gcharvin/esp32_temperature_controller_platformio/hardware/manufacturing/online_quote_20261110/placement_B_preview.png

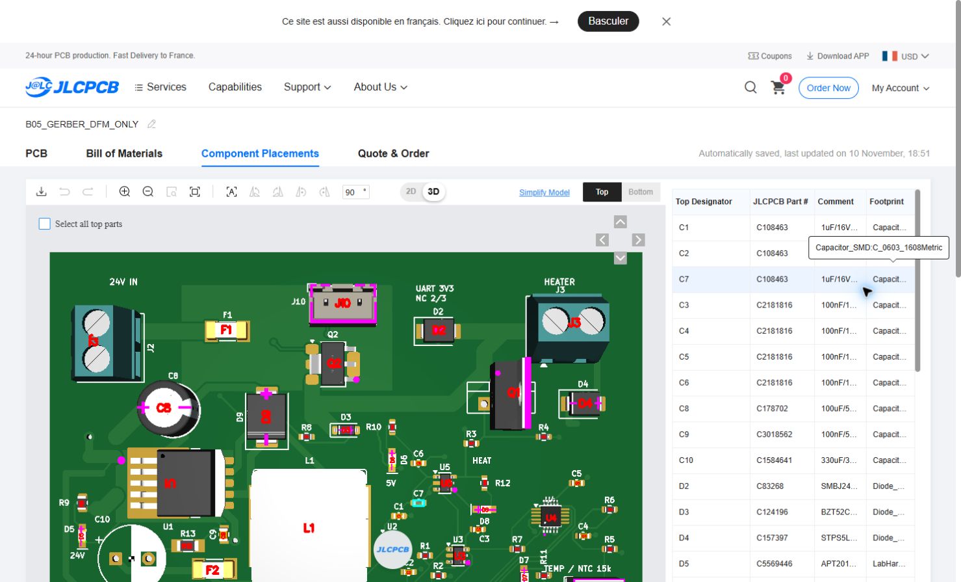
hardware/manufacturing/online_quote_20261110/placement_B_preview.png
