gcharvin/esp32_temperature_controller_platformio/hardware/review/stock_revision_pcb_B_3d.png

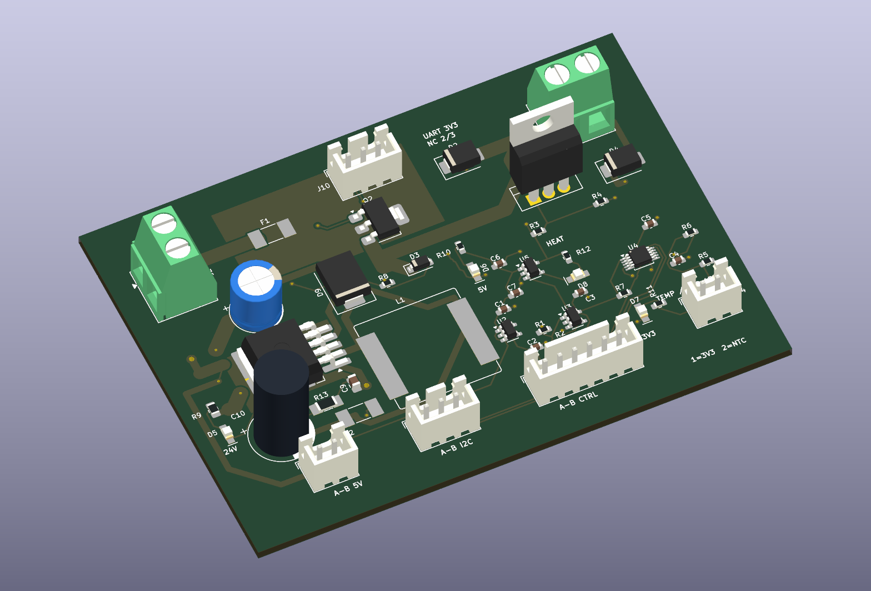
hardware/review/stock_revision_pcb_B_3d.png
