gcharvin/esp32_temperature_controller_platformio/hardware/review/pcb_a_display.pdf

1 | 2 | 3 | 4 | 5 | 6 | 7 | 8
1 | 2 | 3 | 4 | 5 | 6 | 7 | 8

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
## FG Date: 2026-11-05

Size: User | Rev: 0.4
KiCad E.D.A. 10.0.6 | Id: 1/1

# Title: PCB A - Display and ESP32 carrier

## File: pcb_a_display.kicad_sch

## Sheet: /

## Laboratory hardware platform

## PROTOTYPE - ENGINEERING PREPARED - ASSEMBLER APPROVAL REQUIRED

EN 1 | GPIO36 2 | GPIO39 3 | GPIO34 4 | GPIO35 5 | GPIO32 6 | GPIO33 7 | GPIO25 8 | GPIO26 9 | GPIO27 10 | GPIO14 11 | GPIO12 12 | GPIO13 13 | GND 14

VIN 15

3V3 | 16 GND | 17 GPIO15 | 18 GPIO2 | 19 GPIO4 | 20 GPIO16 | 21 GPIO17 | 22 GPIO5 | 23 GPIO18 | 24 GPIO19 | 25 GPIO21 | 26 GPIO3 | 27 GPIO1 | 28 GPIO22 | 29 GPIO23 | 30 U1

### ESP32 USB-C / 30P user module

R3

10kC2

1uF | #FLG01 PWR_FLAG

1
2

J1
A-B POWER / XH-2 | #FLG02 PWR_FLAG

R2
10k | 1

2
3
4

### J5BH1750 module / addr 0x23

### #FLG03 PWR_FLAG

1
2
3

J6

### A-B I2C / XH-3

1
2

JP1

5V DevKit link / remove for service

R6
1.5k / 1% / 0.1W

C1
1uF

D2

### APT2012LZGCK

R1

10k | 1
| 2
| 3
| 4

J4

### TMP117 module / addr 0x48

1
2
3
4

J2

### LCD20x4 + backpack / 3V3 R5

4.7k D1

### APT2012LZGCK

### VIN 1 GND

2

EN 3

### VOUT 5 U2 AP2112K-3.3 peripherals 1

2
3
4

J3

### Encoder / A B SW GND

R7
470R / 1% / 0.1W

1
2
3
4
5
6

J7

### A-B CTRL / XH-6 C3

# 10uF R4

4.7k +3V3_A

I2C_SDA

I2C_SCL

LED_A_D1

GND | +5V_AB GND

GND

PWM0

ENABLE

FAULT_N

PWM1 GND LED_A_D2 +3V3_A ENC_B | +3V3_A ENC_SW
DIN0 +3V3_A | +5V_DEVKIT I2C_SDA
ENC_A | GND +3V3_A I2C_SCL | GND +3V3_A

I2C_SDA

I2C_SCL

DIN0

GND

FAULT_N

PWM0 PWM1

ENABLE

+3V3_A

I2C_SDA

# I2C_SCL GND

I2C_SDA

I2C_SCL

+3V3_A | +3V3_A
GND | GND
+5V_DEVKIT | +5V_AB GND | +3V3_A

+5V_AB

GND +5V_DEVKIT | +5V_AB +5V_AB

GND

# ENC_A GND

# ENC_B GND

# I2C_SDA +5V_AB

I2C_SCL ENC_SW +5V_AB

ENC_B

ENC_SW

# GND +3V3_A ENC_A +5V_AB

# A3 - USER INPUT / I2C PERIPHERALS

Green LEDs show rail presence only, not regulated voltage accuracy or ESP32 execution. HEAT (B/D8): 5 V driver output after PWM AND ENABLE; brightness follows duty, NOT measured heater current. NTC on B/J4: 1 = +3V3_B, 2 = NTC_RAW; passive two-wire 15k B3920 probe, either wire orientation.

JP1 fitted in normal use. Do not parallel external 5 V and USB VBUS. USB maintenance: B off, disconnect J1/J6/J7, remove JP1; no peripheral operation in this mode. Powered serial debugging requires a verified VBUS-isolated USB connection. No automatic power mux. A2 - LOCAL POWER / LCD 3.3 V AS CURRENT PROTOTYPE

U1 is a removable DevKit, not a bare ESP32. Common 30P pinout; row spacing25.40mm confirmed. Two Harwin M20-7821546 sockets. | J1 POWER: 1 GND / 2 +5V. J6 I2C: 1 GND / 2 SDA / 3 SCL. J7 CTRL: 1 GND / 2 PWM0 / 3 ENABLE / 4 FAULT_N / 5 PWM1 / 6 DIN0. Straight-through cables, JST-XH 2.50 mm. NO 24 V, heater current or 3V3 rail. A1 - HOST AND COMMON INTERFACE / LOGIC 3.3 V

## D2 / 3V3_A

# DIAGNOSTICS - RAIL PRESENCE AND HEATER GATE DRIVE

Only R4/R5 are the main I2C pull-ups. Remove or account for pull-ups on all breakout modules and LCD. DevKit 3V3 is not joined to +3V3_A. U2 supplies peripherals only; check current and thermal budget.

I2C cable A-B: short internal harness. ADC on B = 0x49, TMP117 on A = 0x48.

LCD header order is a proposed cable order. Check actual backpack pin order, 3.3 V operation

and backlight current before PCB layout.

## D1 / 5V_AB
