gcharvin/esp32_temperature_controller_platformio/hardware/review/implantation_v01.pdf

# Carte A : facade et ESP32

110 x 75 mm | epaisseur proposee 1.6 mm | vue cote composants

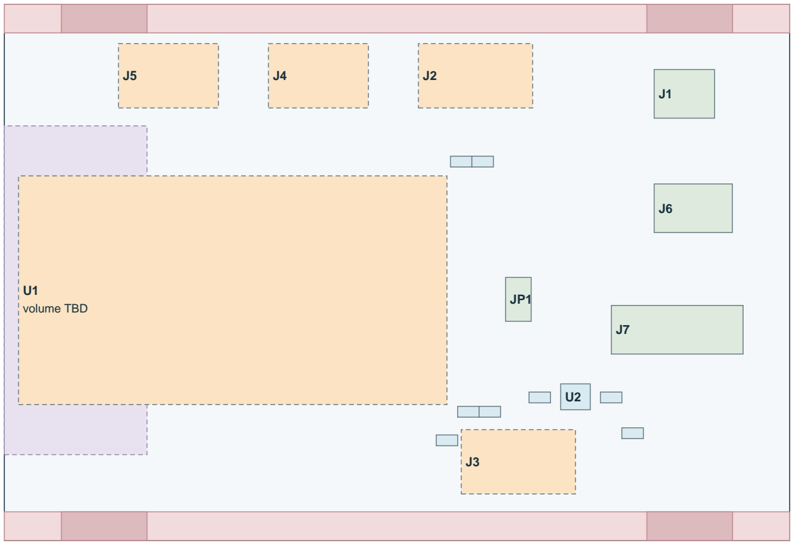
[picture p3: figure]
U1 volume TBD

ETUDE 0.1 - COTES PROPOSEES - NON ROUTE - NE PAS FABRIQUER | 1/3

110 mm

Hauteur 75 mm ; origine (0,0) en haut a gauche.

### Fixation sans vis

Bandes haut/bas : 4 mm.
Zones de contact : 12 x 4 mm. Appuis fixes + clips liberables. Pas de trous imposes a ce stade.

### Connecteurs vers arriere

J1 : 5 V / JST-XH 2 points.
J6 : I2C / JST-XH 3 points.
J7 : commandes / XH 6 points. Degagement axial vise : 25 mm. Cables debranches hors tension.

DevKit : volume 60 x 32 mm. Antenne au bord gauche.
USB : zone de service interne. LCD et encodeur sur facade, relies par cables a A.

Legende

TBD, sans pastilles

Empreinte connecteur

Empreinte CMS connue

Les rectangles representent les encombrements au sol ; reperes R/C detailles dans KiCad.

# Carte B : temperature et puissance

90 x 65 mm | epaisseur proposee 1.6 mm | vue cote composants
ETUDE 0.1 - COTES PROPOSEES - NON ROUTE - NE PAS FABRIQUER | 2/3

90 mm

Hauteur 65 mm ; origine (0,0) en haut a gauche.

U1
volume TBD

U2

U3

U4 Q1

J2 | F1 | D1 | D2 | J3

J4

J1 | J6 | J7

### Fixation sans vis

Bandes haut/bas : 4 mm.
Zones de contact : 12 x 4 mm. Appuis fixes + clips liberables. Pas de trous imposes a ce stade.

### Connecteurs vers arriere

J1 : 5 V / JST-XH 2 points.
J6 : I2C / JST-XH 3 points.
J7 : commandes / XH 6 points. Degagement axial vise : 25 mm. Cables debranches hors tension.

Puissance en partie haute.
ADC / sonde a droite.
Buck reserve : 30 x 22 mm. B se retire vers arriere.
Dissipation a dimensionner.

Legende

TBD, sans pastilles

Empreinte connecteur

Empreinte CMS connue

Les rectangles representent les encombrements au sol ; reperes R/C detailles dans KiCad.

# Boitier propose : deux logements independants

145 L x 100 H x 115 P mm exterieurs | parois 3 mm | schema mecanique de principe
ETUDE 0.1 - COTES PROPOSEES - NON ROUTE - NE PAS FABRIQUER | 3/3

## Facade, vue de face

145 mm

LCD : reserve 98 x 60

Encodeur

H = 100 mm ; decoupe LCD exacte a mesurer.

LCD 98 x 60 mm : exemple de format courant, pas une mesure de ton module. Fenetre optique et bouton representes a titre indicatif.
Facade / LCD sur leur propre berceau, sans appui sur la DevKit.

## Coupe laterale (profondeur)

115 mm

LCD

A
B

AR amovible

Plans composants A/B a 45 / 85 mm. Budget composants arriere : 20 mm. Service JST : 25 mm, couvercle ouvert. B extractible sans deposer A / facade. Jeux et clips : essais imprimes requis.
