gcharvin/esp32_temperature_controller_platformio/hardware/power_study/buck_5v/buck_5v.pdf

1 | 2 | 3 | 4 | 5 | 6 | 7 | 8
1 | 2 | 3 | 4 | 5 | 6 | 7 | 8

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
Size: A3 | Rev: 0.1 STUDY | F Date: 2026-11-05
KiCad E.D.A. 10.0.6 | Id: 1/1

# Title: STUDY ONLY - Integrated 24V to 5V buck for PCB B

## File: buck_5v.kicad_sch

## Sheet: /

R1
100k / 0805

1
2

### JP1 CLOSE TO DISABLE BUCK

R2

### 100k / 1% GND

1

### VIN 2

EN 3 | PG | 4
| FB | 5
VCC 6 | BOOT | 7
SW | 8 U1

### LMR36520ADDAR

C7

### 22uF / 25V X5R

### #FLG3 PWR_FLAG

### #FLG1 PWR_FLAG

C2

4.7uF / 100V X7S | C3 220nF / 100V X7R

L1

### 10uH / XAL6060-103MEC

C8

### 22uF / 25V X5R

C9

### 22uF / 25V X5R

R4
100k / 1%

1
2

J2

### TO B / F2 INPUT #FLG2 PWR_FLAG

R3
24.9k / 1%

1
2

J1
FROM B / protected input | C1
4.7uF / 100V X7S | C4

# 100nF / 25V C5

1uF / 25V | C6 22uF / 25V X5R
VIN_PROTECTED | GND | GND BUCK_EN | VIN_PROTECTED
BUCK_EN | BOOT
VCC_INTERNAL | SW
PG_5V_TP | VIN_PROTECTED | +5V_BUCK GND

BUCK_EN

FB GND | +5V_BUCK
BOOT SW | VIN_PROTECTED

GND

VIN_PROTECTED | VIN_PROTECTED
GND | GND | GND +5V_BUCK | +5V_BUCK GND | GND VIN_PROTECTED | +5V_BUCK GND +5V_BUCK | FB GND VCC_INTERNAL | PG_5V_TPFB | +5V_BUCK

GND

SW | GND | +5V_BUCK | +5V_BUCK

No manufacturing release: PCB layout, capacitor DC bias, thermal pad/vias, USB power sharing, sourcing and bench tests pending.

## POWER STUDY 0.1 - 5V / 0.8A SYSTEM TARGET, 2A CONVERTER RATING

OUTPUT: +5V_BUCK -> existing F2 (1A) -> +5V_AB -> A/B electronics. Heater power stays on protected 24V. VCC_INTERNAL is not an external 5V output. PG_5V_TP is a 5V-domain scope point, not ESP32-safe. Final integration must pull PG to 3V3 if used by MCU, and deliberately connect logic/power returns; no CC shunt remains.

Proposal only: not installed or routed on PCB B v0.4. Read README.md before integration. Protected 24V input. Common ground proposal replaces the external CC/CV module and its possible shunt.

Nominal output: 1V * (1 + 100k / 24.9k) = 5.016V. 4 x 22uF output bank; simulate 44uF effective worst case. Model: TI SNVMBX7A / LMR36520A_TRANS, unencrypted PSpice. Temperature and enclosure cooling are not modeled. Native ngspice attempts are documented as NON-CONVERGENT, not successful functional validation.
