gcharvin/esp32_temperature_controller_platformio/hardware/mechanical/exports/preview_b_power.png

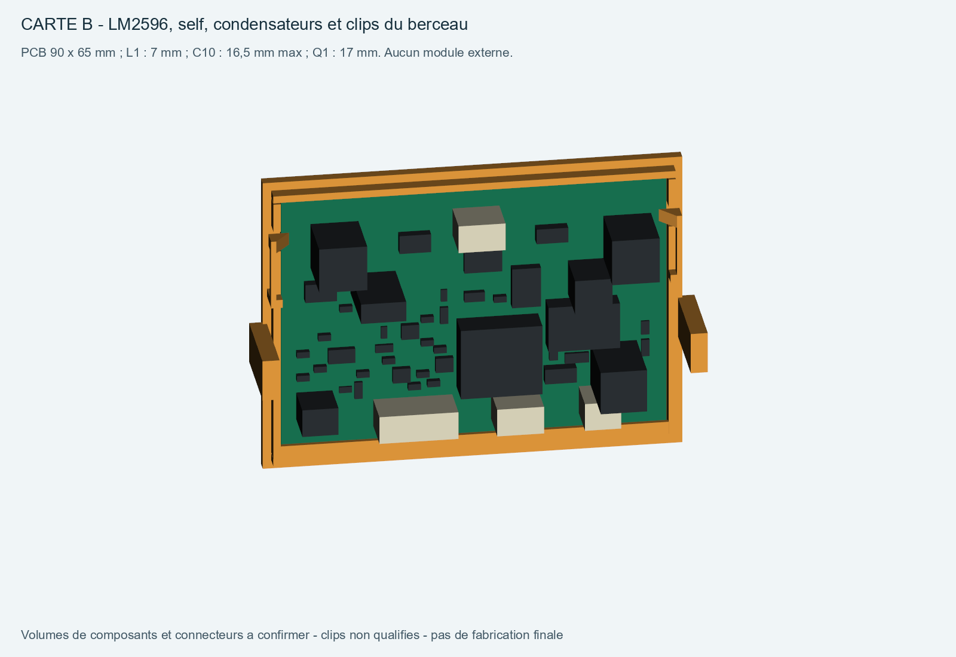
hardware/mechanical/exports/preview_b_power.png
