gcharvin/esp32_temperature_controller_platformio/hardware/mechanical/exports/preview_buck.png

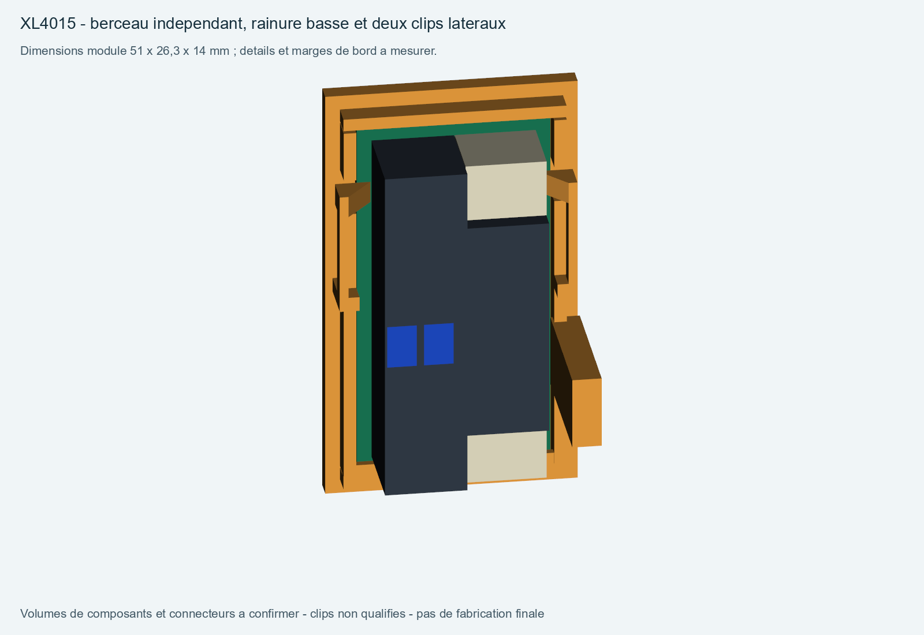
hardware/mechanical/exports/preview_buck.png
