gcharvin/esp32_temperature_controller_platformio/hardware/mechanical/exports/preview_front_module.png

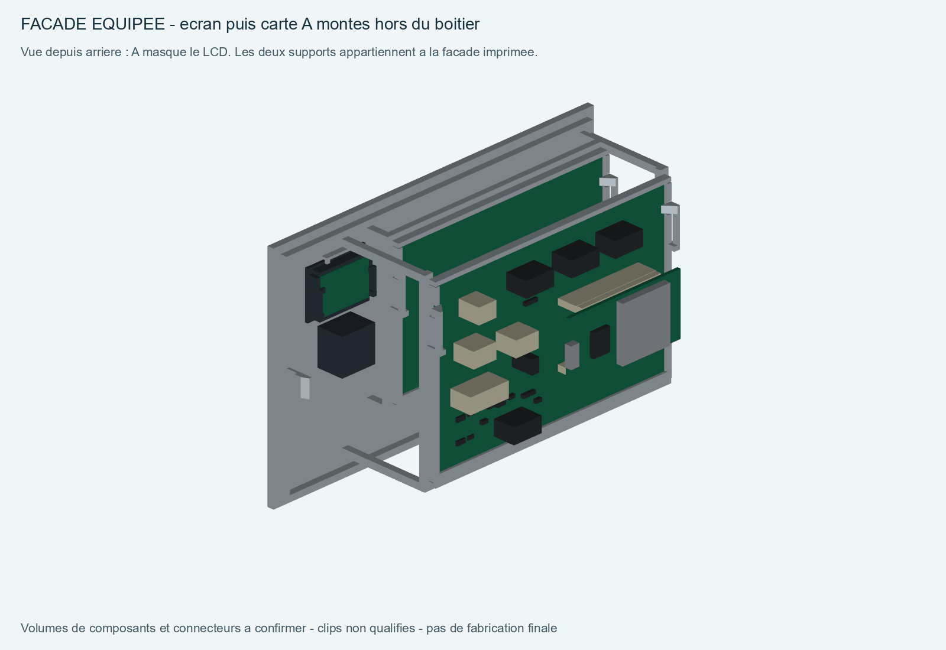
hardware/mechanical/exports/preview_front_module.png
