gcharvin/esp32_temperature_controller_platformio/hardware/mechanical/exports/preview_lcd_mount.png

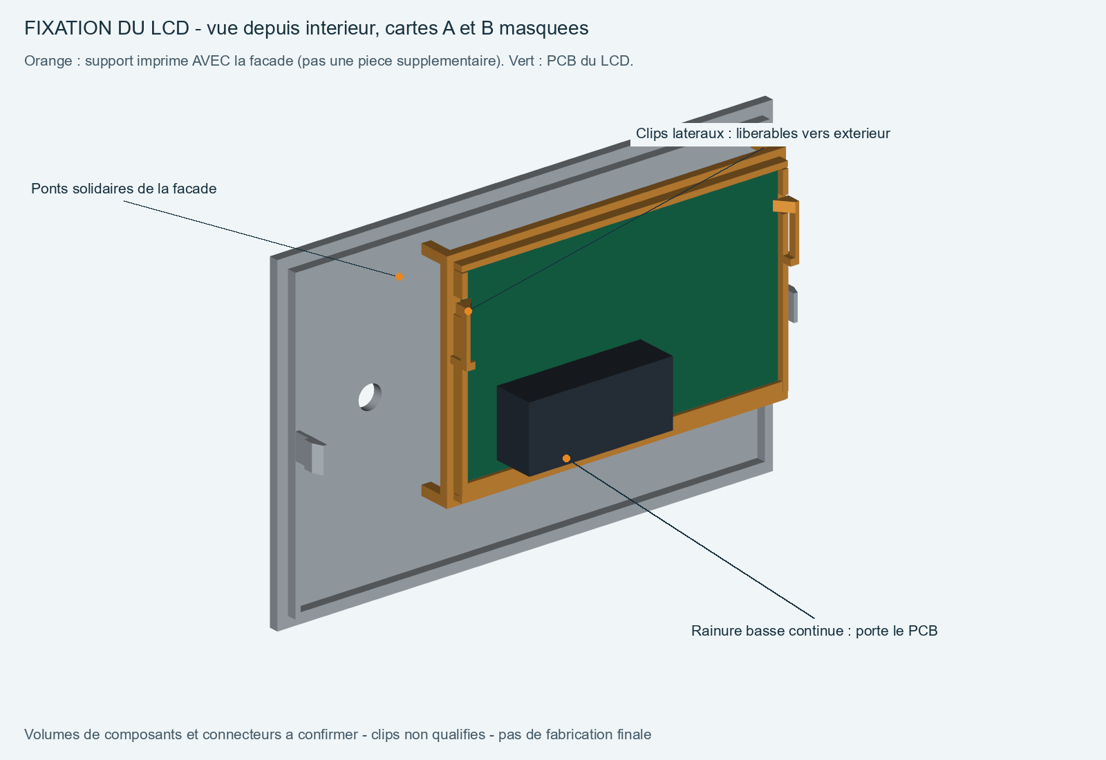
hardware/mechanical/exports/preview_lcd_mount.png
