gcharvin/esp32_temperature_controller_platformio/hardware/mechanical/exports/preview_light_sensor.png

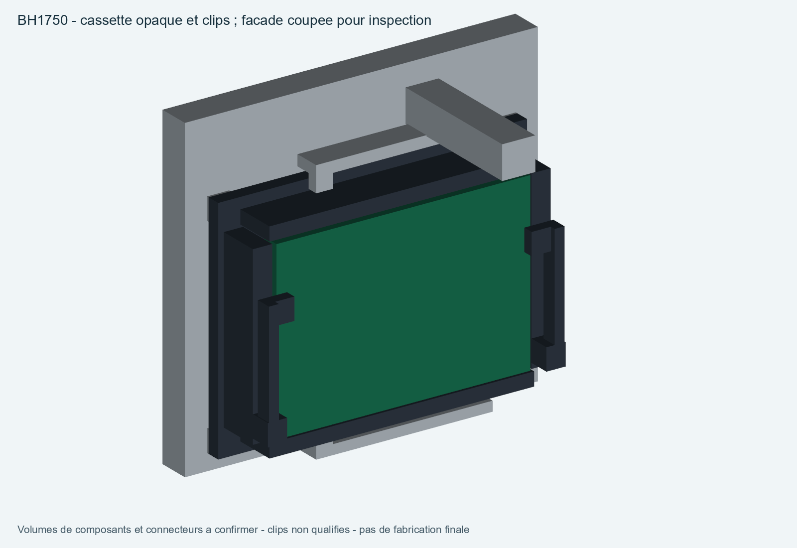
hardware/mechanical/exports/preview_light_sensor.png
