gcharvin/esp32_temperature_controller_platformio/hardware/mechanical/exports/preview_light_sensor_front.png

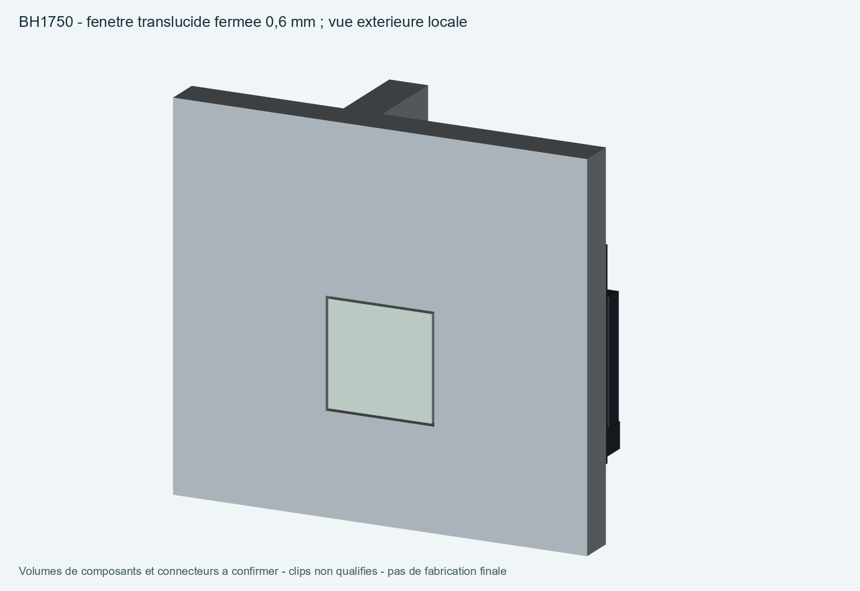
hardware/mechanical/exports/preview_light_sensor_front.png
