gcharvin/esp32_temperature_controller_platformio/hardware/mechanical/exports/preview_rear.png

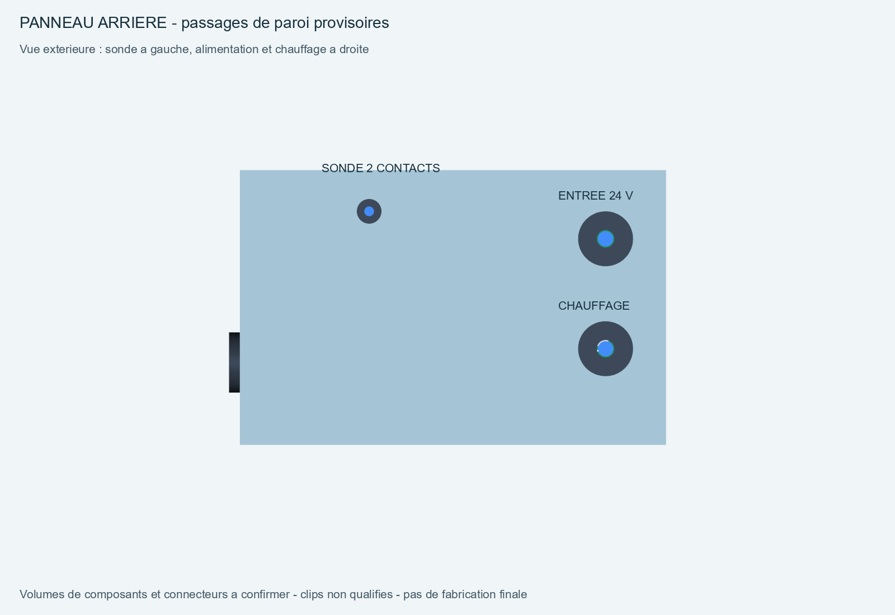
hardware/mechanical/exports/preview_rear.png
