gcharvin/esp32_temperature_controller_platformio/hardware/mechanical/exports/preview_service.png

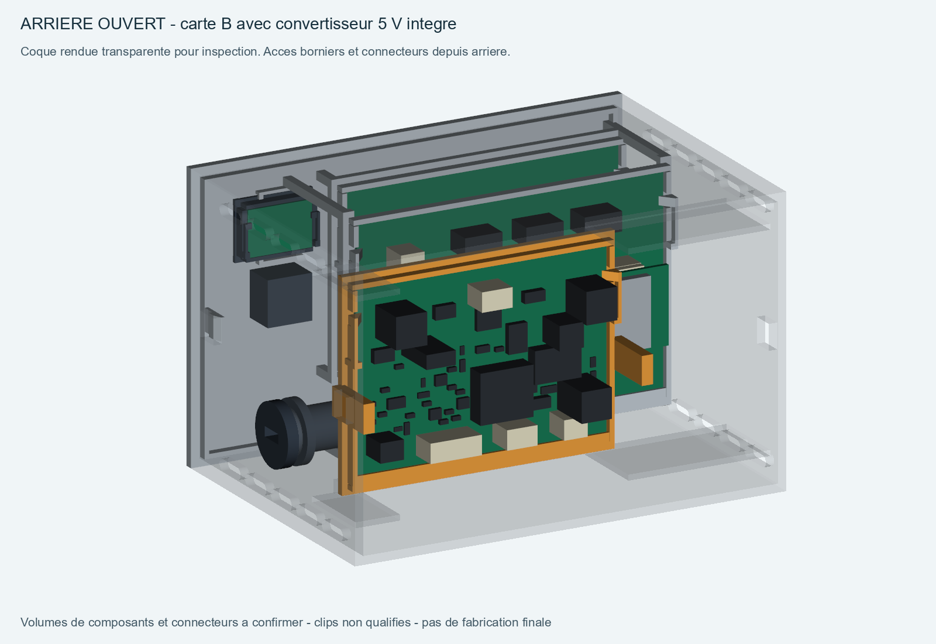
hardware/mechanical/exports/preview_service.png
