gcharvin/esp32_temperature_controller_platformio/hardware/mechanical/exports/preview_side_vents.png

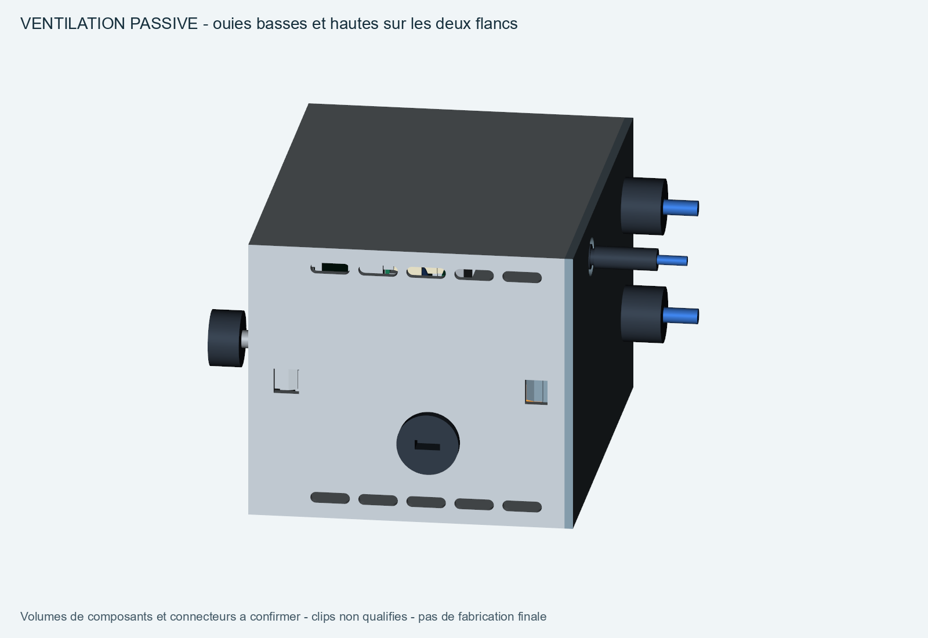
hardware/mechanical/exports/preview_side_vents.png
