gcharvin/esp32_temperature_controller_platformio/hardware/mechanical/exports/preview_usb.png

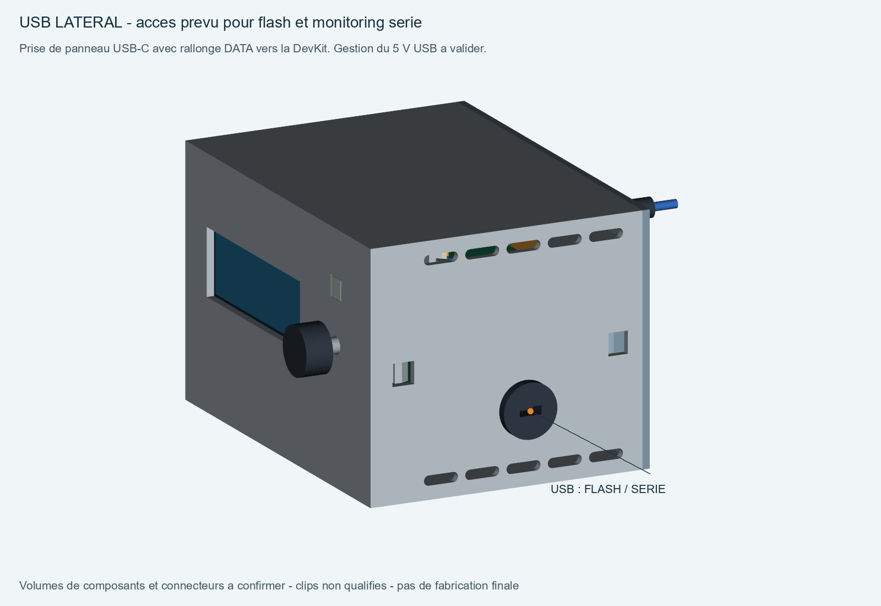
hardware/mechanical/exports/preview_usb.png
