gcharvin/esp32_temperature_controller_platformio/PartList_PCB_A_B_v2.xlsx

Sheet: PCB_A_UI
Item | Sous-systeme | Reference type | MPN (primary) | LCSC | Mouser | Prix unitaire USD (indicatif) | Empreinte KiCad | Qte | Statut | Notes | Assemble_JLC | JLC_Type | LCSC_Status | JLC_Notes
A1 | Cerveau | ESP32 DevKit NodeMCU (ELEGOO CP2102, USB-C) | ESP32-DEVKITC-32D (ou equivalent) | N/A | N/A | 6.00-12.00 | Connector_PinSocket_2.54mm:PinSocket_1x15_P2.54mm_Vertical (x2) | 1 | Obligatoire | Conforme au setup actuel: board nodemcu-32s. DevKit achete assemble. | No | N/A | N/A | Module externe (DevKit complet)
A2 | Support DevKit | Headers femelles 2x15, pas 2.54 mm | SSW-115-01-T-S (ou equivalent) | TBD | TBD | 0.30-1.20 | Connector_PinSocket_2.54mm:PinSocket_1x15_P2.54mm_Vertical | 2 | Obligatoire | Verifier entraxe exact du modele DevKit retenu. | No | N/A | N/A | Connecteur mecanique, option selon strategie assemblage
A3 | Entree alim | Bornier VIN 2 pins 5.08 mm | KF301-2P (ou equivalent) | TBD | TBD | 0.08-0.35 | TerminalBlock_Phoenix:TerminalBlock_Phoenix_MKDS-1,5-2_5.08mm | 1 | Obligatoire | VIN cible 12V, marge recommandee jusqu a 24V. | Yes | THT/Manual | Missing | Completer un code LCSC (Cxxxx) pour PCBA auto.
A4 | Conversion puissance | Buck VIN -> 5V | MP1584EN module (ou LM2596 module) | TBD | TBD | 1.20-3.50 | Custom_Module_Footprint | 1 | Obligatoire | Alimente pin 5V du DevKit et peripheriques 5V. | No | N/A | N/A | Module buck pre-assemble ou design discret a figer
A5 | Protection entree | TVS + polyfuse + PMOS anti inversion | SMBJ33A + MF-MSMF050 + AO4407A | TBD | TBD | 0.70-1.50 | D_SMB + Fuse_1812_4532Metric + SO-8_3.9x4.9mm_P1.27mm | 1 | Recommande | Dimensionner selon courant max et tension transitoire. | Yes | SMT+THT mix | Missing | Completer un code LCSC (Cxxxx) pour PCBA auto.
A6 | Affichage | LCD 20x4 HD44780 + backpack I2C PCF8574 | WC2004A + PCF8574T module | TBD | TBD | 4.00-8.00 | Custom_Module_Footprint | 1 | Obligatoire | Utilise par firmware via hd44780_I2Cexp. | No | N/A | N/A | Module LCD + backpack souvent hors catalogue SMT standard
A7 | Temperature ambiance | TMP117 (I2C) | TMP117NAIDRVR | TBD | 595-TMP117NAIDRVR | 4.25 | Package_DFN_QFN:WSON-6-1EP_2x2mm_P0.5mm | 1 | Obligatoire | Adresses firmware: 0x48..0x4B. | Yes | SMT | Missing | Completer un code LCSC (Cxxxx) ou choisir capteur dispo JLC.
A8 | Lumiere ambiance | BH1750 (I2C) | BH1750FVI-TR | TBD | 755-BH1750FVI-TR | 1.00-2.20 | Package_SO:SOIC-6_3.9x4.9mm_P1.27mm (ou module breakout) | 1 | Obligatoire | Adresses firmware: 0x23/0x5C. | Yes | SMT | Missing | Completer un code LCSC (Cxxxx) pour PCBA auto.
A9 | UI entree | Encodeur rotatif + bouton | EC11E18244A5 (exemple) | TBD | TBD | 0.40-1.60 | Rotary_Encoder:RotaryEncoder_Alps_EC11E-Switch_Vertical_H20mm | 1 | Obligatoire | GPIO firmware: A=4, B=19, SW=23. | No | N/A | N/A | Encodeur THT, souvent manuel/wave
A10 | Bus I2C | Pull-up externes 3.3V (4.7k) SDA/SCL | RC0603FR-074K7L | C23162 | 603-RC0603FR-074K7L | 0.01 | Resistor_SMD:R_0603_1608Metric | 2 | Obligatoire | Mettre sur PCB A. Pull-ups internes ESP32 insuffisants pour robustesse bus. | Yes | SMT Basic (si code LCSC valide) | OK | Pret cote reference LCSC (verifier stock JLC).
A11 | Interconnexion A-B | JST-XH 20 pins (ou 2x10) | B20B-XH-A(LF)(SN) | TBD | 455-B20B-XH-A | 1.65 | Connector_JST:JST_XH_B20B-XH-A_1x20_P2.50mm_Vertical | 1 | Obligatoire | Alternative: 2x B10B-XH-A (Mouser 455-B10B-XH-A, ~0.79/pc). | Yes | THT/Manual | Missing | Completer un code LCSC (Cxxxx) pour PCBA auto.
A12 | Ports extension | Connecteurs I2C externes 4p/6p | B4B-XH-A(LF)(SN) + B6B-XH-A(LF)(SN) | TBD | 455-B4B-XH-A / 455-B6B-XH-A | 0.31-0.43 | Connector_JST:JST_XH_B4B-XH-A_1x04_P2.50mm_Vertical + JST_XH_B6B-XH-A_1x06_P2.50mm_Vertical | 1 | Optionnel | Ajouter ESD + resistances serie 33-100R sur ports externes. | Yes | THT/Manual | Missing | Completer un code LCSC (Cxxxx) pour PCBA auto.

Sheet: PCB_B_Metier
Item | Sous-systeme | Reference type | MPN (primary) | LCSC | Mouser | Prix unitaire USD (indicatif) | Empreinte KiCad | Qte | Statut | Notes | Assemble_JLC | JLC_Type | LCSC_Status | JLC_Notes
B1 | Interconnexion A-B | Connecteur mating cable | XHP-20 + SXH-001T-P0.6 (ou 2x XHP-10) | TBD | 455-XHP-20 / 455-SXH-001T-P0.6 | 0.55 + contacts | Cable_harness (pas footprint PCB) | 1 | Obligatoire | A appairer avec le header JST XH cote PCB A. | No | N/A | N/A | Connectique cable/harness, pas composant SMT carte
B2 | Capteur process | Thermistance sonde NTC 15k B3920 | NTC_15K_B3920_PROBE (selection a figer) | TBD | TBD | 0.60-3.00 | Connector + strain relief (selon sonde) | 1 | Obligatoire | Le firmware est calibre pour 15k et B~3920. | No | N/A | N/A | Sonde externe (off-board)
B3 | Pont NTC | Resistance fixe ~8.4k 1% | RC0603FR-078K45L (ou 8.2k + calibration) | TBD | TBD | 0.01 | Resistor_SMD:R_0603_1608Metric | 1 | Obligatoire | Firmware divisorValue=8400. Ajustable par calibration logicielle. | Yes | SMT Basic (si code LCSC valide) | Missing | Completer un code LCSC (Cxxxx) pour PCBA auto.
B4 | Commande chauffe | MOSFET N canal low-side 3.3V | IRLZ44NPBF / IRLB8721PBF / IRLB3034PBF / AO3400A | TBD | 844-IRLZ44NPBF / 942-IRLB8721PBF / 942-IRLB3034PBF | 0.03-2.39 | TO-220-3_Vertical (ou SOT-23 pour AO3400A) | 1 | Obligatoire | Voir onglet MOSFET_3V3 pour comparaison detaillee. | Yes | THT (TO-220) ou SMT (AO3400A) | Missing | Completer un code LCSC (Cxxxx) pour PCBA auto.
B5 | Commande grille | Rgate + pull-down gate | RC0603FR-07100RL + RC0603FR-07100KL | TBD | 603-RC0603FR-07100RL / 603-RC0603FR-07100KL | 0.01+0.01 | Resistor_SMD:R_0603_1608Metric | 1 | Obligatoire | Rgate typ 100R; pull-down typ 100k. | Yes | SMT Basic (si code LCSC valide) | Missing | Completer un code LCSC (Cxxxx) pour PCBA auto.
B6 | Sortie charge | Bornier puissance 2 pins | KF301-2P (ou borne plus forte intensite) | TBD | TBD | 0.08-0.60 | TerminalBlock_Phoenix:TerminalBlock_Phoenix_MKDS-1,5-2_5.08mm | 1 | Obligatoire | Dimensionner selon courant chauffage reel. | No | N/A | N/A | Bornier THT, souvent manuel/wave
B7 | Protection puissance | Fusible + TVS/diode selon charge | SMBJxxA + fuse (valeur selon courant) | TBD | TBD | 0.40-1.20 | D_SMB + Fuse footprint | 1 | Recommande | Choisir tension TVS selon bus, fusible selon Imax. | Yes | SMT/THT selon choix | Missing | Completer un code LCSC (Cxxxx) pour PCBA auto.
B8 | Mesure analogique | Filtrage RC NTC | 1k + 100nF X7R | TBD | TBD | 0.02 | R_0603 + C_0603_1608Metric | 1 | Recommande | Limite bruit ADC et aliasing sur lecture temperature. | Yes | SMT Basic (si codes LCSC valides) | Missing | Completer un code LCSC (Cxxxx) pour PCBA auto.
B9 | Identification carte | EEPROM I2C | AT24C32D-SSHM-T | TBD | 556-AT24C32D-SSHM-T | 0.35-0.80 | Package_SO:SOIC-8_3.9x4.9mm_P1.27mm | 1 | Optionnel | Peut stocker ID_B, calibration, revision. | Yes | SMT | Missing | Completer un code LCSC (Cxxxx) pour PCBA auto.
B10 | Conversion precision | ADC I2C 16-bit | ADS1115IDGSR | TBD | 595-ADS1115IDGSR | 2.20-3.80 | Package_SO:VSSOP-10_3x3mm_P0.5mm | 1 | Optionnel | Utile si precision mesure > ADC ESP32 requise. | Yes | SMT | Missing | Completer un code LCSC (Cxxxx) pour PCBA auto.
B11 | Securite | Sortie FAULT open-drain | LMV331IDBVR (ou MMBT3904 + reseau) | TBD | 595-LMV331IDBVR | 0.20-0.60 | Package_TO_SOT_SMD:SOT-23-5 (ou SOT-23) | 1 | Optionnel | Permet remonter defaut vers PCB A (FAULT/INT). | Yes | SMT | Missing | Completer un code LCSC (Cxxxx) pour PCBA auto.

Sheet: MOSFET_3V3
Option | MPN | Mouser | LCSC | Boitier | Compatibilite gate 3.3V | Rds(on) indicatif | Qg indicatif | Prix USD indicatif | Avantages | Limites | Usage conseille | Recommended_for_this_project
IRLZ44N (actuel) | IRLZ44NPBF | 844-IRLZ44NPBF | TBD | TO-220 | Oui en pratique, mais pas le plus optimise a 3.3V | Plutot eleve vs MOSFET recents | Eleve | 1.31 | Robuste, facile a souder, dispo large | Pertes plus fortes, gate charge elevee | Prototype, PWM 500 Hz, courant modere | Current baseline
Option 1 (drop-in recommande) | IRLB8721PBF | 942-IRLB8721PBF | TBD | TO-220 | Tres bon en logique-level | Faible | Moyen-eleve | 1.70 | Moins de chauffe a courant egal | Toujours boitier traversant volumineux | Remplacement direct de IRLZ44N en TO-220 | Yes
Option 2 (fort courant) | IRLB3034PBF | 942-IRLB3034PBF | TBD | TO-220 | Excellent en logique-level | Tres faible | Tres eleve | 2.39 | Tres faible perte conduction | Gate tres capacitive sans driver | Courants eleves, bonne dissipation | Optional
Option 3 (compact SMD) | AO3400A | TBD | TBD | SOT-23 | Oui (2.5V/3.3V) | Faible a moyen | Faible | 0.02-0.08 | Compact, commande facile depuis GPIO | Limite thermique boitier SOT-23 | Petites charges ou carte compacte | Optional
Regle de choix |  |  |  |  |  |  |  |  |  |  | Prendre un MOSFET avec Rds(on) spec a Vgs=2.5V/4.5V. Verifier P=I^2*Rds(on), temperature jonction, et marge thermique. | Guideline

Sheet: I2C_pullups
Question | Reponse courte | Detail pratique
Pull-up interne I2C sur ESP32 ? | Oui, mais faible (ordre ~20k a 50k). | Utile en depannage, mais trop faible pour un bus robuste avec cables/capacitance.
Faut-il des pull-ups externes ? | Oui, recommande. | Typique: 4.7k vers 3.3V sur SDA/SCL. Ajuster 2.2k a 10k selon bus et vitesse.
Plusieurs modules avec pull-ups deja presents ? | Eviter le cumul en parallele. | Conserver un seul jeu principal sur PCB A; mettre DNP/straps ailleurs.
Dans ce projet | Bus I2C a 50 kHz dans firmware. | Wire.setClock(50000) aide la marge, mais ne remplace pas des pull-ups externes.

Sheet: Notes_prix
Champ | Valeur
Date extraction | 2026-02-11
Monnaie | USD
Quantite prix | 1 piece (indicatif)
Avertissement | Prix et stock changent vite. Verifier sur panier fournisseur avant commande.
Source exemples Mouser | TMP117NAIDRVR, IRLZ44NPBF, IRLB8721PBF, IRLB3034PBF, B20B-XH-A, B10B-XH-A
LCSC | Colonnes laissees TBD quand reference exacte non confirmee.
PCBA JLC | Utiliser Assemble_JLC=Yes comme scope; chaque ligne Yes doit avoir LCSC Cxxxx valide.
