gcharvin/esp32_temperature_controller_platformio/hardware/manufacturing/system_bom_review.csv

Item | Quantity_per_system | Description | Reference_or_candidate | Supply_status | Assembly | Remaining_check | Purchase_action_FR | Product_or_supplier_URL | Amazon_URL | Link_status_FR | Purchase_notes_FR | Links_reviewed_on | Preferred_supplier_FR | Procurement_status_FR | Harness_completion_FR
PCB_A | 1 | Display board A v0.4 | See review_A04_B05/A | RFQ draft | Factory SMT plus THT | DevKit dimensions and approved purchasing references | Fourni par le fabricant dans le devis PCBA |  |  | Sans achat séparé | Utiliser la BOM/CPL usine ; aucun panier de composants supplémentaire pour les pièces montées sur A. | 2026-11-09 | Fabricant PCBA — déjà au devis | Hors achats client
PCB_B | 1 | Temperature board B v0.5 24V | See review_A04_B05/B | RFQ draft | Factory SMT plus THT | Electrical review and approved purchasing references | Fourni par le fabricant dans le devis PCBA |  |  | Sans achat séparé | Utiliser la BOM/CPL usine ; LM2596, LED et connecteurs PCB inclus dans le périmètre usine. | 2026-11-09 | Fabricant PCBA — déjà au devis | Hors achats client
DEVKIT | 1 | User-owned30P ESP32 USB-C, three common-pinout variants | B0DGLCWR76 | Customer supplied; common pinout and25.40mm rows confirmed | Plug into two sockets after assembly | Actual body, male-header plastic, insertion and USB power path at integration | Déjà acheté — réutiliser | https://www.amazon.fr/dp/B0DGLCWR76 | https://www.amazon.fr/dp/B0DGLCWR76 | Lien fourni par l'utilisateur ; fiche Amazon non relue (accès refusé) | ESP32 classique 30 contacts, entraxe 25,40 mm confirmé. Contrôler le brochage et le corps réel ; ne pas remplacer par C3/S3 ou 38 contacts. | 2026-11-09 | Déjà acheté — Amazon historique | Réutiliser le matériel existant
DEVKIT_SOCKETS | 2 | Female 1x15 2.54mm height8.5mm | PM254-1-15-Z-8.5 | HCTL / C2897378; factory quote | Factory THT under U1 not a single centroid | Native holes1.05mm documented; confirm factory finished-hole tolerance and actual module insertion | Monté en usine — ne pas acheter en double |  |  | Référence usine inchangée | 2 HCTL PM254-1-15-Z-8.5 par A, inclus dans la BOM d'assemblage ; ne pas acheter en double. | 2026-11-10 | Fabricant PCBA — déjà au devis | Hors achats client
JP1_SHUNT | 1 | Removable 2.54mm two-contact shunt | M7566-05 | Exact MPN; not included in online PCBA price | Delivered loose; fit for external operation with USB disconnected | Mechanical height and access to approve | Approvisionnement séparé à prévoir — hors devis PCBA |  |  | Référence usine inchangée | Harwin M7566-05, 1 par A ; cavalier amovible non monté. Cinq nécessaires pour le lot, hors CPL et hors montant PCBA affiché. | 2026-11-10 | À confirmer | À approvisionner séparément
LCD | 1 | LCD20x4 and I2C backpack used at3.3V | Freenove LCD2004 / B0B76VGXYH | User-owned module identified; see display_backlight_study.md | Clip into removable front | Exact board dimensions contrast backlight current and pinout | Déjà acheté — réutiliser | https://www.amazon.fr/dp/B0B76VGXYH | https://www.amazon.fr/dp/B0B76VGXYH | Lien fourni par l'utilisateur ; fiche Amazon non relue (accès refusé) | Freenove LCD2004 avec backpack I2C. Utilisation prévue à 3,3 V, rétroéclairage fixe avec extinction ; cotes et contraste à confirmer. | 2026-11-09 | Déjà acheté — Amazon historique | Réutiliser le matériel existant
ENCODER | 1 | Rotary encoder with push button | Adafruit ADA377 / PEC11-4215F-S24 / GoTronic 38383 | OPEN exact mechanical reference | Front panel then A/J3 | Panel shaft size and A-B-SW-GND wiring | GoTronicADA377 ; souder le cordon universelU04 en atelier | https://www.gotronic.fr/art-encodeur-24-impulsions-ada377-37481.htm |  | Fiche GoTronic consultée le 09/11/2026 | Utilisateur accepte quelques soudures, aucun sertissage. Couper les4femelles duU04 côté encodeur, dénuder et souder A/B/SW/GND ; pont communC-SW2, soudures isolées. RéférenceGoTronic38383 5,90EURTTC observée09/11. Main-d’œuvre à chiffrer, pas gratuite par hypothèse. | 2026-11-09 | GoTronic | Candidat identifié ; montage et faisceau à confirmer | PrésertiU04 puis5soudures de terminaux encodeur, dont commun ponté ; aucune pince
TMP117 | 1 | Optional I2C module addr0x48 | Adafruit ADA4821 / GoTronic 37274 | Existing or purchase to confirm | A/J4 harness | Exact module pinout dimensions and pullups | Option séparée : moduleADA4821 si souhaité ; cordonGoTronicQW-4C +U04 | https://www.gotronic.fr/art-capteur-de-t-haute-precision-tmp117-ada4821-33489.htm |  | Fiche GoTronic consultée le 09/11/2026 | Pas de câbleXH-SH spécial ni de transition de calibres à commander. U04 300mm femelles individuelles +QW-4C49152 150mm mâles/SH fini à2,10EURTTC ; jonction à immobiliser et ordreGND/VIN/SDA/SCL à contrôler. Environ450mm cumulés, comportementI2C/mou à vérifier. Option10U04 supplémentaires, pas incluse dans panier de base. | 2026-11-09 | GoTronic | Optionnel ; référence identifiée, raccordement à terminer
BH1750 | 1 | Optional I2C module addr0x23 | AZ-Delivery GY-302 / B07TKWNGZ4 | Existing or purchase to confirm | A/J5 harness | Exact module pinout dimensions and pullups | Amazon : GY-302 avec barrette déjà soudée si possible | https://www.amazon.fr/dp/B07TKWNGZ4 | https://www.amazon.fr/dp/B07TKWNGZ4 | ASIN identifié par documentation AZ-Delivery ; offre Amazon non relue | GY-302 retenu comme famille, 3,3V, ADDR bas pour0x23. Mesurer le module réel contre cassette23x16mm et vérifier barrette soudée. GoTronic ADA4681 fait25,3x17,7x4,5mm : autre carte, non substituée sans révision mécanique. Ne pas commander ADA4681 comme remplacement direct. | 2026-11-09 | Amazon.fr | Candidat GY-302 ; offre et cotes à confirmer
NTC | 1 | Passive NTC15k B approximately3920 probe with robust jacketed two-core cable |  | OPEN exact reference | B/J4 via rear socket | Exact R/T curve; jacket temperature rating; strain relief and plug cable-clamp diameter; factory-fitted plug preferred | Référence à confirmer avant achat |  | https://www.amazon.fr/s?k=sonde%20NTC%2015K%20temperature%20etanche | Recherche Amazon uniquement ; aucune sonde 15k/B3920 exacte qualifiée | Sonde passive R25=15kOhm, courbe R/T documentée (cible B~3920). Exiger un câble souple à deux conducteurs multibrins sous gaine extérieure commune continue, robuste aux manipulations, avec maintien anti-arrachement côté sonde et ficheTRS. Gaine et raccord sonde adaptés à la température réelle (plage à définir) ; diamètre extérieur compatible avec le serre-câble de la fiche. Préférer ensemble sonde+câble+fiche monté en usine, sans sertissage utilisateur. Pas deux fils isolés seuls comme cordon extérieur. Ne pas substituer10k/100k/DS18B20. Référence exacte et longueur encore ouvertes. | 2026-11-09 | Amazon.fr / GoTronic — à trouver | À TROUVER — sonde15k/courbe exacte | À trouver : sonde/câble2conducteurs gainé robuste/ficheTRS montés ; courbe15k à qualifier
AB_POWER_HARNESS | 1 | Straight 2-contact power harness | XHP-2 + SXH-001T-P0.6, 300mm, AWG22 | Quote precrimped cable | Connect B/J1 to A/J1 unpowered | See harness_pin_map.csv; verify finished-harness continuity and assembled routing | Faire chiffrer10H01 standards, sans gaine spéciale | https://lcsccable.com/customize | https://www.amazon.fr/s?k=JST%20XH%202%20broches%20300mm%2022AWG | Recherche seulement ; aucune référence du panier retenue | Contrat conservé : XHP2femelle-femelle,300±10mm,AWG22,droit1->1/2->2. Fils individuellement isolés, finition standard, numéros de cavités. Sur-mesure seulement faute de référenceAmazon/GoTronic exacte ; aucun kit15cm substitué. | 2026-11-09 | LCSC Cable — sur mesure limité | Devis réduitH01 ; aucun article catalogue exact qualifié | Livré serti/monté par câbleur ; aucun sertissage utilisateur
AB_I2C_HARNESS | 1 | Straight 3-contact signal harness | XHP-3 + SXH-001T-P0.6, 300mm, AWG26 | Quote precrimped cable | Connect B/J6 to A/J6 unpowered | See harness_pin_map.csv; B/J7 pins5/6 remain NC | Faire chiffrer10H02 standards, sans gaine spéciale | https://lcsccable.com/customize | https://www.amazon.fr/s?k=JST%20XH%203%20broches%20300mm%2026AWG%20femelle%20femelle | Anciennes pistes hors panier retirées ; recherche Amazon seulement | DeuxXHP3femelles,300±10mm,AWG26,droit1->1 à3->3. Pas de raccourcissement15cm ou remplacement parAWG22 sans revue. Repérage de cavités et fils isolés standards. | 2026-11-09 | LCSC Cable — sur mesure limité | Devis réduitH02 ; aucun article catalogue exact qualifié | Livré serti/monté par câbleur ; aucune pince
AB_CTRL_HARNESS | 1 | Straight 6-contact control harness | XHP-6 + SXH-001T-P0.6, 300mm, AWG26 | Quote precrimped cable | Connect B/J7 to A/J7 unpowered | See harness_pin_map.csv; B/J7 pins5/6 remain NC | Faire chiffrer10H03 standards, six conducteurs | https://lcsccable.com/customize | https://www.amazon.fr/s?k=JST%20XH%206%20broches%20300mm%2026AWG%20femelle%20femelle | Anciennes pistes hors panier retirées ; recherche Amazon seulement | DeuxXHP6femelles,300±10mm,AWG26,droit1->1 à6->6. Lespositions5/6 sont câblées maisNC surB température. Pas de gaine spéciale imposée, pas deSH6 ou kit15cm substitué. | 2026-11-09 | LCSC Cable — sur mesure limité | Devis réduitH03 ; aucun article catalogue exact qualifié | Livré serti/monté par câbleur ; aucune pince
NTC_INTERNAL_HARNESS | 1 | Rear probe socket to B/J4 | JST1164 / GoTronic49197, XH2 female to stripped wires 150mm | Quote precrimped cable | Wire rear panel to B | 15cm service slack, gauge, protective sleeve and retention; jack solder-joint insulation | GoTronicJST1164 +tresseGAIT06 ; deux soudures au jack | https://www.gotronic.fr/art-cordon-jst-xh-femelle-2-cts-15-cm-jst1164-33095.htm |  | Fiche GoTronic consultée ; 15cm et XH2 au pas2,5mm documentés | Cordon49197 préserti15cm à2,10EURTTC ; vérifier longueur réelle et mou de dépose avant achat du lot, section non publiée. Protection interneGAIT06/48620 polyester3..9mm à0,80EUR/m (2m pour10cordons15cm +marge), pas une isolation supplémentaire ni une gaine de sonde extérieure. Isoler séparément les2soudures, retenir la tresse. J4.1->tip ; J4.2->sleeveNTC_RAW, pasGND ; ringNC. Si15cm insuffisant, reconsulter pour30cm avant achat. | 2026-11-09 | GoTronic | Partiel — cordon préserti identifié, longueur à vérifier | Préserti catalogue ;2soudures au jack ; aucune pince ;15cm conditionnels
PERIPHERAL_HARNESSES | 4 | LCD encoder TMP117 BH1750 cables | U04 universal XHP4 to4female1-way sockets; optionalGoTronicQW-4C | Quote according to populated options | Wire to A/J2-J5 | Module-end connectors and actual pinouts differ | U04 communLCD/BH1750/encodeur ; QW-4C catalogue pourTMP optionnel | https://lcsccable.com/customize | https://www.amazon.fr/s?k=JST%20XH%204%20broches%20cable%20pre%20serti%20Dupont%20femelle | QW-4C documenté ; aucun XH4-Dupont complet retenu chez Amazon/GoTronic | Pour10appareils :30U04 en base (10LCD,10BH1750,10encodeur), ou40U04 au total siTMP117 monté. U04 :XHP4->4femelles2,54mm individuelles,AWG26,300±10mm,numéros1..4 aux2bouts, aucune fonctionGND/VCC universelle. Encodeur : couper lesfemelles et souder en atelier, pin4GND et paspin1 ; LCD/BH/TMP :pin1GND,2=3V3,3=SDA,4=SCL. TMP ajouteQW-4C49152fini, pas de sur-mesureSH. Pas de cordonXH4catalogue exact qualifié chezAmazon/GoTronic ; pas de faux achat prêt à brancher. | 2026-11-09 | LCSC Cable U04 commun + GoTronic | Une référence universelle à chiffrer ;30base +10TMP optionnels | U04 déjà serti ;LCD/BH enfichables, encodeur à souder ;TMP optionnel avecQW-4C
PROBE_BULKHEAD | 1 | Removable rear two-contact probe socket | PJ-392 / DAOKI B08XM6DR96; dimensioned alternative Tayda A-2585 | OPEN exact reference | Fit removable rear panel | Fit coupon with actual DAOKI nut/washer; plug cable clamp and jacket diameter; exact Amazon variant unqualified | Lot embase jack 3,5 mm + fiche TRS ; essayer le coupon avant panneau final | https://www.amazon.fr/dp/B08XM6DR96 | https://www.amazon.fr/dp/B08XM6DR96 | Plan Tayda PJ-392 consulté ; équivalence dimensionnelle DAOKI et offre Amazon.fr non vérifiées | v0.10 : trou6,3mm, poche14mm, paroi locale1,5mm. DessinTaydaPJ392 : M6x0,5/filetage4,5mm, corps11,8mm, total22,8mm avec pattes ; réserve soudure23mm. ÉquivalenceDAOKI à essayer au coupon. Exiger une ficheTRS avec serre-câble adapté au diamètre de la gaine commune de sonde ; conserver cette gaine jusque dans la retenue, isoler séparément les soudures. Tip=J4.1, sleeve=J4.2(NTC_RAW, pasGND), ring isolé. Deux soudures internes et deux sur fiche si non préassemblée ; raccordement hors tension. | 2026-11-09 | Amazon.fr | Candidat identifié ; essai dimensionnel requis | Deux soudures embase et deux fiche ; aucun sertissage
CABLE_GLANDS | 2 | Rear glands for24V input and heater cables | HB-Digital M12 / Amazon B0CLLQCCWW | OPEN exact reference | Fit removable rear panel | Cable diameter printed holes bend radius and strain relief | 2 par système — à acheter après choix des câbles | https://www.amazon.fr/dp/B0CLLQCCWW | https://www.amazon.fr/dp/B0CLLQCCWW | ASIN identifié ; pas de plan coté HB-Digital ni offre Amazon.fr directement consultable | Deux M12 pour gaine3..6,5mm ; trous12,5mm. Joint et contre-écrou annoncés ; vérifier le lot. Corps20mm et réserves12/14mm restent des enveloppes non confirmées sur plan HB-Digital. Pas de sertissage sur un presse-étoupe. | 2026-11-09 | Amazon.fr | Candidat identifié ; gaine et dimensions à vérifier
POWER_SUPPLY | 1 | Regulated24V DC supply for temperature prototype |  | OPEN exact reference | External | Power budget heater100W plus electronics and source protection | Réutiliser une alimentation de labo ; achat différé jusqu’au choix12/24V |  | https://www.amazon.fr/s?k=alimentation%20externe%2012V%2024V%20courant%20continu | Fiche MEAN WELL et catalogue consultés ; recherche Amazon | Tension nominale d’usage encore ouverte après demande12V. B native étudiée24V/100W ; cela ne qualifie pas100W sous12V. Définir alimentation, puissance réelle et sortie avant achat du câble. Ancien GST160A24-R7B non retenu comme achat à effectuer. | 2026-11-09 | Amazon.fr / GoTronic — après choix tension | À DÉFINIR — tension et connecteur non figés
HEATER | 1 | Application-specific24V resistive heater up to100W |  | OPEN exact reference | External | Actual resistance wiring temperature rating and control requirements | À définir selon l'expérience |  | https://www.amazon.fr/s?k=element%20chauffant%20silicone%2024V%20100W | Recherche Amazon uniquement ; application et référence non définies | Modèle résistif à définir avec tension nominale réelle et application. Limite de l’étude actuelle24V/100W, environ4,17A. Ne pas interpréter comme100W permis sous12V. Forme, support, température et isolation restent ouverts. | 2026-11-09 | Amazon.fr / GoTronic — à définir | À DÉFINIR — application et puissance
POWER_WIRING | 1set | Input and heater leads and ferrules | Flexible0.75mm2 + compatible ferrules; temperature-specific cable | Quote with assembly | Rear glands to B/J2-J3 | Phoenix stripping7mm, torque0.5..0.6Nm with housing supported; choose outside cable/jacket for application | Câble catalogue gainé0,75mm2 ; dénuder/serrer côtéPhoenix sans embout obligatoire |  | https://www.amazon.fr/s?k=cable%20silicone%20cuivre%202x0.75%20mm2%20embouts%200.75mm2 | Recherche Amazon uniquement ; section réelle et isolation à vérifier | Phoenix1715721 accepte fil souple0,14..1,5mm2 directement :0,75mm2 conforme, un conducteur parpôle,7mm dénudés,0,5..0,6Nm en soutenant le bornier. Aucun sertissage requis côtéPCB si montage propre sans brin libre ; ne pas étamer. Embouts prémontés restent une option. Gaine commune adaptée3..6,5mm auxpresse-étoupes, isolation et terminaison extérieure à choisir avecchauffage/alimentation ; aucun câble exact gelé. | 2026-11-09 | Amazon.fr / GoTronic — à trouver | Catalogue visé ;référence/longueur/appareils encore ouverts | CôtéPCB :dénudage et serrage sans sertissage ;autres extrémités à qualifier
USB_EXTENSION | 1 | Side-panel USB access to DevKit USB-C |  | OPEN exact reference | Side panel and DevKit | Plug dimensions data integrity and assembled removal path | Référence mécanique à confirmer avant achat |  | https://www.amazon.fr/s?k=rallonge%20USB%20C%20panneau%20ronde%20femelle%20male%20donnees%2030cm | Recherche Amazon uniquement ; aucun passe-paroi 16 mm qualifié | USB-C femelle panneau vers USB-C mâle DevKit, données USB 2.0 requises. Maquette : trou 16 mm, corps 15 mm, bride 22 mm et profondeur interne 28 mm. Exiger le plan réel ; beaucoup de câbles de panneau sont M20/M22 ou rectangulaires et demandent de modifier le boîtier. Un câble de recharge seul ne convient pas. | 2026-11-09 | Amazon.fr / GoTronic — à trouver | À TROUVER — passe-paroi16mm non qualifié | Câble complet à trouver sur plan ; données requises
USB_SERVICE_INTERFACE | 1 | VBUS-separated powered serial arrangement | PortaPow PPUSBBP1 | Manufacturer-documented test candidate; no purchase made | External USB-A side of data cable; side USB-C retained | Test each actual DevKit at5V external; CH340/CP210x power and enumeration; not galvanic isolation | Option de banc — compatibilité à tester | https://portablepowersupplies.co.uk/product/usb-power-blocker | https://www.amazon.fr/s?k=PortaPow%20PPUSBBP1%20USB%20power%20blocker | Fonction fabricant documentée ; recherche Amazon.fr uniquement | PPUSBBP1 coupe+5V en gardant données/GND ; pas un data blocker. Ancien lienAmazon.de hors panier courant remplacé par recherche.fr, sans offre qualifiée. Option non nécessaire au premier diagnosticWi-Fi. Essayer chaqueDevKit avant USB+alimentation externe ; pas d’isolation galvanique. | 2026-11-09 | Amazon.fr — option à trouver | Option de banc ; offre .fr et compatibilité non qualifiées
INDEPENDENT_THERMAL_CUTOFF | 1 | Application-specific independent heater cutoff |  | OPEN protection design | External heater power wiring | Trip temperature current reset behavior and sensor placement | Choix nécessaire avant essai de chauffage |  | https://www.amazon.fr/s | Recherche Amazon uniquement ; aucune protection sélectionnée | Définir température de déclenchement, position, réarmement et pouvoir de coupure explicite au courant continu 24 V / au moins 4,17 A. Une valeur 250 VAC imprimée ne prouve pas cette capacité DC. À coordonner avec l'application et le câblage ; aucun seuil arbitraire choisi. | 2026-11-09 | Amazon.fr / GoTronic — à définir | À DÉFINIR — seuil, pouvoir DC et raccordement | Cordon équipé à définir avec la protection
PRINTED_ENCLOSURE | 6pieces | Shell front B-carrier rear translucent optical insert BH1750 cassette | Mechanical v0.10: PJ-392 recessed jack and optional fit coupon | STEP and STL available | Clip assembly | Print coupon; actual module stack/cables/thermal fit remain integration checks | À imprimer après essai du coupon et contrôle des modules |  | https://www.amazon.fr/s?k=PETG%20naturel%20translucide%20filament%201.75mm | Recherche de matériau uniquement ; comportement thermique et optique à vérifier | Six pièces de boîtier v0.10 plus coupon de jack optionnel séparé. Imprimer d’abord le coupon et vérifier le lot DAOKI contre le dessin Tayda ; insert translucide et cassette opaque inchangés. | 2026-11-09 | Impression locale / Amazon.fr pour filament | Imprimer après contrôles de montage
XL4015 | 0 | Previously bought external buck | B0C6R3FMT3 | Not used in Bv0.5 | None | Do not add to current assembly | Déjà acheté — ne pas racheter pour ce prototype | https://www.amazon.fr/dp/B0C6R3FMT3 | https://www.amazon.fr/dp/B0C6R3FMT3 | Lien historique fourni par l'utilisateur ; hors montage actuel | Quantité actuelle zéro : B comporte son propre LM2596. Lien conservé pour identifier le module acheté, pas pour l'ajouter au panier. | 2026-11-09 | Déjà acheté — Amazon historique | Hors montage — quantité zéro
