gcharvin/esp32_temperature_controller_platformio/hardware/pcb_a_display/pcb_a_display_bom_draft.csv

Reference | Value | Footprint | Design_Status | MPN | Manufacturer
C1 | 1uF | Capacitor_SMD:C_0603_1608Metric | ENGINEERING_SELECTED_STOCK_REVISION_2026_11_10 | 0603B105K160CT | Walsin
C2 | 1uF | Capacitor_SMD:C_0603_1608Metric | ENGINEERING_SELECTED_STOCK_REVISION_2026_11_10 | 0603B105K160CT | Walsin
C3 | 10uF | Capacitor_SMD:C_0603_1608Metric | ENGINEERING_SELECTED_STOCK_REVISION_2026_11_10 | CL10A106KP8NNNC | Samsung
D1 | APT2012LZGCK | LabHardware:LED_Kingbright_APT2012_Manufacturer | ENGINEERING_SELECTED_FOR_PROTOTYPE | APT2012LZGCK | Kingbright
D2 | APT2012LZGCK | LabHardware:LED_Kingbright_APT2012_Manufacturer | ENGINEERING_SELECTED_FOR_PROTOTYPE | APT2012LZGCK | Kingbright
J1 | A-B POWER / XH-2 | Connector_JST:JST_XH_B2B-XH-A_1x02_P2.50mm_Vertical | ENGINEERING_SELECTED_FOR_PROTOTYPE | B2B-XH-A(LF)(SN) | JST
J2 | LCD20x4 + backpack / 3V3 | Connector_JST:JST_XH_B4B-XH-A_1x04_P2.50mm_Vertical | ENGINEERING_SELECTED_FOR_PROTOTYPE | B4B-XH-A(LF)(SN) | JST
J3 | Encoder / A B SW GND | Connector_JST:JST_XH_B4B-XH-A_1x04_P2.50mm_Vertical | ENGINEERING_SELECTED_FOR_PROTOTYPE | B4B-XH-A(LF)(SN) | JST
J4 | TMP117 module / addr 0x48 | Connector_JST:JST_XH_B4B-XH-A_1x04_P2.50mm_Vertical | ENGINEERING_SELECTED_FOR_PROTOTYPE | B4B-XH-A(LF)(SN) | JST
J5 | BH1750 module / addr 0x23 | Connector_JST:JST_XH_B4B-XH-A_1x04_P2.50mm_Vertical | ENGINEERING_SELECTED_FOR_PROTOTYPE | B4B-XH-A(LF)(SN) | JST
J6 | A-B I2C / XH-3 | Connector_JST:JST_XH_B3B-XH-A_1x03_P2.50mm_Vertical | ENGINEERING_SELECTED_FOR_PROTOTYPE | B3B-XH-A(LF)(SN) | JST
J7 | A-B CTRL / XH-6 | Connector_JST:JST_XH_B6B-XH-A_1x06_P2.50mm_Vertical | ENGINEERING_SELECTED_FOR_PROTOTYPE | B6B-XH-A(LF)(SN) | JST
JP1 | 5V DevKit link / remove for service | Connector_PinHeader_2.54mm:PinHeader_1x02_P2.54mm_Vertical | ENGINEERING_SELECTED_FOR_PROTOTYPE | M20-9990246 | Harwin
R1 | 10k | Resistor_SMD:R_0603_1608Metric | ENGINEERING_SELECTED_FOR_PROTOTYPE | RC0603FR-0710KL | YAGEO
R2 | 10k | Resistor_SMD:R_0603_1608Metric | ENGINEERING_SELECTED_FOR_PROTOTYPE | RC0603FR-0710KL | YAGEO
R3 | 10k | Resistor_SMD:R_0603_1608Metric | ENGINEERING_SELECTED_FOR_PROTOTYPE | RC0603FR-0710KL | YAGEO
R4 | 4.7k | Resistor_SMD:R_0603_1608Metric | ENGINEERING_SELECTED_FOR_PROTOTYPE | RC0603FR-074K7L | YAGEO
R5 | 4.7k | Resistor_SMD:R_0603_1608Metric | ENGINEERING_SELECTED_FOR_PROTOTYPE | RC0603FR-074K7L | YAGEO
R6 | 1.5k / 1% / 0.1W | Resistor_SMD:R_0603_1608Metric | ENGINEERING_SELECTED_FOR_PROTOTYPE | RC0603FR-071K5L | YAGEO
R7 | 470R / 1% / 0.1W | Resistor_SMD:R_0603_1608Metric | ENGINEERING_SELECTED_FOR_PROTOTYPE | RC0603FR-07470RL | YAGEO
U1 | ESP32 USB-C / 30P user module | LabHardware:ESP32_30P_HCTL_PM254_Rows25.40mm | NOT_A_FACTORY_PURCHASED_NATIVE_PART |  | Customer supplied
U2 | AP2112K-3.3 peripherals | Package_TO_SOT_SMD:SOT-23-5 | ENGINEERING_SELECTED_FOR_PROTOTYPE | AP2112K-3.3TRG1 | Diodes Incorporated
TP1 | GND | LabHardware:ProbePad_D1.5mm_NoPaste | COPPER_ONLY_TEST_POINT
TP2 | +5V_AB | LabHardware:ProbePad_D1.5mm_NoPaste | COPPER_ONLY_TEST_POINT
TP3 | +5V_DEVKIT | LabHardware:ProbePad_D1.5mm_NoPaste | COPPER_ONLY_TEST_POINT
TP4 | +3V3_A | LabHardware:ProbePad_D1.5mm_NoPaste | COPPER_ONLY_TEST_POINT
TP5 | I2C_SDA | LabHardware:ProbePad_D1.5mm_NoPaste | COPPER_ONLY_TEST_POINT
TP6 | I2C_SCL | LabHardware:ProbePad_D1.5mm_NoPaste | COPPER_ONLY_TEST_POINT
TP7 | PWM0 | LabHardware:ProbePad_D1.5mm_NoPaste | COPPER_ONLY_TEST_POINT
TP8 | ENABLE | LabHardware:ProbePad_D1.5mm_NoPaste | COPPER_ONLY_TEST_POINT
TP9 | FAULT_N | LabHardware:ProbePad_D1.5mm_NoPaste | COPPER_ONLY_TEST_POINT
TP10 | ENC_SW | LabHardware:ProbePad_D1.5mm_NoPaste | COPPER_ONLY_TEST_POINT
J10 | A-B UART / 3V3 / GND TX_A RX_A | Connector_JST:JST_XH_B3B-XH-A_1x03_P2.50mm_Vertical | ENGINEERING_SELECTED_FOR_PROTOTYPE | B3B-XH-A(LF)(SN) | JST
