gcharvin/esp32_temperature_controller_platformio/hardware/pcb_b_temperature/pcb_b_temperature_bom_draft.csv

Reference | Value | Footprint | Design_Status | MPN | Manufacturer
C1 | 1uF / 16V X7R | Capacitor_SMD:C_0603_1608Metric | ENGINEERING_SELECTED_STOCK_REVISION_2026_11_10 | 0603B105K160CT | Walsin
C2 | 1uF / 10V X7R | Capacitor_SMD:C_0603_1608Metric | ENGINEERING_SELECTED_STOCK_REVISION_2026_11_10 | 0603B105K160CT | Walsin
C3 | 100nF / 10V X7R | Capacitor_SMD:C_0603_1608Metric | ENGINEERING_SELECTED_FOR_PROTOTYPE | C0603C104K4RACTU | KEMET / Yageo Group
C4 | 100nF / 10V X7R | Capacitor_SMD:C_0603_1608Metric | ENGINEERING_SELECTED_FOR_PROTOTYPE | C0603C104K4RACTU | KEMET / Yageo Group
C5 | 100nF / 10V X7R | Capacitor_SMD:C_0603_1608Metric | ENGINEERING_SELECTED_FOR_PROTOTYPE | C0603C104K4RACTU | KEMET / Yageo Group
C6 | 100nF / 16V X7R | Capacitor_SMD:C_0603_1608Metric | ENGINEERING_SELECTED_FOR_PROTOTYPE | C0603C104K4RACTU | KEMET / Yageo Group
C7 | 1uF / 16V X7R | Capacitor_SMD:C_0603_1608Metric | ENGINEERING_SELECTED_STOCK_REVISION_2026_11_10 | 0603B105K160CT | Walsin
C8 | 100uF / 50V / EEUFR1H101 | Capacitor_THT:CP_Radial_D8.0mm_P3.50mm | ENGINEERING_SELECTED_FOR_PROTOTYPE | EEUFR1H101 | Panasonic
C9 | 100nF / 50V X7R | Capacitor_SMD:C_0805_2012Metric | ENGINEERING_SELECTED_FOR_PROTOTYPE | C0805C104K5RACTU | KEMET / Yageo Group
C10 | 330uF / 35V | LabHardware:CP_Radial_EEUFS1V331LB_P5_D10_Keepout | ENGINEERING_SELECTED_STOCK_REVISION_2026_11_10 | EEUFS1V331LB | Panasonic
D2 | SMBJ24CA / transients NOT qualified | Diode_SMD:D_SMB | ENGINEERING_SELECTED_FOR_PROTOTYPE | SMBJ24CA | Littelfuse
D3 | BZT52C12 / 12V gate clamp | Diode_SMD:D_SOD-123 | ENGINEERING_SELECTED_FOR_PROTOTYPE | BZT52C12-7-F | Diodes Incorporated
D4 | STPS5L60U / cable flyback | Diode_SMD:D_SMB | ENGINEERING_SELECTED_FOR_PROTOTYPE | STPS5L60U | STMicroelectronics
D5 | APT2012LZGCK | LabHardware:LED_Kingbright_APT2012_Manufacturer | ENGINEERING_SELECTED_FOR_PROTOTYPE | APT2012LZGCK | Kingbright
D6 | APT2012LZGCK | LabHardware:LED_Kingbright_APT2012_Manufacturer | ENGINEERING_SELECTED_FOR_PROTOTYPE | APT2012LZGCK | Kingbright
D7 | APT2012LZGCK | LabHardware:LED_Kingbright_APT2012_Manufacturer | ENGINEERING_SELECTED_FOR_PROTOTYPE | APT2012LZGCK | Kingbright
D8 | APT2012LSYCK/J3-PRV | LabHardware:LED_Kingbright_APT2012_Manufacturer | ENGINEERING_SELECTED_STOCK_REVISION_2026_11_10 | APT2012LSYCK/J3-PRV | Kingbright
D9 | SS36 / 60V 3A | Diode_SMD:D_SMC | ENGINEERING_SELECTED_FOR_PROTOTYPE | SS36-E3/57T | Vishay
F1 | 6.3A / 125VDC / 045106.3MRL | Fuse:Fuse_Littelfuse-NANO2-451_453 | ENGINEERING_SELECTED_FOR_PROTOTYPE | 045106.3MRL | Littelfuse
F2 | 1A / 125VDC / 0451001.MRL | Fuse:Fuse_Littelfuse-NANO2-451_453 | ENGINEERING_SELECTED_FOR_PROTOTYPE | 0451001.MRL | Littelfuse
J1 | A-B POWER / XH-2 | Connector_JST:JST_XH_B2B-XH-A_1x02_P2.50mm_Vertical | ENGINEERING_SELECTED_FOR_PROTOTYPE | B2B-XH-A(LF)(SN) | JST
J2 | 24V IN / + PGND | TerminalBlock_Phoenix:TerminalBlock_Phoenix_MKDS-1,5-2-5.08_1x02_P5.08mm_Horizontal | ENGINEERING_SELECTED_FOR_PROTOTYPE | 1715721 | Phoenix Contact
J3 | HEATER / + switched return | TerminalBlock_Phoenix:TerminalBlock_Phoenix_MKDS-1,5-2-5.08_1x02_P5.08mm_Horizontal | ENGINEERING_SELECTED_FOR_PROTOTYPE | 1715721 | Phoenix Contact
J4 | TEMP / NTC 15k B3920 | Connector_JST:JST_XH_B2B-XH-A_1x02_P2.50mm_Vertical | ENGINEERING_SELECTED_FOR_PROTOTYPE | B2B-XH-A(LF)(SN) | JST
J6 | A-B I2C / XH-3 | Connector_JST:JST_XH_B3B-XH-A_1x03_P2.50mm_Vertical | ENGINEERING_SELECTED_FOR_PROTOTYPE | B3B-XH-A(LF)(SN) | JST
J7 | A-B CTRL / XH-6 | Connector_JST:JST_XH_B6B-XH-A_1x06_P2.50mm_Vertical | ENGINEERING_SELECTED_FOR_PROTOTYPE | B6B-XH-A(LF)(SN) | JST
L1 | 100uH / SRP1770TA-101M | Inductor_SMD:L_Bourns_SRP1770TA_16.9x16.9mm | ENGINEERING_SELECTED_FOR_PROTOTYPE | SRP1770TA-101M | Bourns
NT1 | GND STAR / NO COMPONENT | NetTie:NetTie-2_SMD_Pad2.0mm | NOT_A_FACTORY_PURCHASED_NATIVE_PART
Q1 | IRLZ44NPBF / gate 5 V | Package_TO_SOT_THT:TO-220-3_Vertical | ENGINEERING_SELECTED_FOR_PROTOTYPE | IRLZ44NPBF | Infineon
Q2 | DMP6023LE-13 / reverse input | Package_TO_SOT_SMD:SOT-223-3_TabPin2 | ENGINEERING_SELECTED_FOR_PROTOTYPE | DMP6023LE-13 | Diodes Incorporated
R1 | 47k | Resistor_SMD:R_0603_1608Metric | ENGINEERING_SELECTED_FOR_PROTOTYPE | RC0603FR-0747KL | YAGEO
R2 | 47k | Resistor_SMD:R_0603_1608Metric | ENGINEERING_SELECTED_FOR_PROTOTYPE | RC0603FR-0747KL | YAGEO
R3 | 22R | Resistor_SMD:R_0603_1608Metric | ENGINEERING_SELECTED_FOR_PROTOTYPE | RC0603FR-0722RL | YAGEO
R4 | 100k | Resistor_SMD:R_0603_1608Metric | ENGINEERING_SELECTED_FOR_PROTOTYPE | RC0603FR-07100KL | YAGEO
R5 | 8.45k 1% | Resistor_SMD:R_0603_1608Metric | ENGINEERING_SELECTED_FOR_PROTOTYPE | RC0603FR-078K45L | YAGEO
R6 | 1k | Resistor_SMD:R_0603_1608Metric | ENGINEERING_SELECTED_FOR_PROTOTYPE | RC0603FR-071KL | YAGEO
R7 | 10k | Resistor_SMD:R_0603_1608Metric | ENGINEERING_SELECTED_FOR_PROTOTYPE | RC0603FR-0710KL | YAGEO
R8 | 100k | Resistor_SMD:R_0603_1608Metric | ENGINEERING_SELECTED_FOR_PROTOTYPE | RC0603FR-07100KL | YAGEO
R9 | 15k / 1% / 0.125W | Resistor_SMD:R_0805_2012Metric | ENGINEERING_SELECTED_FOR_PROTOTYPE | RC0805FR-0715KL | YAGEO
R10 | 1.5k / 1% / 0.1W | Resistor_SMD:R_0603_1608Metric | ENGINEERING_SELECTED_FOR_PROTOTYPE | RC0603FR-071K5L | YAGEO
R11 | 470R / 1% / 0.1W | Resistor_SMD:R_0603_1608Metric | ENGINEERING_SELECTED_FOR_PROTOTYPE | RC0603FR-07470RL | YAGEO
R12 | 2.2k / 1% / 0.1W | Resistor_SMD:R_0603_1608Metric | ENGINEERING_SELECTED_FOR_PROTOTYPE | RC0603FR-072K2L | YAGEO
R13 | 50m / 1% / 0.25W | LabHardware:Vishay_WSL1206_6m_to_200m | ENGINEERING_SELECTED_STOCK_REVISION_2026_11_10 | WSL1206R0500FEA | Vishay
U1 | LM2596S-5.0/NOPB | Package_TO_SOT_SMD:TO-263-5_TabPin3 | ENGINEERING_SELECTED_FOR_PROTOTYPE | LM2596S-5.0/NOPB | Texas Instruments
U2 | AP2112K-3.3 | Package_TO_SOT_SMD:SOT-23-5 | ENGINEERING_SELECTED_FOR_PROTOTYPE | AP2112K-3.3TRG1 | Diodes Incorporated
U3 | SN74LVC1G08DBVR | Package_TO_SOT_SMD:SOT-23-5 | ENGINEERING_SELECTED_FOR_PROTOTYPE | SN74LVC1G08DBVR | Texas Instruments
U4 | ADS1115IDGSR / 0x49 | Package_SO:TSSOP-10_3x3mm_P0.5mm | ENGINEERING_SELECTED_FOR_PROTOTYPE | ADS1115IDGSR | Texas Instruments
U5 | UCC27517DBVR | Package_TO_SOT_SMD:SOT-23-5 | ENGINEERING_SELECTED_FOR_PROTOTYPE | UCC27517DBVR | Texas Instruments
TP1 | PGND | LabHardware:ProbePad_D1.5mm_NoPaste | COPPER_ONLY_TEST_POINT
TP2 | VIN_PROTECTED | LabHardware:ProbePad_D1.5mm_NoPaste | COPPER_ONLY_TEST_POINT
TP3 | +5V_BUCK | LabHardware:ProbePad_D1.5mm_NoPaste | COPPER_ONLY_TEST_POINT
TP4 | +5V_AB | LabHardware:ProbePad_D1.5mm_NoPaste | COPPER_ONLY_TEST_POINT
TP5 | +3V3_B | LabHardware:ProbePad_D1.5mm_NoPaste | COPPER_ONLY_TEST_POINT
TP6 | NTC_RAW | LabHardware:ProbePad_D1.5mm_NoPaste | COPPER_ONLY_TEST_POINT
TP7 | NTC_ADC | LabHardware:ProbePad_D1.5mm_NoPaste | COPPER_ONLY_TEST_POINT
TP8 | PWM0 | LabHardware:ProbePad_D1.5mm_NoPaste | COPPER_ONLY_TEST_POINT
TP9 | ENABLE | LabHardware:ProbePad_D1.5mm_NoPaste | COPPER_ONLY_TEST_POINT
TP10 | FAULT_N | LabHardware:ProbePad_D1.5mm_NoPaste | COPPER_ONLY_TEST_POINT
TP11 | GATE_DRV | LabHardware:ProbePad_D1.5mm_NoPaste | COPPER_ONLY_TEST_POINT
TP12 | GND | LabHardware:ProbePad_D1.5mm_NoPaste | COPPER_ONLY_TEST_POINT
J10 | A-B UART / 3V3 / GND TX_A RX_A | Connector_JST:JST_XH_B3B-XH-A_1x03_P2.50mm_Vertical | ENGINEERING_SELECTED_FOR_PROTOTYPE | B3B-XH-A(LF)(SN) | JST
