gcharvin/esp32_temperature_controller_platformio/hardware/manufacturing/jlcpcb/support/exact_sourcing_REQUIRED.csv

Manufacturer | MPN | References | Net_quantity_for_lot | Assembly | Status
Harwin | M7566-05 | A/JP1_SHUNT | 5 | SUPPLY_LOOSE_NOT_ON_CPL | EXACT_SOURCING_REQUIRED
