gcharvin/esp32_temperature_controller_platformio/hardware/manufacturing/lcsc_cable_rfq/connector_requirements.csv

Connector_ID | Housing_or_completed_end | Contact_or_termination | Pitch_mm | Cavities_or_functions | Internal_8_lines_end_sets | Housing_units_internal_8_lines | Crimp_contacts_internal_8_lines | Wire_range_AWG | Insulation_OD_mm | Manufacturer_source | Notes
XH2 | JST XHP-2 | JST SXH-001T-P0.6 | 2.5 | 2 | 30 | 30 | 60 | 22-28 | 0.9..1.9 | https://www.jst-mfg.com/product/pdf/eng/eXH.pdf | Exact manufacturer combination; no substitutions by appearance
XH3 | JST XHP-3 | JST SXH-001T-P0.6 | 2.5 | 3 | 20 | 20 | 60 | 22-28 | 0.9..1.9 | https://www.jst-mfg.com/product/pdf/eng/eXH.pdf | Exact manufacturer combination; no substitutions by appearance
XH4 | JST XHP-4 | JST SXH-001T-P0.6 | 2.5 | 4 | 40 | 40 | 160 | 22-28 | 0.9..1.9 | https://www.jst-mfg.com/product/pdf/eng/eXH.pdf | Exact manufacturer combination; no substitutions by appearance
XH6 | JST XHP-6 | JST SXH-001T-P0.6 | 2.5 | 6 | 20 | 20 | 120 | 22-28 | 0.9..1.9 | https://www.jst-mfg.com/product/pdf/eng/eXH.pdf | Exact manufacturer combination; no substitutions by appearance
FLY4 | 4 individual Harwin M20-1060100 female1-position housings | 4 Harwin M20-1160042 female crimp contacts | 2.54 | 4 | 20 | 80 | 80 | 22-30 | Per selected contact drawing | https://www.harwin.com/products/M20-1060100 | Four independent1-way housings, side-stackable on0.64mm square male posts. Supplier to confirm contact insulation OD/tooling. Label functions rather than assume LCD/GY302 physical order. Proposed documented replacement for generic Dupont, module engagement/clearance still needs real sample check.
SH4 | JST SHR-04V-S-B | JST SSH-003T-P0.2-H | 1 | 4 | 10 | 10 | 40 | 28-32 | 0.4..0.8 | https://www.jst-mfg.com/product/pdf/eng/eSH.pdf | STEMMA QT compatible receptacle, not JST-PH or XH. 28AWG tails only, factory transition to26AWG main wires.
ENC5 | Factory-soldered Adafruit377 encoder subassembly / PEC11-4215F-S24 candidate | Encoder contacts A/B/C and two normally-open push-switch contacts SW1/SW2; exact solder view to be confirmed |  | 5 | 10 | 10 | 0 | Supplier proposes | Per selected contact drawing | https://www.gotronic.fr/art-encodeur-24-impulsions-ada377-37481.htm | Quote procurement+factory soldering as separate cost; alternative customer-consigned encoder price. A free solder-tail harness is not the requested completed assembly. Encoder exact switch variant and terminal view require approval drawing.
JACK_F | PJ-3923.5mmTRS panel female socket, TaydaA-2585 dimensional reference | Factory solder to verified tip and sleeve terminals; ring and any switch terminals isolated |  | 3 | 10 | 10 | 0 | Supplier proposes | Per selected contact drawing | https://www.taydaelectronics.com/datasheets/files/PJ-392.pdf | Supplier must propose exact manufacturer/MPN/drawing. DAOKIB08XM6DR96 equivalence unqualified. M6x0.5 thread4.5mm, body11.8mm, total22.8mm drawing reference; panel6.3mm hole and local1.5mm web. Include nut/washer, confirm stack. Identify lugs by continuity using knownTRS plug; do not infer lug numbers. Max existing solder corridor23mm depth,10mm diameter to be respected.
JACK_M | Supplier-proposed3.5mmTRS male cable plug with insulated body and real cable clamp | Tip and sleeve only, ring isolated |  | 3 | 0 | 0 | 0 | Supplier proposes | Per selected contact drawing | https://www.taydaelectronics.com/datasheets/files/PJ-392.pdf | Exact MPN and mating geometry, body OD and cable-jacket clamp range to propose; the PJ392 document defines mating socket, not a male-plug MPN. Plug must fit proposed robust probe jacket without cutting its outer sheath at clamp.
NTC | Passive two-wire15kohm NTC probe, R25/certifiedR-T curve target beta~3920 | Probe leads1/2 (nonpolar component) |  | 2 | 0 | 0 | 0 | Supplier proposes | Per selected contact drawing | ../system_bom_review.csv | Exact probe MPN, R25 tolerance, beta reference temperatures/tolerance, temperature range, medium, seal and cable length not approved. Quote candidate only with datasheet; do not substitute10k/100k/DS18B20.
FERRULE2 | 2 insulated ferrules sized for flexible0.75mm2 copper and Phoenix1715721 MKDS1,5/2-5,08 | Supplier proposes exact ferrule MPN/metal length and crimp tooling compatible with terminal |  | 2 | 0 | 0 | 0 | Supplier proposes | Per selected contact drawing | https://www.phoenixcontact.com/en-gb/products/printed-circuit-board-terminal-mkds-15-2-508-1715721 | 7mm stripping reference from terminal document; do not equate blindly with ferrule tube length. No solder tinning, no terminal block purchase in cable quote.
PSU_TBD | Power supply output termination TBD | Positive/return functions only |  | 2 | 0 | 0 | 0 | Supplier proposes | Per selected contact drawing | ../system_bom_review.csv | Nominal12V/24V and actual supply connector not fixed. No assumed barrel, PowerDIN or mains plug.
HEATER_TBD | Heater end termination TBD | Positive/switched return functions only |  | 2 | 0 | 0 | 0 | Supplier proposes | Per selected contact drawing | ../system_bom_review.csv | Actual heater leads, insulation temperature and thermal protection topology unresolved.
CUTOFF_TBD | Independent normally-closed thermal protection terminal type TBD | Two series-power terminals only after exact part selected |  | 2 | 0 | 0 | 0 | Supplier proposes | Per selected contact drawing | ../system_bom_review.csv | Trip setting, reset behaviour, location, terminal size and DC interruption rating unresolved. No arbitrary spade/contact size selected.
USB_F | USB-C female side-panel data extension, supplier proposes controlled MPN | USB2.0 data-capable female interface |  | 0 | 0 | 0 | 0 | Supplier proposes | Per selected contact drawing | ../../mechanical/enclosure_parameters.json | Existing reservation: hole16mm, body15mm, flange22mm, internal depth28mm; not a verified commercial part. Exact drawing, male-plug clearance and panel fixings required; M20/M22 is not accepted as drop-in.
USB_M | USB-C male data plug to actual ESP32 DevKit | USB2.0 data-capable male interface |  | 0 | 0 | 0 | 0 | Supplier proposes | Per selected contact drawing | ../../devkit_compatibility.md | Complete USB extension assembly with supplier-validated C configuration/CC wiring, D+/D-,GND,shield/VBUS continuity; not charge-only. No hand-designed universal USB-C pin map. Powered USB+external5V not qualified; service with all other sources disconnected.
