gcharvin/esp32_temperature_controller_platformio/hardware/manufacturing/review_A04_B05/loose_accessories.csv

Board | Reference | Quantity | MPN | Manufacturer | Assembly
A | JP1_SHUNT | 1 | M7566-05 | Harwin | SUPPLY_LOOSE_NOT_ON_CPL
