gcharvin/esp32_temperature_controller_platformio/hardware/mechanical/exports/enclosure_assembled.step

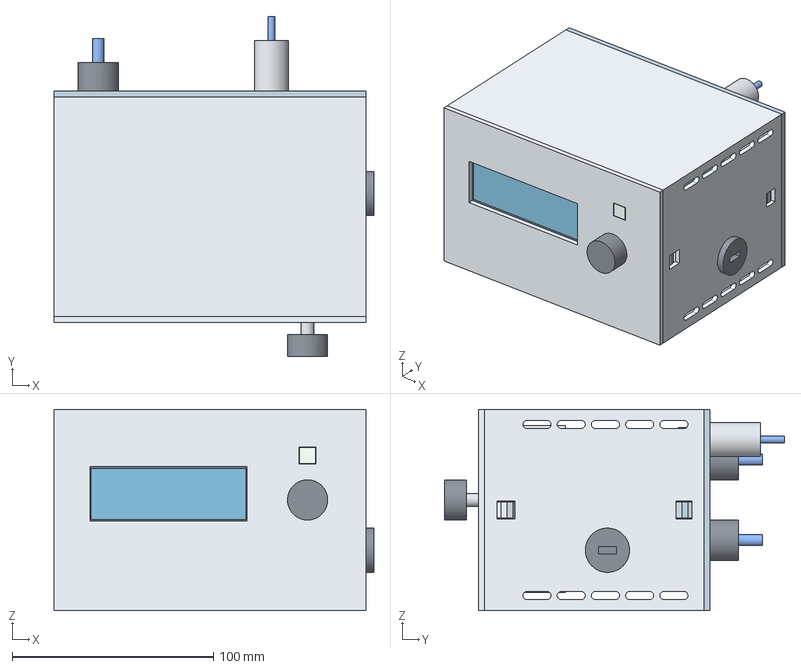
[picture p17: CAD file, 2026-11-06]
hardware/mechanical/exports/enclosure_assembled.step
159.0 x 169.0 x 100.0 mm
01_Shell_open_front_and_rear
02_Removable_front_LCD_A
03_B_removable_carrier
04_Rear_panel_with_latches
05_Translucent_optical_insert
06_BH1750_removable_carrier
PCB_A
A_C1_ENVELOPE
A_C2_ENVELOPE
A_C3_ENVELOPE
A_D1_ENVELOPE
A_D2_ENVELOPE
A_J1_ENVELOPE
A_J2_ENVELOPE
A_J3_ENVELOPE
A_J4_ENVELOPE
A_J5_ENVELOPE
A_J6_ENVELOPE
A_J7_ENVELOPE
A_JP1_ENVELOPE
A_R1_ENVELOPE
A_R2_ENVELOPE
A_R3_ENVELOPE
A_R4_ENVELOPE
A_R5_ENVELOPE
A_R6_ENVELOPE
A_R7_ENVELOPE
A_U2_ENVELOPE
A_DEVKIT_SOCKET_1
A_DEVKIT_MALE_HEADER_SPACER_1
A_DEVKIT_SOCKET_2
A_DEVKIT_MALE_HEADER_SPACER_2
A_DEVKIT_PCB_REFERENCE_54x27
A_DEVKIT_RF_SHIELD_ENVELOPE
A_DEVKIT_USB_BRIDGE_ENVELOPE
A_DEVKIT_USB_C_ENVELOPE
PCB_B
B_C1_ENVELOPE
B_C10_ENVELOPE
B_C2_ENVELOPE
B_C3_ENVELOPE
B_C4_ENVELOPE
B_C5_ENVELOPE
B_C6_ENVELOPE
B_C7_ENVELOPE
B_C8_ENVELOPE
B_C9_ENVELOPE
B_D2_ENVELOPE
B_D3_ENVELOPE
B_D4_ENVELOPE
B_D5_ENVELOPE
B_D6_ENVELOPE
B_D7_ENVELOPE
B_D8_ENVELOPE
B_D9_ENVELOPE
B_F1_ENVELOPE
B_F2_ENVELOPE
B_J1_ENVELOPE
B_J2_ENVELOPE
B_J3_ENVELOPE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
