gcharvin/esp32_temperature_controller_platformio/hardware/mechanical/exports/parts_v12/04_Rear_panel_with_latches.step

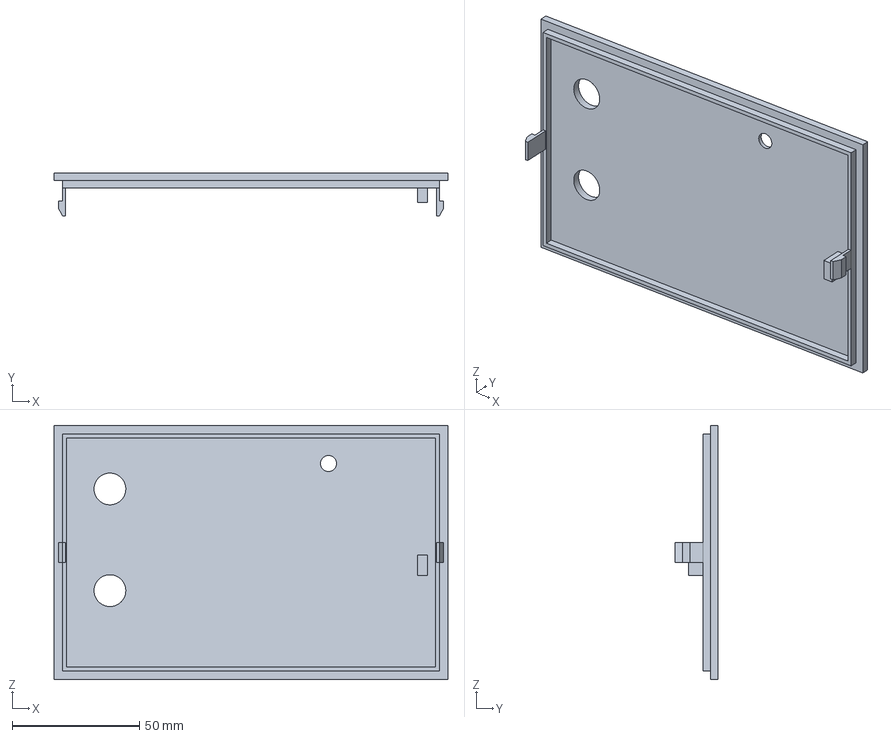
[picture p18: CAD file, 2026-11-10]
hardware/mechanical/exports/parts_v12/04_Rear_panel_with_latches.step
155.0 x 17.0 x 100.0 mm
