gcharvin/esp32_temperature_controller_platformio/hardware/mechanical/exports/enclosure_v12_printed_parts.step

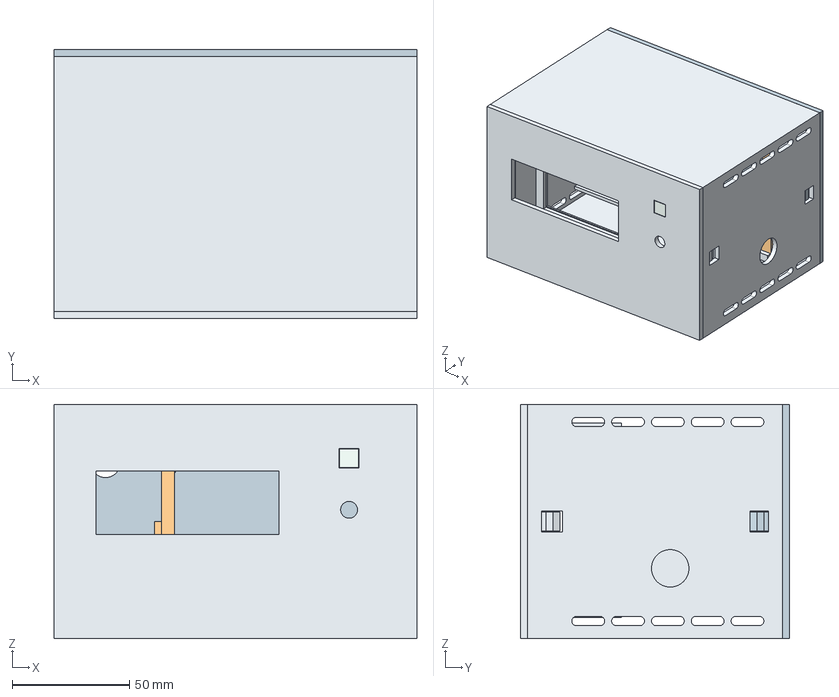
[picture p19: CAD file, 2026-11-10]
hardware/mechanical/exports/enclosure_v12_printed_parts.step
155.0 x 115.0 x 100.0 mm
01_Coque_ouverte
02_Facade_supports_LCD_A
03_Berceau_B
04_Panneau_arriere
05_Fenetre_translucide
06_Cassette_BH1750
