gcharvin/esp32_temperature_controller_platformio/hardware/mechanical/exports/parts_v12/05_Translucent_optical_insert.step

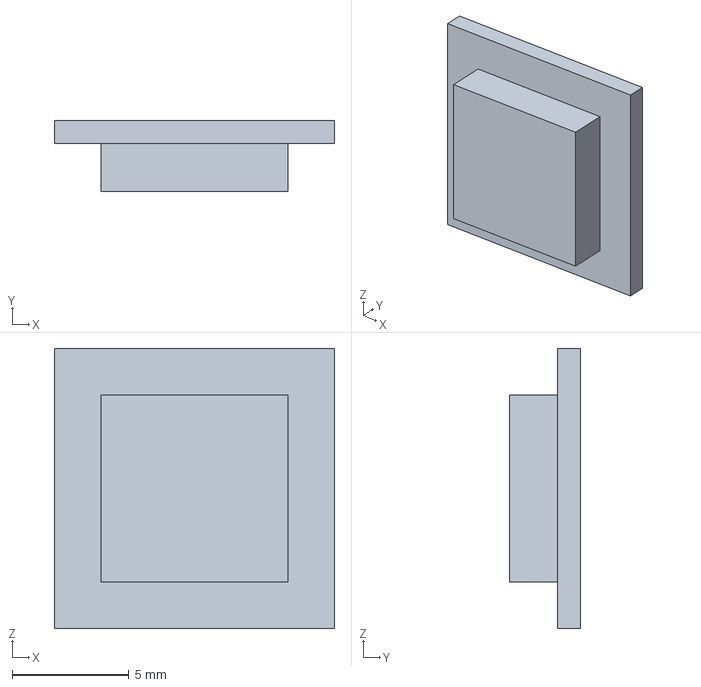
[picture p20: CAD file, 2026-11-10]
hardware/mechanical/exports/parts_v12/05_Translucent_optical_insert.step
12.0 x 3.05 x 12.0 mm
