gcharvin/esp32_temperature_controller_platformio/hardware/mechanical/exports/parts_v12/02_Removable_front_LCD_A.step

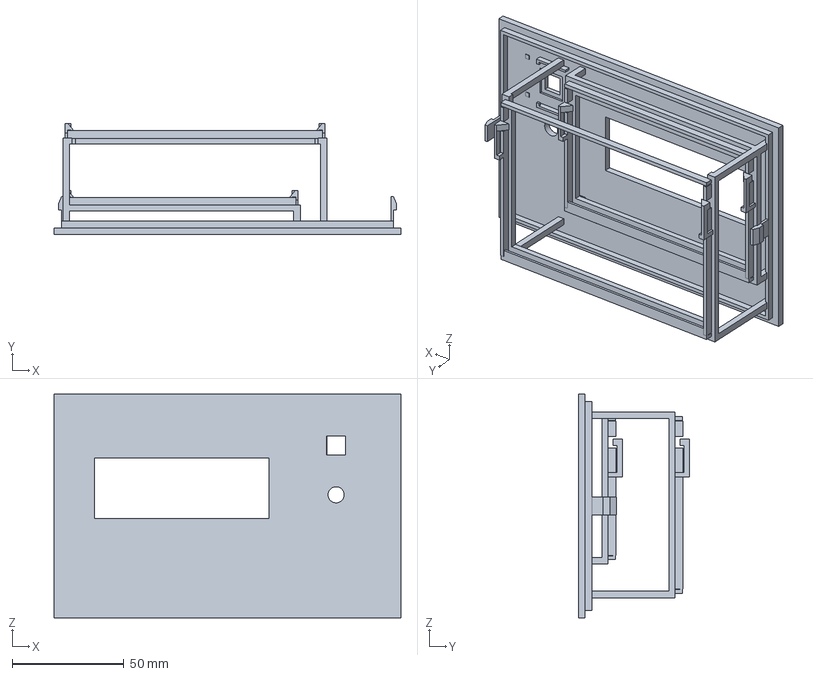
[picture p22: CAD file, 2026-11-10]
hardware/mechanical/exports/parts_v12/02_Removable_front_LCD_A.step
155.0 x 49.6 x 100.0 mm
