gcharvin/esp32_temperature_controller_platformio/hardware/mechanical/exports/enclosure_printed_parts_exploded.step

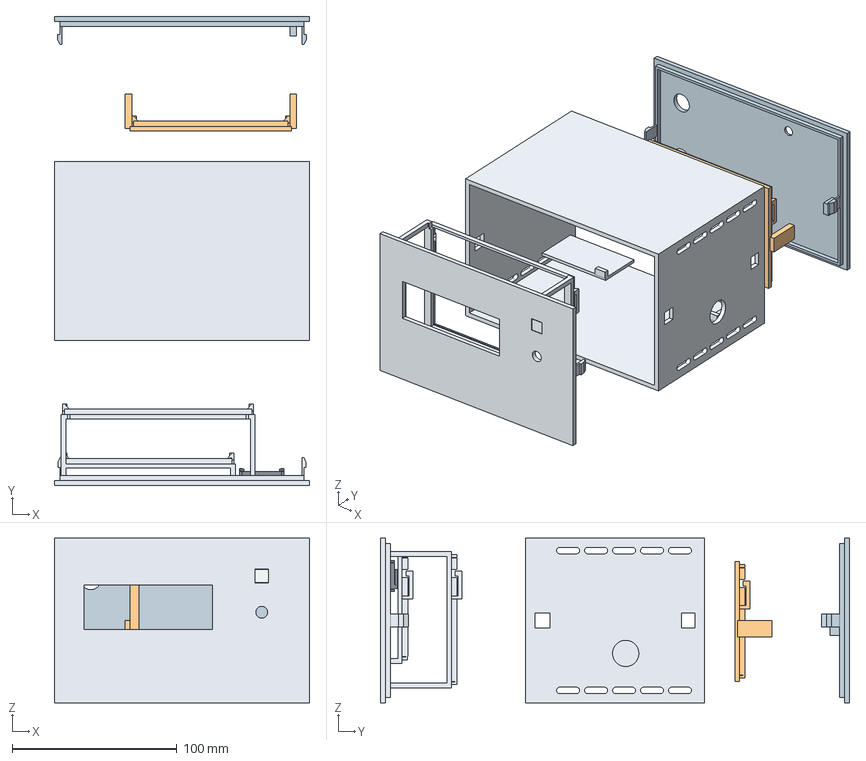
[picture p23: CAD file, 2026-11-10]
hardware/mechanical/exports/enclosure_printed_parts_exploded.step
155.0 x 285.0 x 100.0 mm
01_Coque_ouverte
02_Facade_supports_LCD_A
03_Berceau_B
04_Panneau_arriere
05_Fenetre_translucide
06_Cassette_BH1750
