gcharvin/esp32_temperature_controller_platformio/hardware/mechanical/exports/parts_v12/01_Shell_open_front_and_rear.step

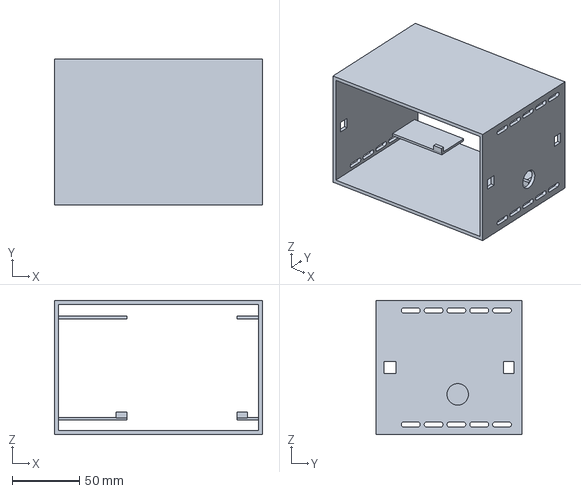
[picture p24: CAD file, 2026-11-10]
hardware/mechanical/exports/parts_v12/01_Shell_open_front_and_rear.step
155.0 x 109.0 x 100.0 mm
