gcharvin/esp32_temperature_controller_platformio/hardware/mechanical/exports/parts_v12/03_B_removable_carrier.step

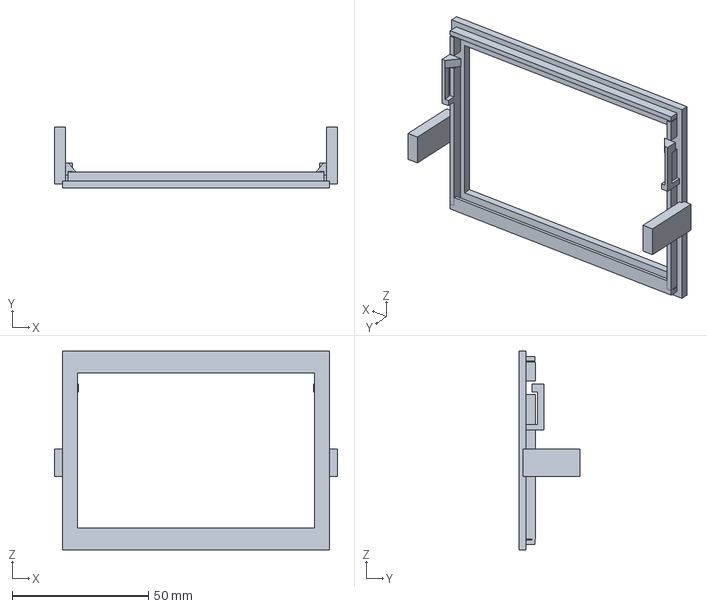
[picture p25: CAD file, 2026-11-10]
hardware/mechanical/exports/parts_v12/03_B_removable_carrier.step
104.0 x 22.6 x 73.0 mm
