gcharvin/esp32_temperature_controller_platformio/hardware/mechanical/exports/parts_v12/98_Optional_jack_fit_coupon.step

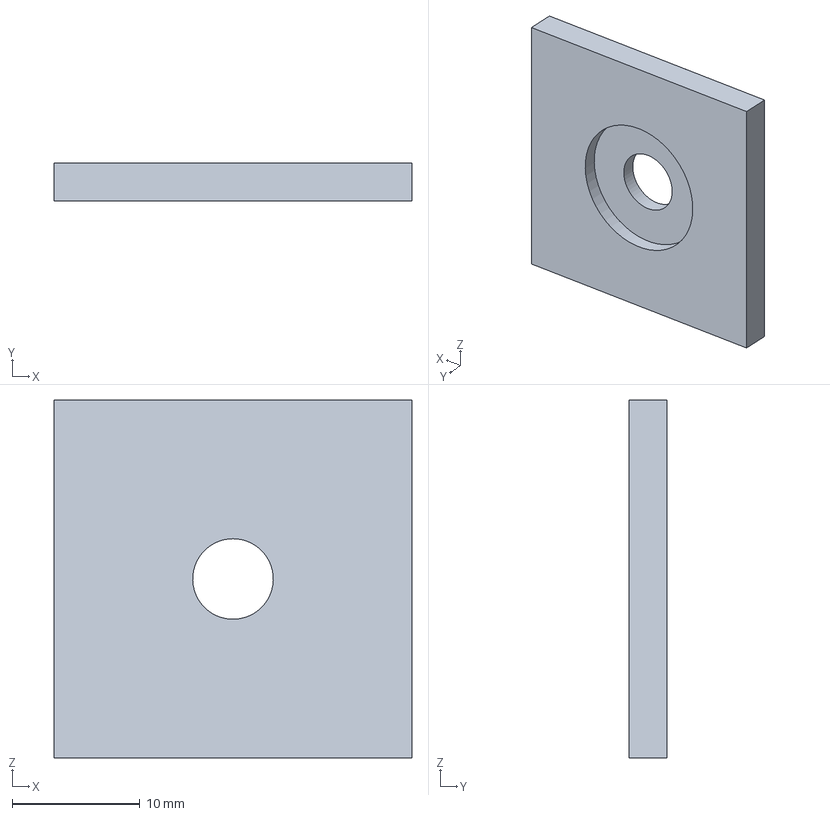
[picture p26: CAD file, 2026-11-10]
hardware/mechanical/exports/parts_v12/98_Optional_jack_fit_coupon.step
28.0 x 3.00 x 28.0 mm
