gcharvin/esp32_temperature_controller_platformio/hardware/mechanical/exports/parts_v12/06_BH1750_removable_carrier.step

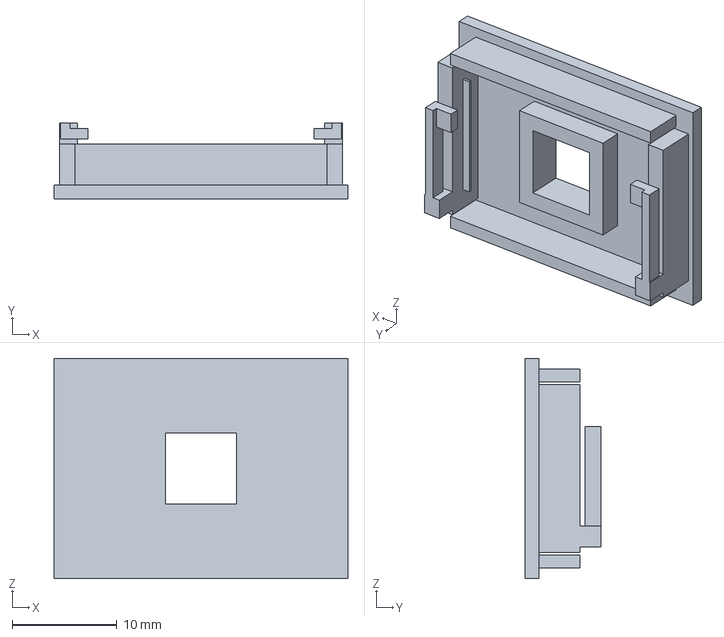
[picture p27: CAD file, 2026-11-10]
hardware/mechanical/exports/parts_v12/06_BH1750_removable_carrier.step
28.0 x 7.20 x 21.0 mm
