gcharvin/esp32_temperature_controller_platformio/hardware/mechanical/exports/enclosure_v06_side_vents.step

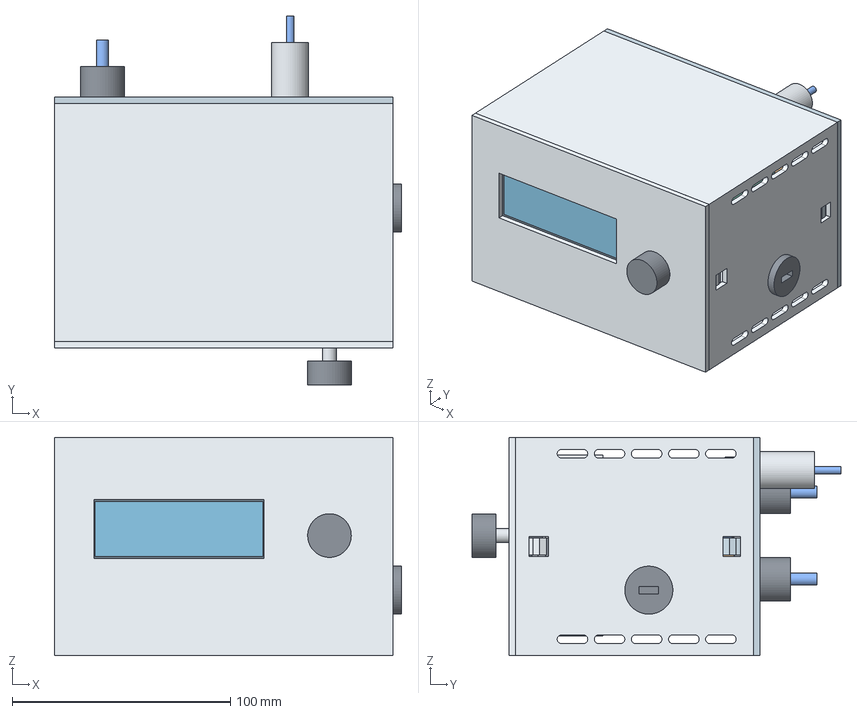
[picture p28: CAD file, 2026-11-05]
hardware/mechanical/exports/enclosure_v06_side_vents.step
159.0 x 169.0 x 100.0 mm
05_XL4015_removable_carrier
01_Shell_open_front_and_rear
02_Removable_front_LCD_A
03_B_removable_carrier
04_Rear_panel_with_latches
PCB_A
A_C1_ENVELOPE
A_C2_ENVELOPE
A_C3_ENVELOPE
A_D1_ENVELOPE
A_D2_ENVELOPE
A_J1_ENVELOPE
A_J2_ENVELOPE
A_J3_ENVELOPE
A_J4_ENVELOPE
A_J5_ENVELOPE
A_J6_ENVELOPE
A_J7_ENVELOPE
A_JP1_ENVELOPE
A_R1_ENVELOPE
A_R2_ENVELOPE
A_R3_ENVELOPE
A_R4_ENVELOPE
A_R5_ENVELOPE
A_R6_ENVELOPE
A_R7_ENVELOPE
A_U2_ENVELOPE
A_DEVKIT_SOCKET_34.03
A_DEVKIT_SOCKET_59.43
A_DIYMORE_PCB_54x27
A_DIYMORE_RF_SHIELD
A_DIYMORE_CH340
A_DIYMORE_USB_C
PCB_B
B_C1_ENVELOPE
B_C2_ENVELOPE
B_C3_ENVELOPE
B_C4_ENVELOPE
B_C5_ENVELOPE
B_C6_ENVELOPE
B_C7_ENVELOPE
B_C8_ENVELOPE
B_D2_ENVELOPE
B_D3_ENVELOPE
B_D4_ENVELOPE
B_D5_ENVELOPE
B_D6_ENVELOPE
B_D7_ENVELOPE
B_D8_ENVELOPE
B_F1_ENVELOPE
B_F2_ENVELOPE
B_J1_ENVELOPE
B_J2_ENVELOPE
B_J3_ENVELOPE
B_J4_ENVELOPE
B_J6_ENVELOPE
B_J7_ENVELOPE
B_J8_ENVELOPE
B_J9_ENVELOPE
B_Q1_ENVELOPE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
