gcharvin/esp32_temperature_controller_platformio/hardware/mechanical/exports/enclosure_v03_rails_usb.step

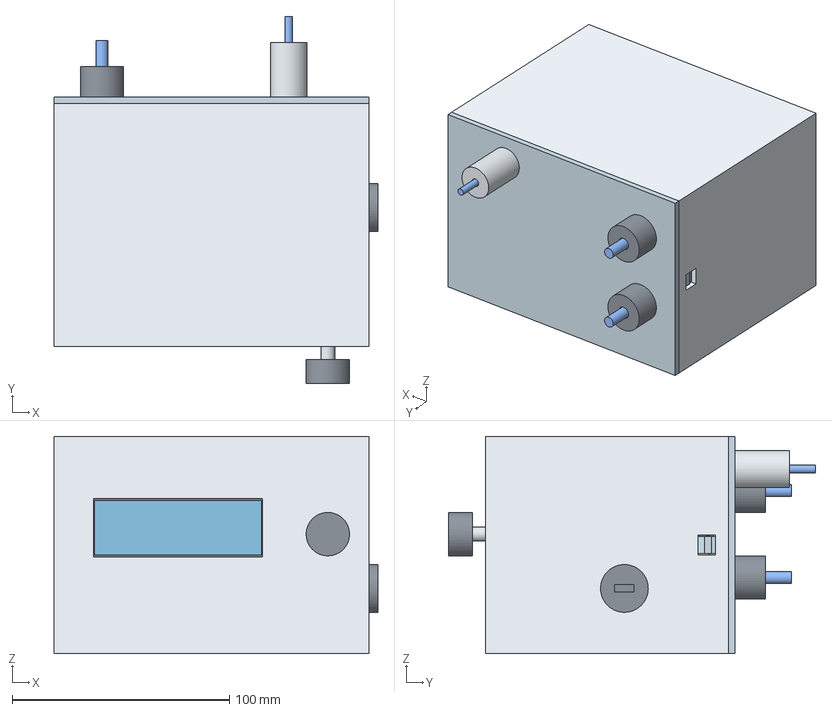
[picture p29: CAD file, 2026-11-05]
hardware/mechanical/exports/enclosure_v03_rails_usb.step
149.0 x 169.0 x 100.0 mm
01_Main_shell_with_LCD_and_A_clips
02_B_removable_carrier_with_clips
03_Rear_panel_with_latches
PCB_A
A_U1_ENVELOPE
A_U2_ENVELOPE
A_J1_ENVELOPE
A_J6_ENVELOPE
A_J7_ENVELOPE
A_J2_ENVELOPE
A_J3_ENVELOPE
A_J4_ENVELOPE
A_J5_ENVELOPE
A_JP1_ENVELOPE
A_C1_ENVELOPE
A_C2_ENVELOPE
A_C3_ENVELOPE
A_R1_ENVELOPE
A_R2_ENVELOPE
A_R3_ENVELOPE
A_R4_ENVELOPE
A_R5_ENVELOPE
PCB_B
B_U1_ENVELOPE
B_U2_ENVELOPE
B_U3_ENVELOPE
B_U4_ENVELOPE
B_Q1_ENVELOPE
B_F1_ENVELOPE
B_D1_ENVELOPE
B_D2_ENVELOPE
B_J2_ENVELOPE
B_J3_ENVELOPE
B_J4_ENVELOPE
B_J1_ENVELOPE
B_J6_ENVELOPE
B_J7_ENVELOPE
B_C1_ENVELOPE
B_C2_ENVELOPE
B_C3_ENVELOPE
B_C4_ENVELOPE
B_C5_ENVELOPE
B_R1_ENVELOPE
B_R2_ENVELOPE
B_R3_ENVELOPE
B_R4_ENVELOPE
B_R5_ENVELOPE
B_R6_ENVELOPE
B_R7_ENVELOPE
LCD_PCB_98x60_TBD
LCD_front_bezel_TBD
LCD_backpack_TBD
LCD_visible_screen
Encoder_body_TBD
Encoder_shaft
Encoder_knob_TBD
BULKHEAD_POWER_12V_TBD
CABLE_POWER_12V
BULKHEAD_HEATER_TBD
CABLE_HEATER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
