gcharvin/esp32_temperature_controller_platformio/hardware/mechanical/exports/parts/01_Main_shell_with_LCD_and_A_clips.step

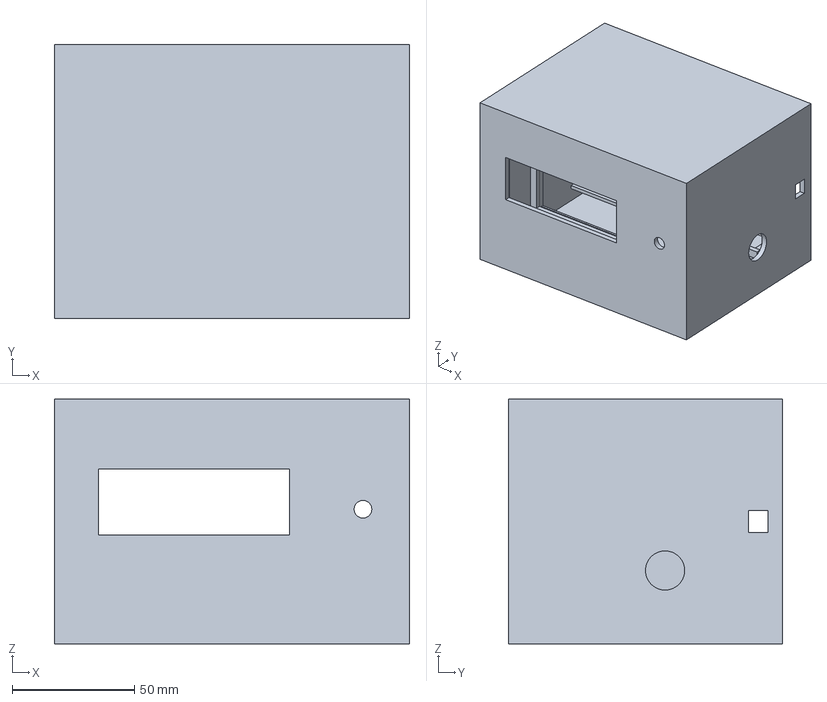
[picture p31: CAD file, 2026-11-05, an earlier design]
hardware/mechanical/exports/parts/01_Main_shell_with_LCD_and_A_clips.step
145.0 x 112.0 x 100.0 mm
