gcharvin/esp32_temperature_controller_platformio/hardware/mechanical/exports/parts/03_Rear_panel_with_latches.step

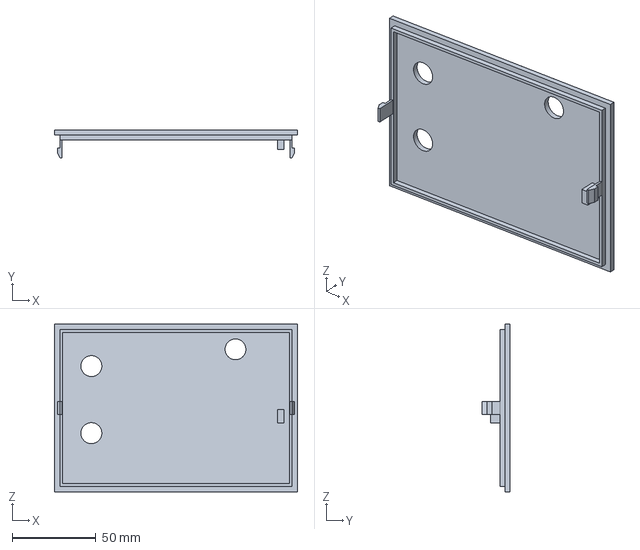
[picture p32: CAD file, 2026-11-05, an earlier design]
hardware/mechanical/exports/parts/03_Rear_panel_with_latches.step
145.0 x 17.0 x 100.0 mm
