gcharvin/esp32_temperature_controller_platformio/(list of files, cad)

Other CAD files:
hardware/mechanical/exports/enclosure_v12_integrated_buck.step
hardware/mechanical/exports/parts_v04/04_Rear_panel_with_latches.step
hardware/mechanical/exports/enclosure_printed_parts.step
hardware/mechanical/exports/enclosure_v03_printed_parts.step
hardware/mechanical/exports/enclosure_v05_printed_parts.step
hardware/mechanical/exports/enclosure_v07_integrated_buck.step
hardware/mechanical/exports/enclosure_v07_printed_parts.step
hardware/mechanical/exports/enclosure_v09_integrated_buck.step
hardware/mechanical/exports/enclosure_v09_printed_parts.step
hardware/mechanical/exports/enclosure_v10_integrated_buck.step
hardware/mechanical/exports/enclosure_v10_printed_parts.step
hardware/mechanical/exports/enclosure_v11_integrated_buck.step
hardware/mechanical/exports/enclosure_v11_printed_parts.step
hardware/mechanical/exports/parts/01_Main_shell_with_LCD_and_A_clips.stl
hardware/mechanical/exports/parts/02_B_removable_carrier_with_clips.step
hardware/mechanical/exports/parts/02_B_removable_carrier_with_clips.stl
hardware/mechanical/exports/parts_v04/01_Shell_open_front_and_rear.step
hardware/mechanical/exports/parts_v04/01_Shell_open_front_and_rear.stl
hardware/mechanical/exports/parts_v04/02_Removable_front_LCD_A.step
hardware/mechanical/exports/parts_v04/02_Removable_front_LCD_A.stl
hardware/mechanical/exports/parts_v04/03_B_removable_carrier.step
hardware/mechanical/exports/parts_v04/03_B_removable_carrier.stl
hardware/mechanical/exports/parts_v04/04_Rear_panel_with_latches.stl
hardware/mechanical/exports/parts_v05/01_Shell_open_front_and_rear.step
hardware/mechanical/exports/parts_v05/01_Shell_open_front_and_rear.stl
hardware/mechanical/exports/parts_v05/02_Removable_front_LCD_A.step
hardware/mechanical/exports/parts_v05/03_B_removable_carrier.step
hardware/mechanical/exports/parts_v05/04_Rear_panel_with_latches.step
hardware/mechanical/exports/parts_v05/05_XL4015_removable_carrier.step
hardware/mechanical/exports/parts_v06/01_Shell_open_front_and_rear.step
hardware/mechanical/exports/parts_v06/01_Shell_open_front_and_rear.stl
hardware/mechanical/exports/parts_v06/02_Removable_front_LCD_A.step
hardware/mechanical/exports/parts_v06/02_Removable_front_LCD_A.stl
hardware/mechanical/exports/parts_v06/03_B_removable_carrier.step
hardware/mechanical/exports/parts_v06/04_Rear_panel_with_latches.step
hardware/mechanical/exports/parts_v06/04_Rear_panel_with_latches.stl
hardware/mechanical/exports/parts_v06/05_XL4015_removable_carrier.step
hardware/mechanical/exports/parts_v06/05_XL4015_removable_carrier.stl
hardware/mechanical/exports/parts_v07/01_Shell_open_front_and_rear.step
hardware/mechanical/exports/parts_v07/02_Removable_front_LCD_A.step
hardware/mechanical/exports/parts_v07/03_B_removable_carrier.step
hardware/mechanical/exports/parts_v07/04_Rear_panel_with_latches.step
hardware/mechanical/exports/parts_v08/01_Shell_open_front_and_rear.step
hardware/mechanical/exports/parts_v08/02_Removable_front_LCD_A.step
hardware/mechanical/exports/parts_v08/03_B_removable_carrier.step
hardware/mechanical/exports/parts_v08/04_Rear_panel_with_latches.step
hardware/mechanical/exports/parts_v09/01_Shell_open_front_and_rear.step
hardware/mechanical/exports/parts_v09/02_Removable_front_LCD_A.step
hardware/mechanical/exports/parts_v09/03_B_removable_carrier.step
hardware/mechanical/exports/parts_v09/04_Rear_panel_with_latches.step
hardware/mechanical/exports/parts_v09/04_Rear_panel_with_latches.stl
hardware/mechanical/exports/parts_v09/05_Translucent_optical_insert.step
hardware/mechanical/exports/parts_v09/06_BH1750_removable_carrier.step
hardware/mechanical/exports/parts_v10/01_Shell_open_front_and_rear.step
hardware/mechanical/exports/parts_v10/02_Removable_front_LCD_A.step
hardware/mechanical/exports/parts_v10/03_B_removable_carrier.step
hardware/mechanical/exports/parts_v10/04_Rear_panel_with_latches.step
hardware/mechanical/exports/parts_v10/05_Translucent_optical_insert.step
hardware/mechanical/exports/parts_v10/06_BH1750_removable_carrier.step
hardware/mechanical/exports/parts_v10/06_BH1750_removable_carrier.stl
hardware/mechanical/exports/parts_v10/98_Optional_jack_fit_coupon.step
hardware/mechanical/exports/parts_v10/98_Optional_jack_fit_coupon.stl
hardware/mechanical/exports/parts_v11/01_Shell_open_front_and_rear.step
hardware/mechanical/exports/parts_v11/02_Removable_front_LCD_A.step
hardware/mechanical/exports/parts_v11/03_B_removable_carrier.step
hardware/mechanical/exports/parts_v11/04_Rear_panel_with_latches.step
hardware/mechanical/exports/parts_v11/04_Rear_panel_with_latches.stl
hardware/mechanical/exports/parts_v11/05_Translucent_optical_insert.step
hardware/mechanical/exports/parts_v11/06_BH1750_removable_carrier.step
hardware/mechanical/exports/parts_v11/98_Optional_jack_fit_coupon.step
hardware/mechanical/exports/parts_v12/01_Shell_open_front_and_rear.stl
hardware/mechanical/exports/parts_v12/02_Removable_front_LCD_A.stl
hardware/mechanical/exports/parts_v12/03_B_removable_carrier.stl
hardware/mechanical/exports/parts_v12/05_Translucent_optical_insert.stl
src/generic_controller v21.f3z
