gcharvin/esp32_temperature_controller_platformio/hardware/manufacturing/engineering_review.md

# Décisions techniques pour le premier lot

Cette revue termine les choix techniques locaux pour **A v0.4 et B v0.5**.
Elle prépare un lot de prototypes assemblés ; elle ne transforme ni les
simulations ni le modèle 3D en qualification du matériel réel.

## Références et empreintes figées

`component_selection.json` fixe les MPN des 70 composants physiques natifs.
Ils sont inscrits dans les schémas et PCB, puis comparés aux netlists fraîches.
Les deux barrettes HCTL et le cavalier livré séparément sont des articles
supplémentaires explicites. La DevKit reste fournie par l'utilisateur et NT1
reste une jonction de cuivre. Le fabricant doit sourcer les références exactes,
notamment C10, R13 et les sockets HCTL ; une référence sans ID JLC n'est pas une pièce
libre de substitution.

Les empreintes locales remplacent les hypothèses de perçage de la DevKit et
les pastilles de soudure manuelle des LED. Les recommandations R13 sont déjà
intégrées. Les dimensions et sources sont dans `land_pattern_review.json`.
Le perçage des sockets est nominalement 1,05 mm ; le fournisseur confirmera
sa tolérance de trou fini et son procédé de soudure au DFM.

Sources : [HCTL](https://www.lcsc.com/datasheet/C2897378.pdf),
[LED verte](https://www.kingbrightusa.com/images/catalog/spec/apt2012lzgck.pdf),
[LED jaune](https://www.kingbrightusa.com/images/catalog/spec/apt2012lsyck-j3-prv.pdf),
[R13](https://www.vishay.com/docs/30100/wsl.pdf).

## Condensateurs et régulateurs 3,3 V

Choix conservé pour ce prototype : **0603B105K160CT**, 1 µF nominal,
16 V, X7R, ±10 %, sur les découplages 1 µF existants. Le circuit typique AP2112
emploie 1 µF en entrée et sortie et recommande X5R/X7R. La sélection suit cette
application nominale. La valeur effective après polarisation, température et
vieillissement n'est pas égale à la capacité nominale et aucune borne de
stabilité garantie n'est déduite d'une courbe typique non garantie. Ce point
est accepté pour le **lot de mise au point**, avec vérification des rails et
des transitoires au banc ; il ne reste pas un choix de MPN à effectuer.
Les empreintes 0603 permettent une révision de valeur après mesures si besoin.
Le 10 µF d'entrée A/C3 reste un découplage supplémentaire, pas la compensation
du convertisseur LM2596. C10/R13 conservent leur réseau de retour simulé.

Sources : [AP2112, circuit typique et note4](https://www.diodes.com/datasheet/download/AP2112.pdf),
[Walsin, caractéristiques de la référence sélectionnée](https://www.ic-components.se/files/d4/0603B105K160CT.pdf).

Le courant nominal 600 mA de l'AP2112 n'est pas un budget thermique utilisable
sans calcul sur ce PCB. Pour la mise au point, limiter les périphériques 3,3 V
de A à **100 mA** et ceux de B à **20 mA**, en conservant **0,8 A total** sur
le 5 V partagé, DevKit comprise. Ces plafonds sont des contraintes d'essai,
pas des mesures des modules existants. Relever les courants et températures
réels avant d'augmenter ces budgets.

## Chutes de tension et faisceaux

Les faisceaux A/B proposés mesurent 300 mm. POWER utilise AWG22, les signaux
AWG26. À 0,8 A, une boucle cuivre AWG22 de 0,6 m représente environ 26 mV de
chute à 20°C, avant les contacts ; cet ordre de grandeur ne garantit pas
la résistance réelle d'un câble fini. Le critère doit porter sur **A/J1**.

Un B/J1 à 4,75 V ne peut pas garantir A/J1 à 4,75 V après un faisceau résistif.
Le contrôle du prototype impose donc **4,90–5,15 V sur B/J1**, en continu à
température de contrôle, puis **4,75–5,25 V sur A/J1** avec le faisceau réel.
La première plage est un critère de réception plus serré que l'enveloppe
complète du LM2596 ; elle n'est pas une nouvelle garantie TI. L'intégration
et les essais en température restent nécessaires. Ne pas relever la sortie
du buck par un montage improvisé si un exemplaire échoue à ce contrôle.

## Mécanique et service

La maquette v0.10 réserve les dimensions maximales documentées des sockets,
un espace de montage de 0,15 mm et une entretoise plastique de broches mÃ¢les
supposée de 2,54 mm. Cette dernière cote reste une enveloppe de conception,
pas une mesure des trois DevKit. La hauteur montée des borniers Phoenix est
13,8 mm ; l'enveloppe utilise 14 mm. Les accès et les 20 séquences rigides sont
recontrôlés. Le modèle ne valide ni le sertissage, ni les câbles réels, ni les
efforts et tolérances des clips. Les vérifications d'insertion et le coupon
d'impression appartiennent à l'intégration du prototype, pas au contrôle
électrique du PCB nu.

Source : [Phoenix1715721](https://www.phoenixcontact.com/en-gb/products/printed-circuit-board-terminal-mkds-15-2-508-1715721).

Le service USB retenu pour ce lot est **USB seul, sources externes coupées,
J1/J6/J7 débranchés, JP1 retiré**. Le monitoring USB pendant le chauffage reste
une fonction non qualifiée, à tester ensuite avec séparation de VBUS. Cela
ne demande pas de changer le PCB pour commander le lot de mise au point.
Voir `power_and_usb_review.md` pour la procédure et les restrictions.

## Portée des vérifications et suite

Les valeurs électriques du buck, le brochage et les pistes sont conservés.
Les simulations existantes restent pertinentes pour leur périmètre ; les
relancer sans changement de circuit n'apporterait pas une preuve thermique.
Le DRC, les empreintes modifiées, les MPN natifs, les vrais perçages Excellon,
les contours et la pâte Gerber sont vérifiés après cette révision.

Avant lancement, le fabricant doit rendre son DFM/panneau, son accord sur le
profil thermique/MSL et les références, son aperçu de placement et son devis.
Après réception viennent les essais du plan de banc, le firmware adapté et
la protection thermique indépendante correspondant à l'expérience. Le
chauffage 100 W n'est pas un essai initial d'alimentation des cartes.

## Révision UART du 10 novembre 2026

A0.4.2 / B0.5.2 ajoutent J10 sur chaque PCB, avec GPIO17 TX_A et GPIO16 RX_A
sur A. Aucun second MCU ou transceiver sur B température : ses contacts2/3
restent NC. Les broches de commandes J7, le convertisseur et la mesure NTC
sont inchangés. Voir `../UART_EXTENSION.md` et les vérifications de conservation
des pistes. Deux JST traversants sont ajoutés au total ; pas de nouveau CMS.

L’utilisateur rapporte un fonctionnement simultané USB/VIN sans problème
observé sur les DevKit utilisées. JP1 est conservé dans cette révision UART
comme isolement de banc ; aucune incompatibilité générale n’est déduite de
l’absence de schéma documenté. Les chemins des variantes restent à caractériser.

## Révision A0.4.3 / B0.5.3 : remplacements examinés au devis

Les cinq condensateurs 1 µF deviennent Walsin 0603B105K160CT ; A/C3 devient
Samsung CL10A106KP8NNNC. Les deux sockets deviennent HCTL PM254-1-15-Z-8.5.
C10 devient Panasonic EEUFS1V331LB, hauteur maximale 16,5 mm, pas formé 5 mm ;
son dégagement natif Ø10 et ses pastilles sont conservés. Le modèle 3D local
représente l'enveloppe maximale. R13 devient Vishay WSL1206R0500FEA, 50 mΩ.
D8 devient Kingbright APT2012LSYCK/J3-PRV, jaune, avec R12 inchangée.

Les sept simulations de cette combinaison sont désormais liées au PCB par
`../power_study/lm2596/current_acceptance.json`. Elles couvrent notamment la
borne basse 49 mΩ et le stress 180 mΩ du retour C10. Leur plage régulée globale
est 4,9575–5,0128 V et l'ondulation maximale 35,31 mV crête à crête.
Les limites physiques, thermiques et CEM de la qualification restent ouvertes.
Aucun achat ni ordre de fabrication n'est autorisé par cette révision.
