gcharvin/esp32_temperature_controller_platformio/hardware/manufacturing/lcsc_cable_rfq/pin_to_pin.csv

ID | End_A | End_A_pin_or_function | End_B | End_B_pin_or_function | Signal | Colour | Notes
H01 | A/J1 | 1 | B/J1 | 1 | GND | black | Electrical numbers/functions, not drawing left-to-right indices
H01 | A/J1 | 2 | B/J1 | 2 | +5V_AB | red | Electrical numbers/functions, not drawing left-to-right indices
H02 | A/J6 | 1 | B/J6 | 1 | GND | black | Electrical numbers/functions, not drawing left-to-right indices
H02 | A/J6 | 2 | B/J6 | 2 | I2C_SDA | blue | Electrical numbers/functions, not drawing left-to-right indices
H02 | A/J6 | 3 | B/J6 | 3 | I2C_SCL | yellow | Electrical numbers/functions, not drawing left-to-right indices
H03 | A/J7 | 1 | B/J7 | 1 | GND | black | Electrical numbers/functions, not drawing left-to-right indices
H03 | A/J7 | 2 | B/J7 | 2 | PWM0 | white | Electrical numbers/functions, not drawing left-to-right indices
H03 | A/J7 | 3 | B/J7 | 3 | ENABLE | red | Electrical numbers/functions, not drawing left-to-right indices
H03 | A/J7 | 4 | B/J7 | 4 | FAULT_N | yellow | Electrical numbers/functions, not drawing left-to-right indices
H03 | A/J7 | 5 | B/J7 | 5 | PWM1 / B pad NC | blue | Wire present; B temperature PCB pad is NC
H03 | A/J7 | 6 | B/J7 | 6 | DIN0 / B pad NC | green | Wire present; B temperature PCB pad is NC
H04 | A/J2 | 1 | Freenove LCD2004 I2C backpack headers | GND | GND | black | Electrical numbers/functions, not drawing left-to-right indices
H04 | A/J2 | 2 | Freenove LCD2004 I2C backpack headers | VCC | +3V3_A | red | Electrical numbers/functions, not drawing left-to-right indices
H04 | A/J2 | 3 | Freenove LCD2004 I2C backpack headers | SDA | I2C_SDA | blue | Electrical numbers/functions, not drawing left-to-right indices
H04 | A/J2 | 4 | Freenove LCD2004 I2C backpack headers | SCL | I2C_SCL | yellow | Electrical numbers/functions, not drawing left-to-right indices
H05 | A/J3 | 1 | ADA377 candidate encoder | A | ENC_A | white | Electrical numbers/functions, not drawing left-to-right indices
H05 | A/J3 | 2 | ADA377 candidate encoder | B | ENC_B | blue | Electrical numbers/functions, not drawing left-to-right indices
H05 | A/J3 | 3 | ADA377 candidate encoder | SW1 | ENC_SW | yellow | Electrical numbers/functions, not drawing left-to-right indices
H05 | A/J3 | 4 | ADA377 candidate encoder | C | GND | black | Intentional GND branch C+SW2
H05 | A/J3 | 4 | ADA377 candidate encoder | SW2 | GND branch | black | Intentional GND branch C+SW2
H06 | A/J4 | 1 | Adafruit4821 STEMMA QT port | 1 | GND | black | Electrical numbers/functions, not drawing left-to-right indices
H06 | A/J4 | 2 | Adafruit4821 STEMMA QT port | 2 | +3V3_A / moduleVIN | red | Electrical numbers/functions, not drawing left-to-right indices
H06 | A/J4 | 3 | Adafruit4821 STEMMA QT port | 3 | I2C_SDA | blue | Electrical numbers/functions, not drawing left-to-right indices
H06 | A/J4 | 4 | Adafruit4821 STEMMA QT port | 4 | I2C_SCL | yellow | Electrical numbers/functions, not drawing left-to-right indices
H07 | A/J5 | 1 | GY302 male headers | GND | GND | black | Electrical numbers/functions, not drawing left-to-right indices
H07 | A/J5 | 2 | GY302 male headers | VCC | +3V3_A | red | Electrical numbers/functions, not drawing left-to-right indices
H07 | A/J5 | 3 | GY302 male headers | SDA | I2C_SDA | blue | Electrical numbers/functions, not drawing left-to-right indices
H07 | A/J5 | 4 | GY302 male headers | SCL | I2C_SCL | yellow | Electrical numbers/functions, not drawing left-to-right indices
H08 | B/J4 | 1 | Rear femalePJ392 socket | TIP | +3V3_B | red | RING isolated; sleeve is NTC_RAW, NOT GND
H08 | B/J4 | 2 | Rear femalePJ392 socket | SLEEVE | NTC_RAW (NOT GND) | white | RING isolated; sleeve is NTC_RAW, NOT GND
H09 | MaleTRS probe plug | TIP | Passive15k NTC probe | NTC1 | NTC excitation via internalJ4.1 | supplier proposed | RING isolated; sleeve is NTC_RAW, NOT GND
H09 | MaleTRS probe plug | SLEEVE | Passive15k NTC probe | NTC2 | NTC measurement via internalJ4.2 | supplier proposed | RING isolated; sleeve is NTC_RAW, NOT GND
H10 | B/J2 power terminal | J2.1 | ExternalDC supply output | DC_POS | VIN_RAW positive | red | Electrical numbers/functions, not drawing left-to-right indices
H10 | B/J2 power terminal | J2.2 | ExternalDC supply output | DC_RETURN | PGND return | black | Electrical numbers/functions, not drawing left-to-right indices
H11 | B/J3 power terminal | J3.1 | Resistive heater | HEATER_POS | VIN_PROTECTED positive | red | Electrical numbers/functions, not drawing left-to-right indices
H11 | B/J3 power terminal | J3.2 | Resistive heater | HEATER_RETURN | HEATER_LOW switched return | black | Electrical numbers/functions, not drawing left-to-right indices
H12 | Upstream positive heater path | UPSTREAM_POS | Cutoff then downstream positive heater path | CUTOFF_TERMINAL_1 | Series positive path, location TBD | red | Electrical numbers/functions, not drawing left-to-right indices
H12 | Upstream positive heater path | CUTOFF_TERMINAL_2 | Cutoff then downstream positive heater path | DOWNSTREAM_POS | Series positive path, location TBD | red | Electrical numbers/functions, not drawing left-to-right indices
