gcharvin/esp32_temperature_controller_platformio/hardware/manufacturing/review_A04_B05/assembly_review/assembly_pad_map.csv

Board | Reference | Pin | Net | Local_X_mm | Local_Y_mm | Native_X_mm | Native_Y_mm
A | C1 | 1 | +5V_AB | 74.225 | 55.0 | 134.225 | 110.0
A | C1 | 2 | GND | 75.775 | 55.0 | 135.775 | 110.0
A | C2 | 1 | +3V3_A | 84.225 | 55.0 | 144.225 | 110.0
A | C2 | 2 | GND | 85.775 | 55.0 | 145.775 | 110.0
A | C3 | 1 | +5V_AB | 87.225 | 60.0 | 147.225 | 115.0
A | C3 | 2 | GND | 88.775 | 60.0 | 148.775 | 115.0
A | D1 | 1 | GND | 97.975 | 55.0 | 157.975 | 110.0
A | D1 | 2 | LED_A_D1 | 100.025 | 55.0 | 160.025 | 110.0
A | D2 | 1 | GND | 97.975 | 64.0 | 157.975 | 119.0
A | D2 | 2 | LED_A_D2 | 100.025 | 64.0 | 160.025 | 119.0
A | J1 | 1 | GND | 94.0 | 12.0 | 154.0 | 67.0
A | J1 | 2 | +5V_AB | 96.5 | 12.0 | 156.5 | 67.0
A | J2 | 1 | GND | 66.0 | 10.0 | 126.0 | 65.0
A | J2 | 2 | +3V3_A | 68.5 | 10.0 | 128.5 | 65.0
A | J2 | 3 | I2C_SDA | 71.0 | 10.0 | 131.0 | 65.0
A | J2 | 4 | I2C_SCL | 73.5 | 10.0 | 133.5 | 65.0
A | J3 | 1 | ENC_A | 72.0 | 64.0 | 132.0 | 119.0
A | J3 | 2 | ENC_B | 74.5 | 64.0 | 134.5 | 119.0
A | J3 | 3 | ENC_SW | 77.0 | 64.0 | 137.0 | 119.0
A | J3 | 4 | GND | 79.5 | 64.0 | 139.5 | 119.0
A | J4 | 1 | GND | 44.0 | 10.0 | 104.0 | 65.0
A | J4 | 2 | +3V3_A | 46.5 | 10.0 | 106.5 | 65.0
A | J4 | 3 | I2C_SDA | 49.0 | 10.0 | 109.0 | 65.0
A | J4 | 4 | I2C_SCL | 51.5 | 10.0 | 111.5 | 65.0
A | J5 | 1 | GND | 23.0 | 10.0 | 83.0 | 65.0
A | J5 | 2 | +3V3_A | 25.5 | 10.0 | 85.5 | 65.0
A | J5 | 3 | I2C_SDA | 28.0 | 10.0 | 88.0 | 65.0
A | J5 | 4 | I2C_SCL | 30.5 | 10.0 | 90.5 | 65.0
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
B | U5 | 1 | +5V_AB | 58.8625 | 34.05 | 118.8625 | 89.05
B | U5 | 2 | PGND | 58.8625 | 35.0 | 118.8625 | 90.0
B | U5 | 3 | GATE_CMD | 58.8625 | 35.95 | 118.8625 | 90.95
B | U5 | 4 | PGND | 61.1375 | 35.95 | 121.1375 | 90.95
B | U5 | 5 | GATE_DRV | 61.1375 | 34.05 | 121.1375 | 89.05
