gcharvin/esp32_temperature_controller_platformio/hardware/manufacturing/jlcpcb/support/placement_A_REFERENCE.png

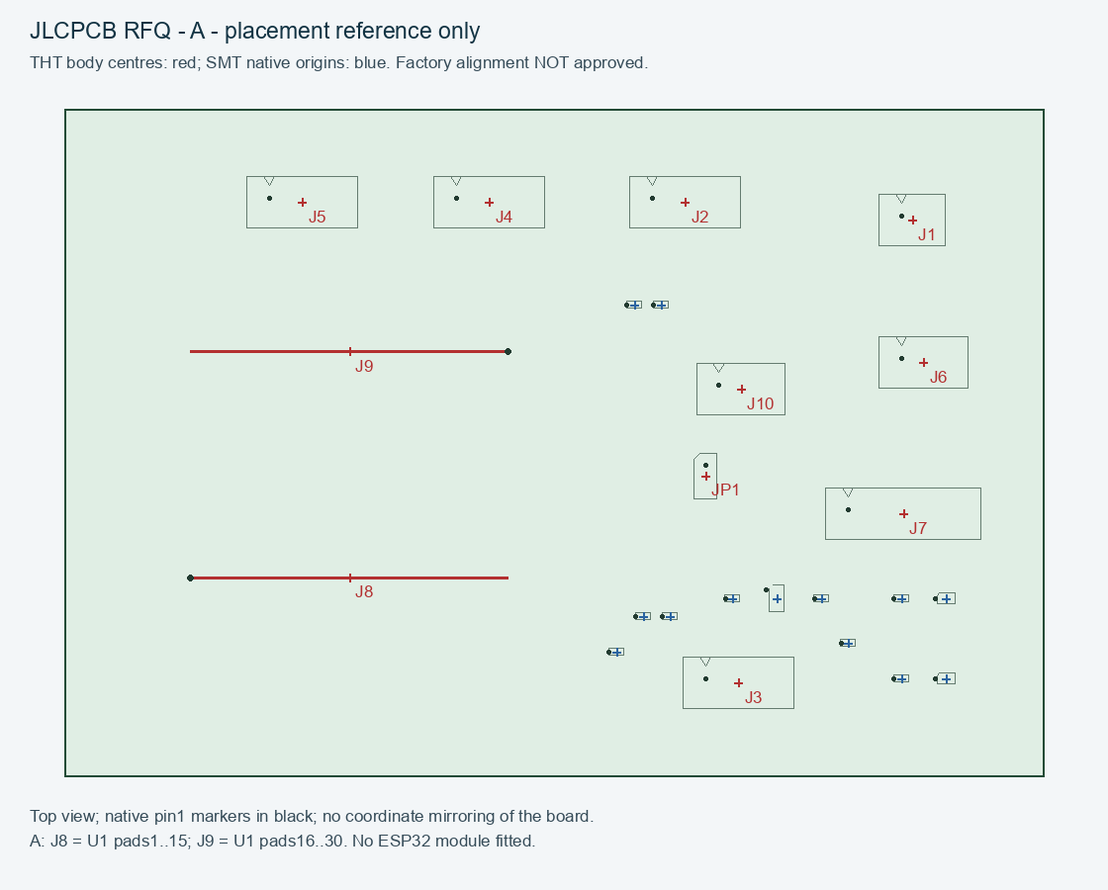
hardware/manufacturing/jlcpcb/support/placement_A_REFERENCE.png
