gcharvin/esp32_temperature_controller_platformio/hardware/manufacturing/jlcpcb/support/placement_B_REFERENCE.png

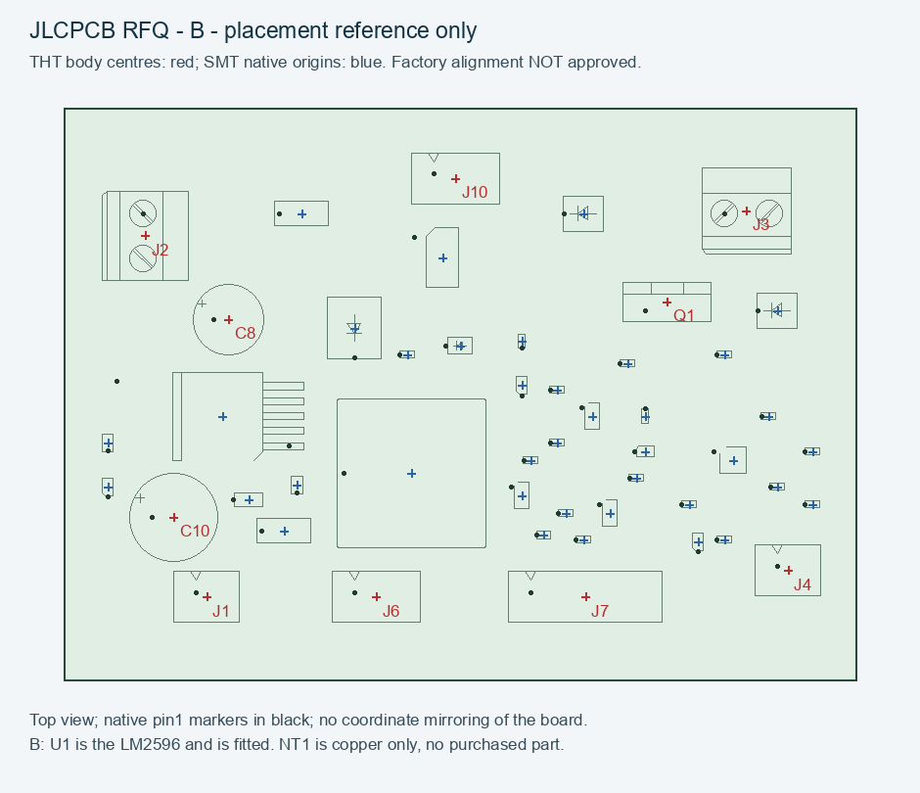
hardware/manufacturing/jlcpcb/support/placement_B_REFERENCE.png
