gcharvin/esp32_temperature_controller_platformio/hardware/manufacturing/online_quote_20261110/quote_B.png

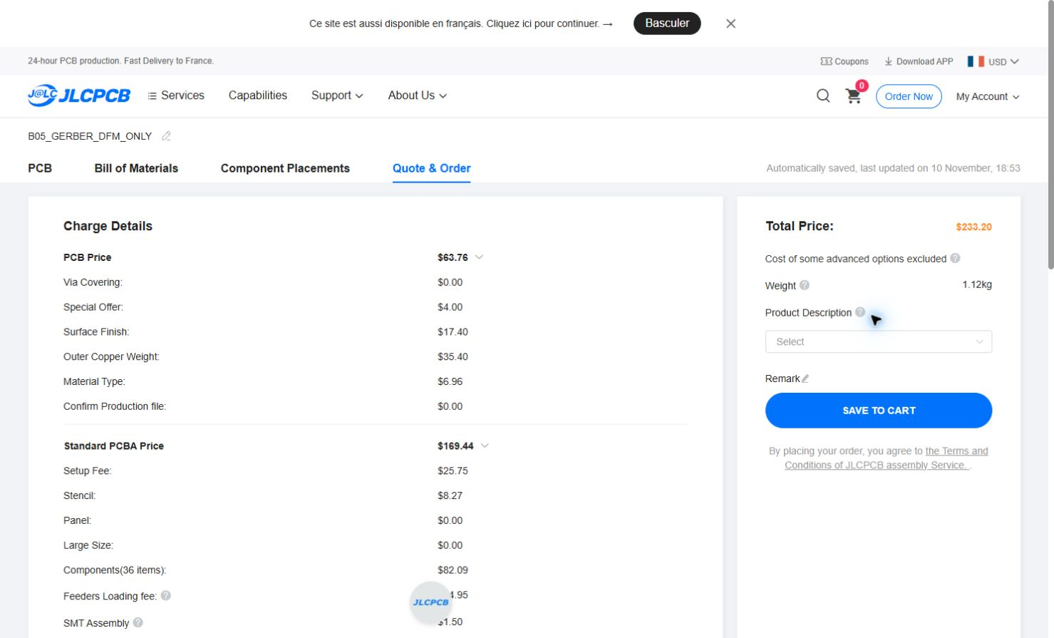
hardware/manufacturing/online_quote_20261110/quote_B.png
