gcharvin/esp32_temperature_controller_platformio/hardware/manufacturing/online_quote_20261110/simulation/results/line_step.png

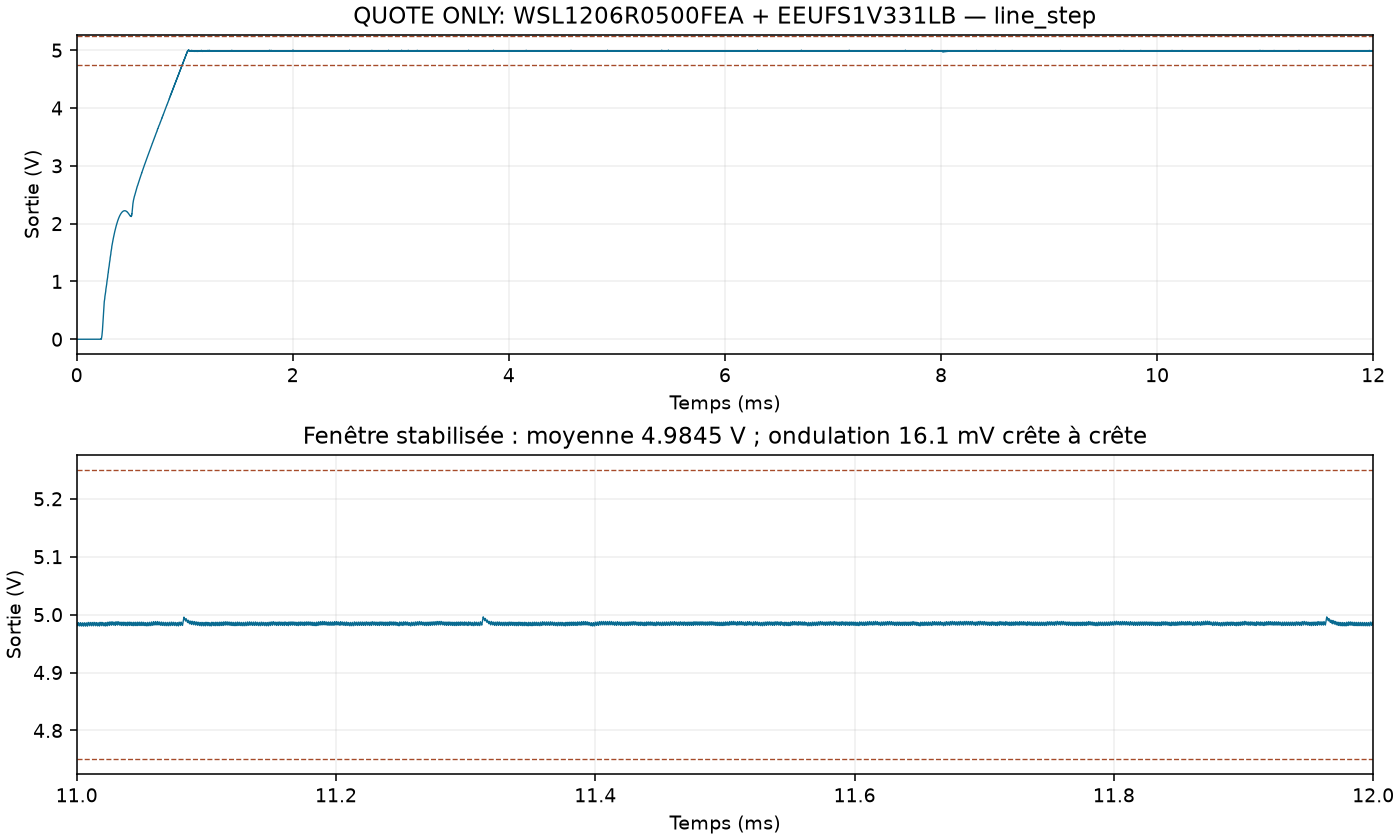
hardware/manufacturing/online_quote_20261110/simulation/results/line_step.png
