gcharvin/esp32_temperature_controller_platformio/hardware/manufacturing/review_A04_B05/gerber_review/B_front.png

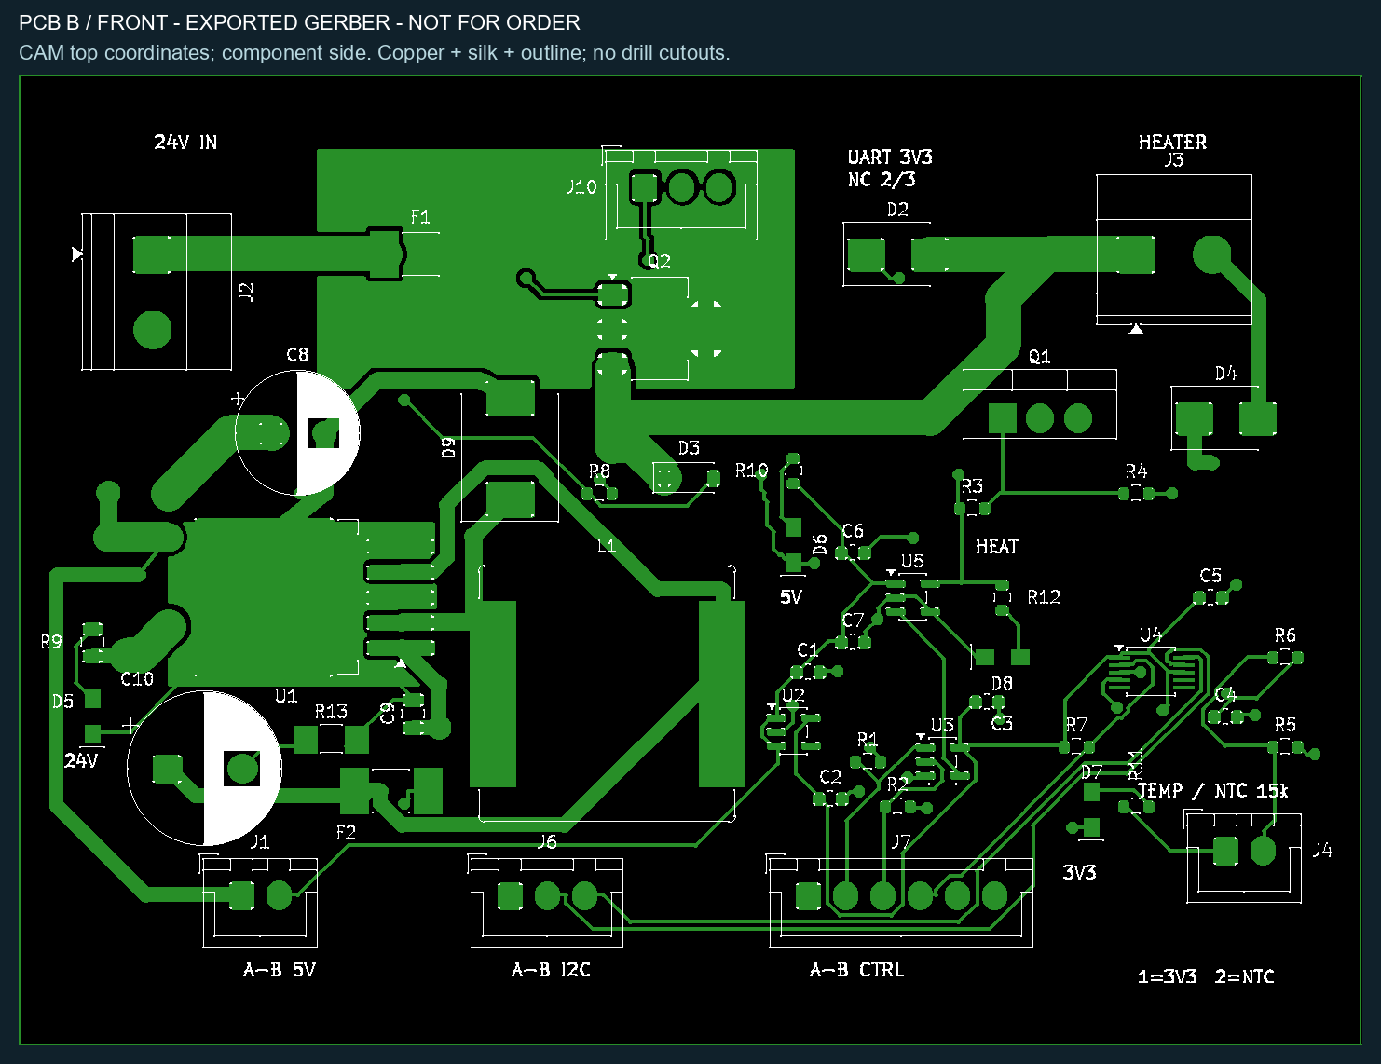
hardware/manufacturing/review_A04_B05/gerber_review/B_front.png
