gcharvin/esp32_temperature_controller_platformio/hardware/mechanical/exports/preview_assembled.png

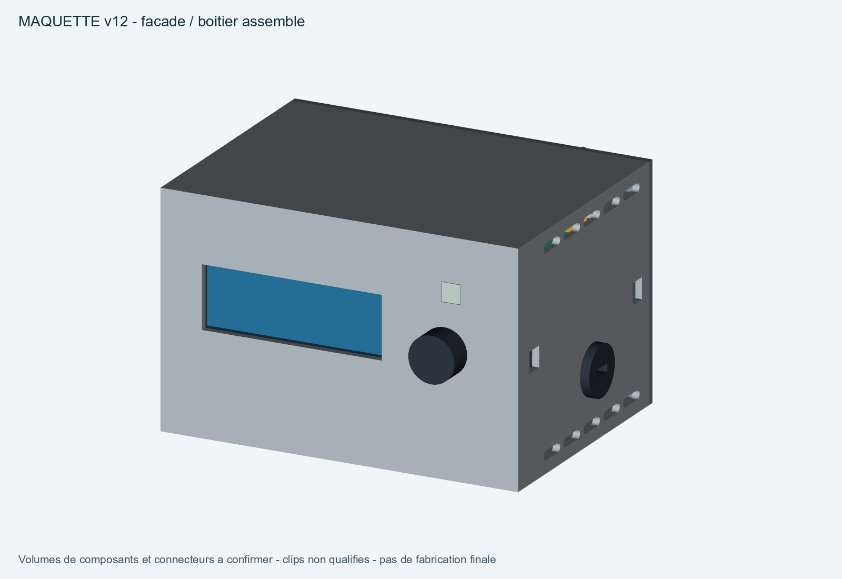
hardware/mechanical/exports/preview_assembled.png
