gcharvin/esp32_temperature_controller_platformio/hardware/review/board_guides/carte_B_annotee.png

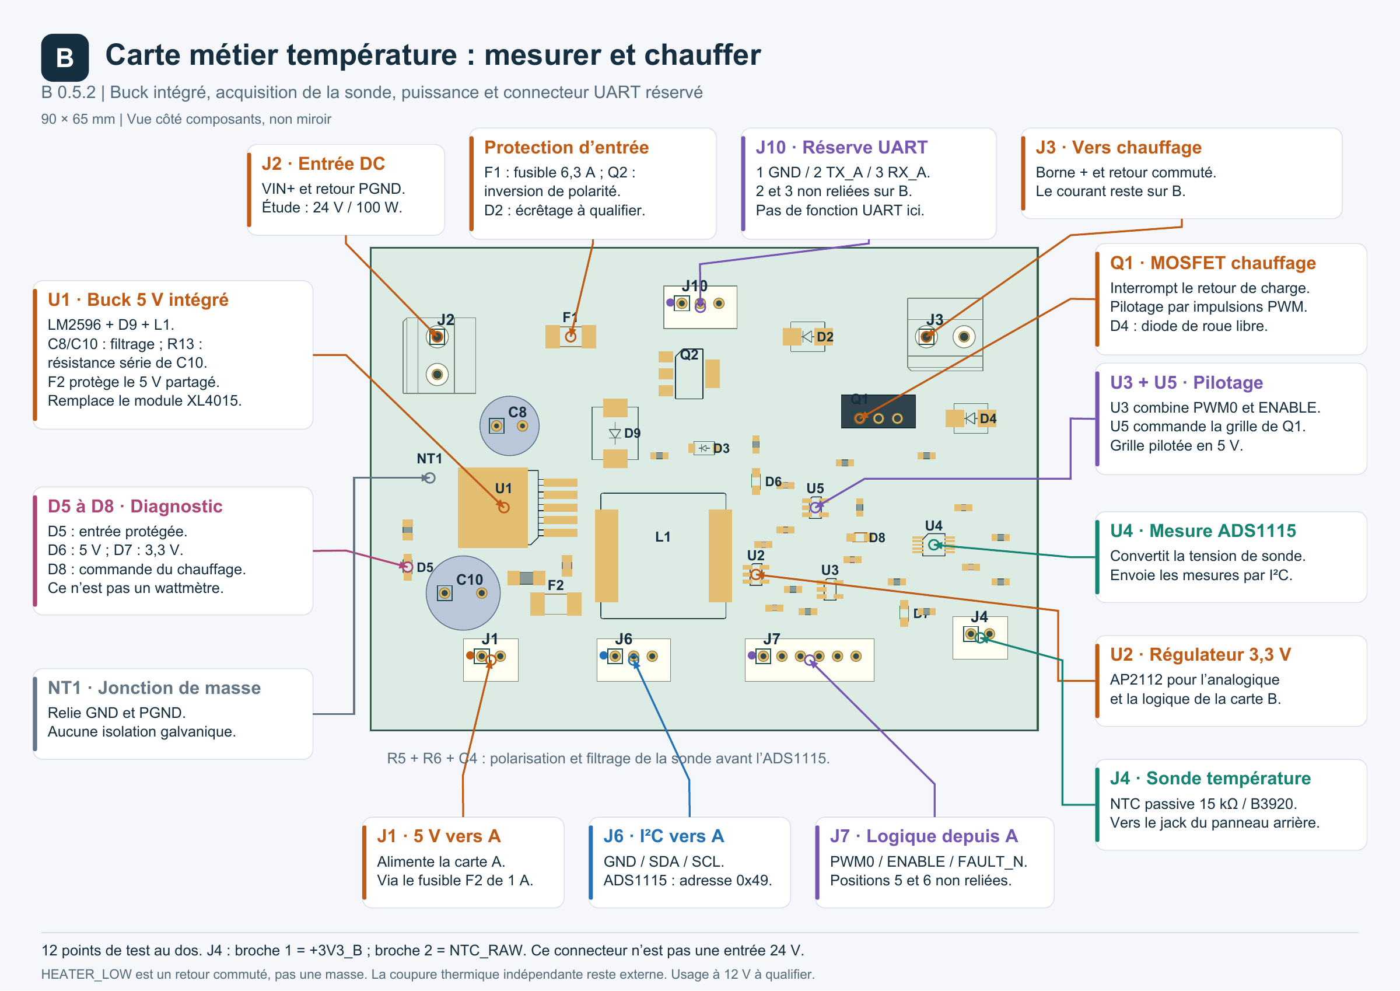
hardware/review/board_guides/carte_B_annotee.png
