gcharvin/esp32_temperature_controller_platformio/hardware/review/placement_validation.txt

pcb_a_display: 110 x 75 x 1.6 mm; DRC geometry 0 violations; 0 unconnected items; routed.
Padless provisional envelopes: none
pcb_b_temperature: 90 x 65 x 1.6 mm; DRC geometry 0 violations; 0 unconnected items; routed.
Padless provisional envelopes: none
Clip bands and native footprint net assignments verified. No thermal, RF, print tolerance, assembly parity or manufacturing qualification implied.
