gcharvin/esp32_temperature_controller_platformio/hardware/review/test_point_map.csv

Board | TestPoint | Net | Side | Front_coordinate_X_mm | Front_coordinate_Y_mm | Nominal_pad_diameter_mm | Assembly
A | TP1 | GND | BACK / B.Cu | 94.0 | 15.0 | 1.5 | NONE_COPPER_DO_NOT_POPULATE
A | TP2 | +5V_AB | BACK / B.Cu | 99.0 | 13.0 | 1.5 | NONE_COPPER_DO_NOT_POPULATE
A | TP3 | +5V_DEVKIT | BACK / B.Cu | 72.0 | 45.0 | 1.5 | NONE_COPPER_DO_NOT_POPULATE
A | TP4 | +3V3_A | BACK / B.Cu | 25.0 | 13.0 | 1.5 | NONE_COPPER_DO_NOT_POPULATE
A | TP5 | I2C_SDA | BACK / B.Cu | 96.0 | 31.0 | 1.5 | NONE_COPPER_DO_NOT_POPULATE
A | TP6 | I2C_SCL | BACK / B.Cu | 100.0 | 31.0 | 1.5 | NONE_COPPER_DO_NOT_POPULATE
A | TP7 | PWM0 | BACK / B.Cu | 90.0 | 48.0 | 1.5 | NONE_COPPER_DO_NOT_POPULATE
A | TP8 | ENABLE | BACK / B.Cu | 95.0 | 48.0 | 1.5 | NONE_COPPER_DO_NOT_POPULATE
A | TP9 | FAULT_N | BACK / B.Cu | 95.0 | 41.0 | 1.5 | NONE_COPPER_DO_NOT_POPULATE
A | TP10 | ENC_SW | BACK / B.Cu | 77.0 | 67.0 | 1.5 | NONE_COPPER_DO_NOT_POPULATE
B | TP1 | PGND | BACK / B.Cu | 9.0 | 20.0 | 1.5 | NONE_COPPER_DO_NOT_POPULATE
B | TP2 | VIN_PROTECTED | BACK / B.Cu | 72.0 | 13.0 | 1.5 | NONE_COPPER_DO_NOT_POPULATE
B | TP3 | +5V_BUCK | BACK / B.Cu | 10.0 | 49.0 | 1.5 | NONE_COPPER_DO_NOT_POPULATE
B | TP4 | +5V_AB | BACK / B.Cu | 20.0 | 56.0 | 1.5 | NONE_COPPER_DO_NOT_POPULATE
B | TP5 | +3V3_B | BACK / B.Cu | 81.0 | 55.0 | 1.5 | NONE_COPPER_DO_NOT_POPULATE
B | TP6 | NTC_RAW | BACK / B.Cu | 83.0 | 48.0 | 1.5 | NONE_COPPER_DO_NOT_POPULATE
B | TP7 | NTC_ADC | BACK / B.Cu | 74.0 | 41.0 | 1.5 | NONE_COPPER_DO_NOT_POPULATE
B | TP8 | PWM0 | BACK / B.Cu | 55.0 | 58.0 | 1.5 | NONE_COPPER_DO_NOT_POPULATE
B | TP9 | ENABLE | BACK / B.Cu | 60.0 | 58.0 | 1.5 | NONE_COPPER_DO_NOT_POPULATE
B | TP10 | FAULT_N | BACK / B.Cu | 60.0 | 51.0 | 1.5 | NONE_COPPER_DO_NOT_POPULATE
B | TP11 | GATE_DRV | BACK / B.Cu | 63.0 | 26.0 | 1.5 | NONE_COPPER_DO_NOT_POPULATE
B | TP12 | GND | BACK / B.Cu | 15.0 | 58.0 | 1.5 | NONE_COPPER_DO_NOT_POPULATE
