gcharvin/esp32_temperature_controller_platformio/hardware/manufacturing/jlcpcb/support/test_points_B_back.png

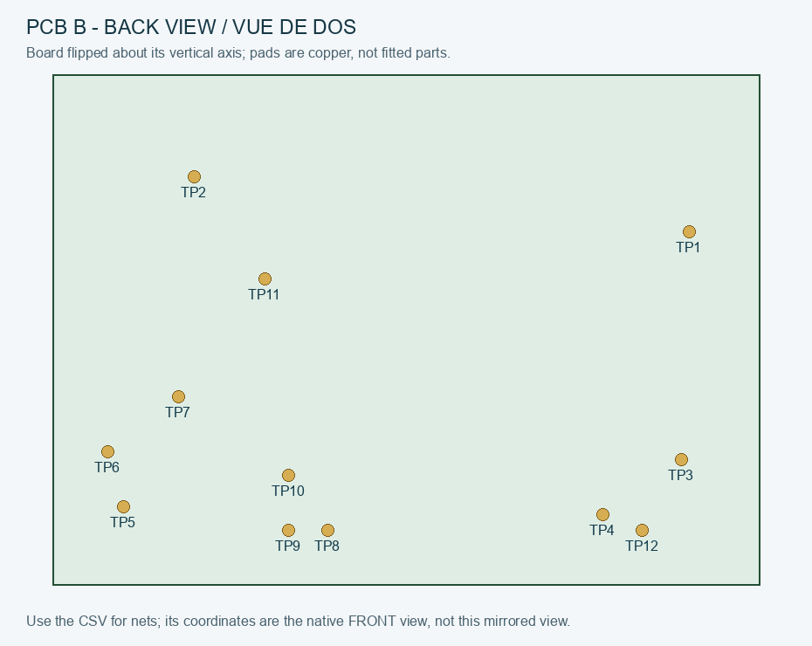
hardware/manufacturing/jlcpcb/support/test_points_B_back.png
