gcharvin/esp32_temperature_controller_platformio/hardware/review/test_points_A_back.png

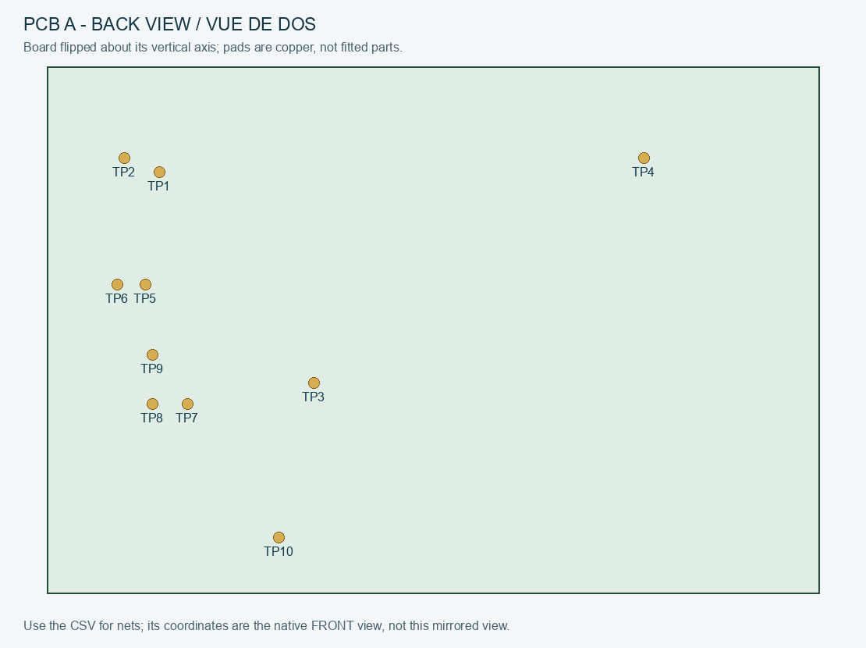
hardware/review/test_points_A_back.png
