gcharvin/esp32_temperature_controller_platformio/hardware/review/pcb_b_temperature.pdf

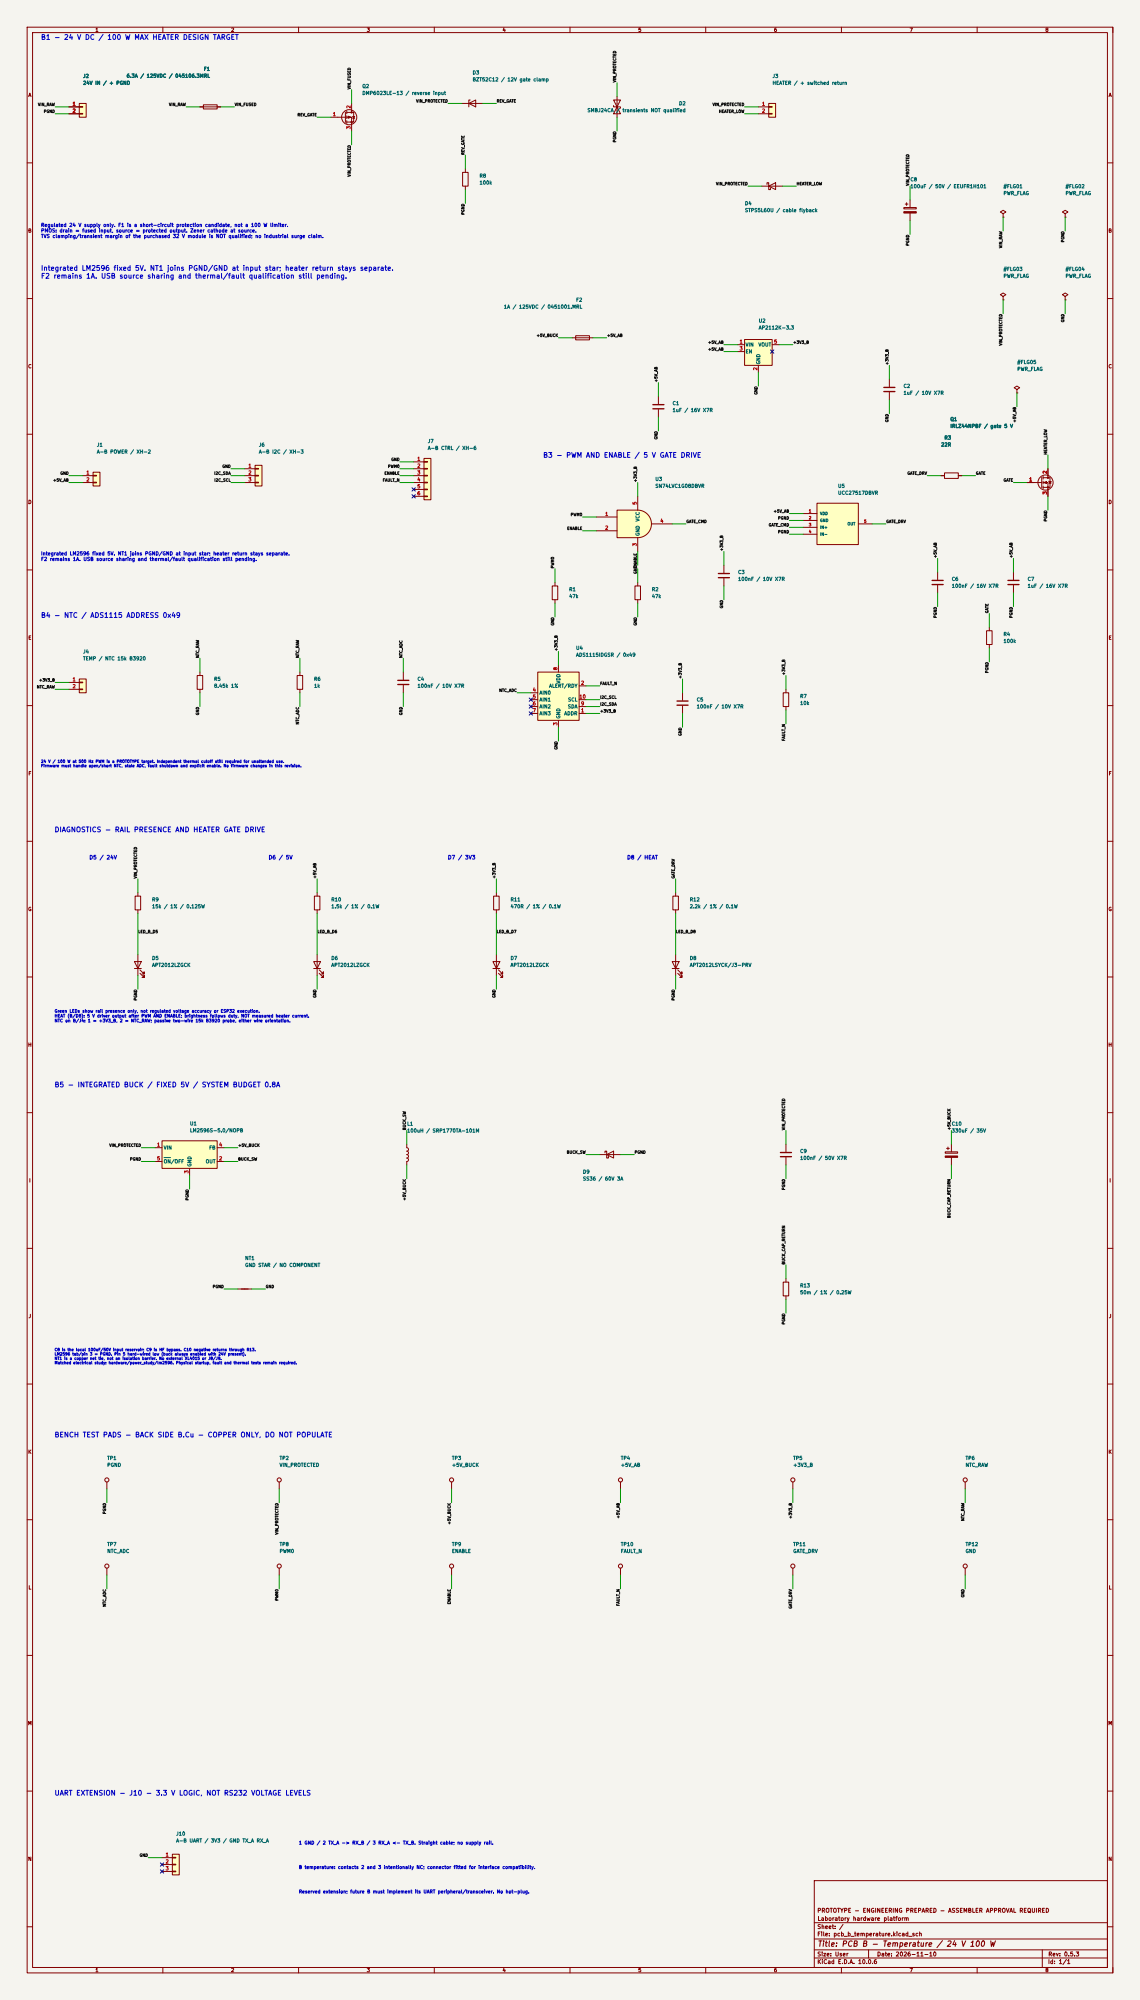
[picture p60: page 1]

B1 - 24 V DC / 100 W MAX HEATER DESIGN TARGET

Regulated 24 V supply only. F1 is a short-circuit protection candidate, not a 100 W limiter. PMOS: drain = fused input, source = protected output. Zener cathode at source. TVS clamping/transient margin of the purchased 32 V module is NOT qualified; no industrial surge claim.

Integrated LM2596 fixed 5V. NT1 joins PGND/GND at input star; heater return stays separate.
F2 remains 1A. USB source sharing and thermal/fault qualification still pending.

B3 - PWM AND ENABLE / 5 V GATE DRIVE

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

24 V / 100 W at 500 Hz PWM is a PROTOTYPE target. Independent thermal cutoff still required for unattended use. Firmware must handle open/short NTC, stale ADC, fault shutdown and explicit enable. No firmware changes in this revision. DIAGNOSTICS - RAIL PRESENCE AND HEATER GATE DRIVE

Green LEDs show rail presence only, not regulated voltage accuracy or ESP32 execution. HEAT (B/D8): 5 V driver output after PWM AND ENABLE; brightness follows duty, NOT measured heater current. NTC on B/J4: 1 = +3V3_B, 2 = NTC_RAW; passive two-wire 15k B3920 probe, either wire orientation. B5 - INTEGRATED BUCK / FIXED 5V / SYSTEM BUDGET 0.8A

NT1 GND STAR / NO COMPONENT

C8 is the local 100uF/50V input reservoir; C9 is HF bypass. C10 negative returns through R13. LM2596 tab/pin 3 = PGND. Pin 5 hard-wired low (buck always enabled with 24V present). NT1 is a copper net tie, not an isolation barrier. No external XL4015 or J8/J9. Matched electrical study: hardware/power_study/lm2596. Physical startup, fault and thermal tests remain required. BENCH TEST PADS - BACK SIDE B.Cu - COPPER ONLY, DO NOT POPULATE

UART EXTENSION - J10 - 3.3 V LOGIC, NOT RS232 VOLTAGE LEVELS

1 GND / 2 TX_A -> RX_B / 3 RX_A <- TX_B. Straight cable; no supply rail. B temperature: contacts 2 and 3 intentionally NC; connector fitted for interface compatibility. Reserved extension; future B must implement its UART peripheral/transceiver. No hot-plug.

PROTOTYPE - ENGINEERING PREPARED - ASSEMBLER APPROVAL REQUIRED
Laboratory hardware platform
Sheet: /
File: pcb_b_temperature.kicad_sch
Title: PCB B - Temperature / 24 V 100 W

Size: User | Rev: 0.5.3
KiCad E.D.A. 10.0.6 | Id: 1/1
