gcharvin/esp32_temperature_controller_platformio/hardware/review/pcb_a_placement_native.pdf

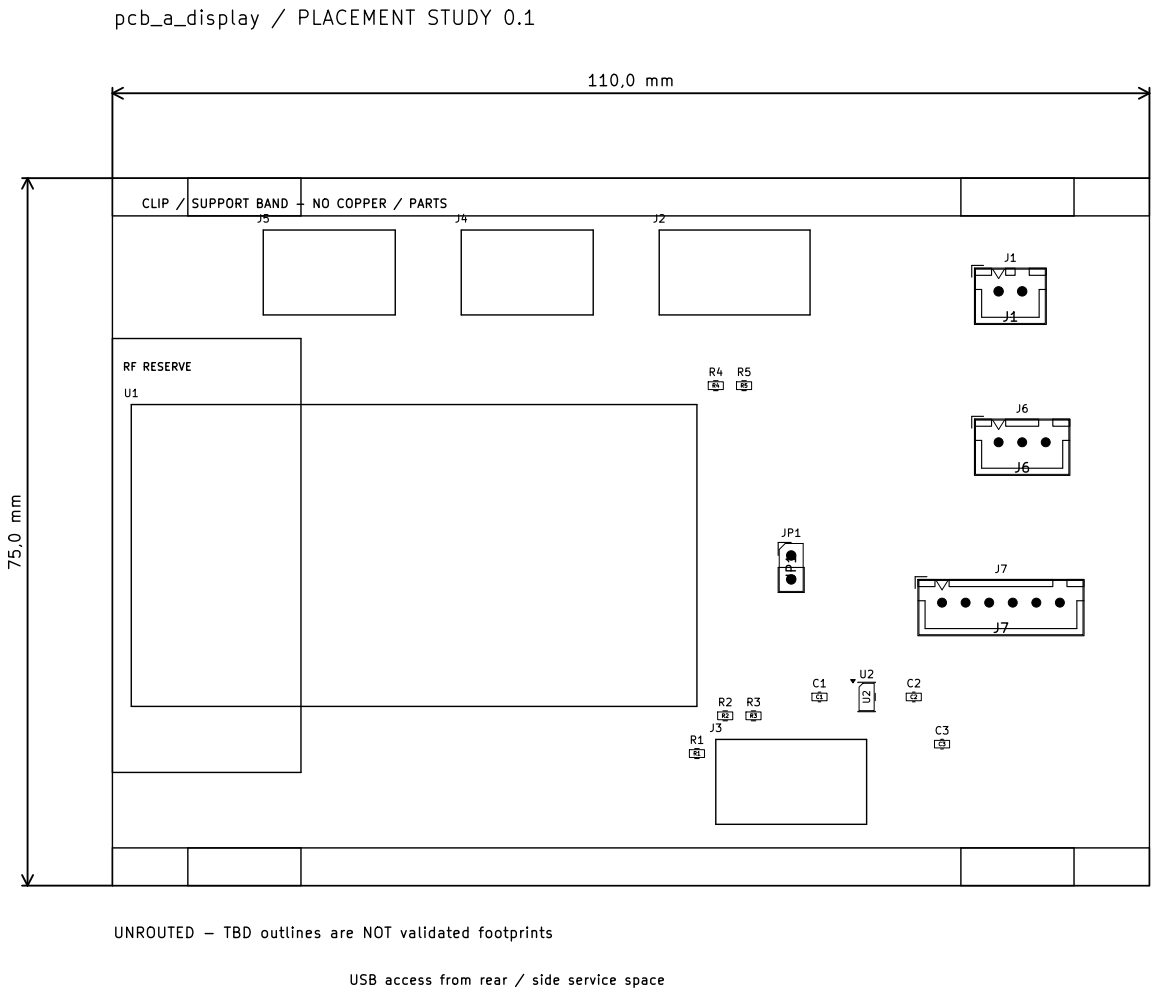
[picture p61: page 1]

UNROUTED - TBD outlines are NOT validated footprints
