gcharvin/esp32_temperature_controller_platformio/hardware/manufacturing/jlcpcb/support/schematic_A.pdf

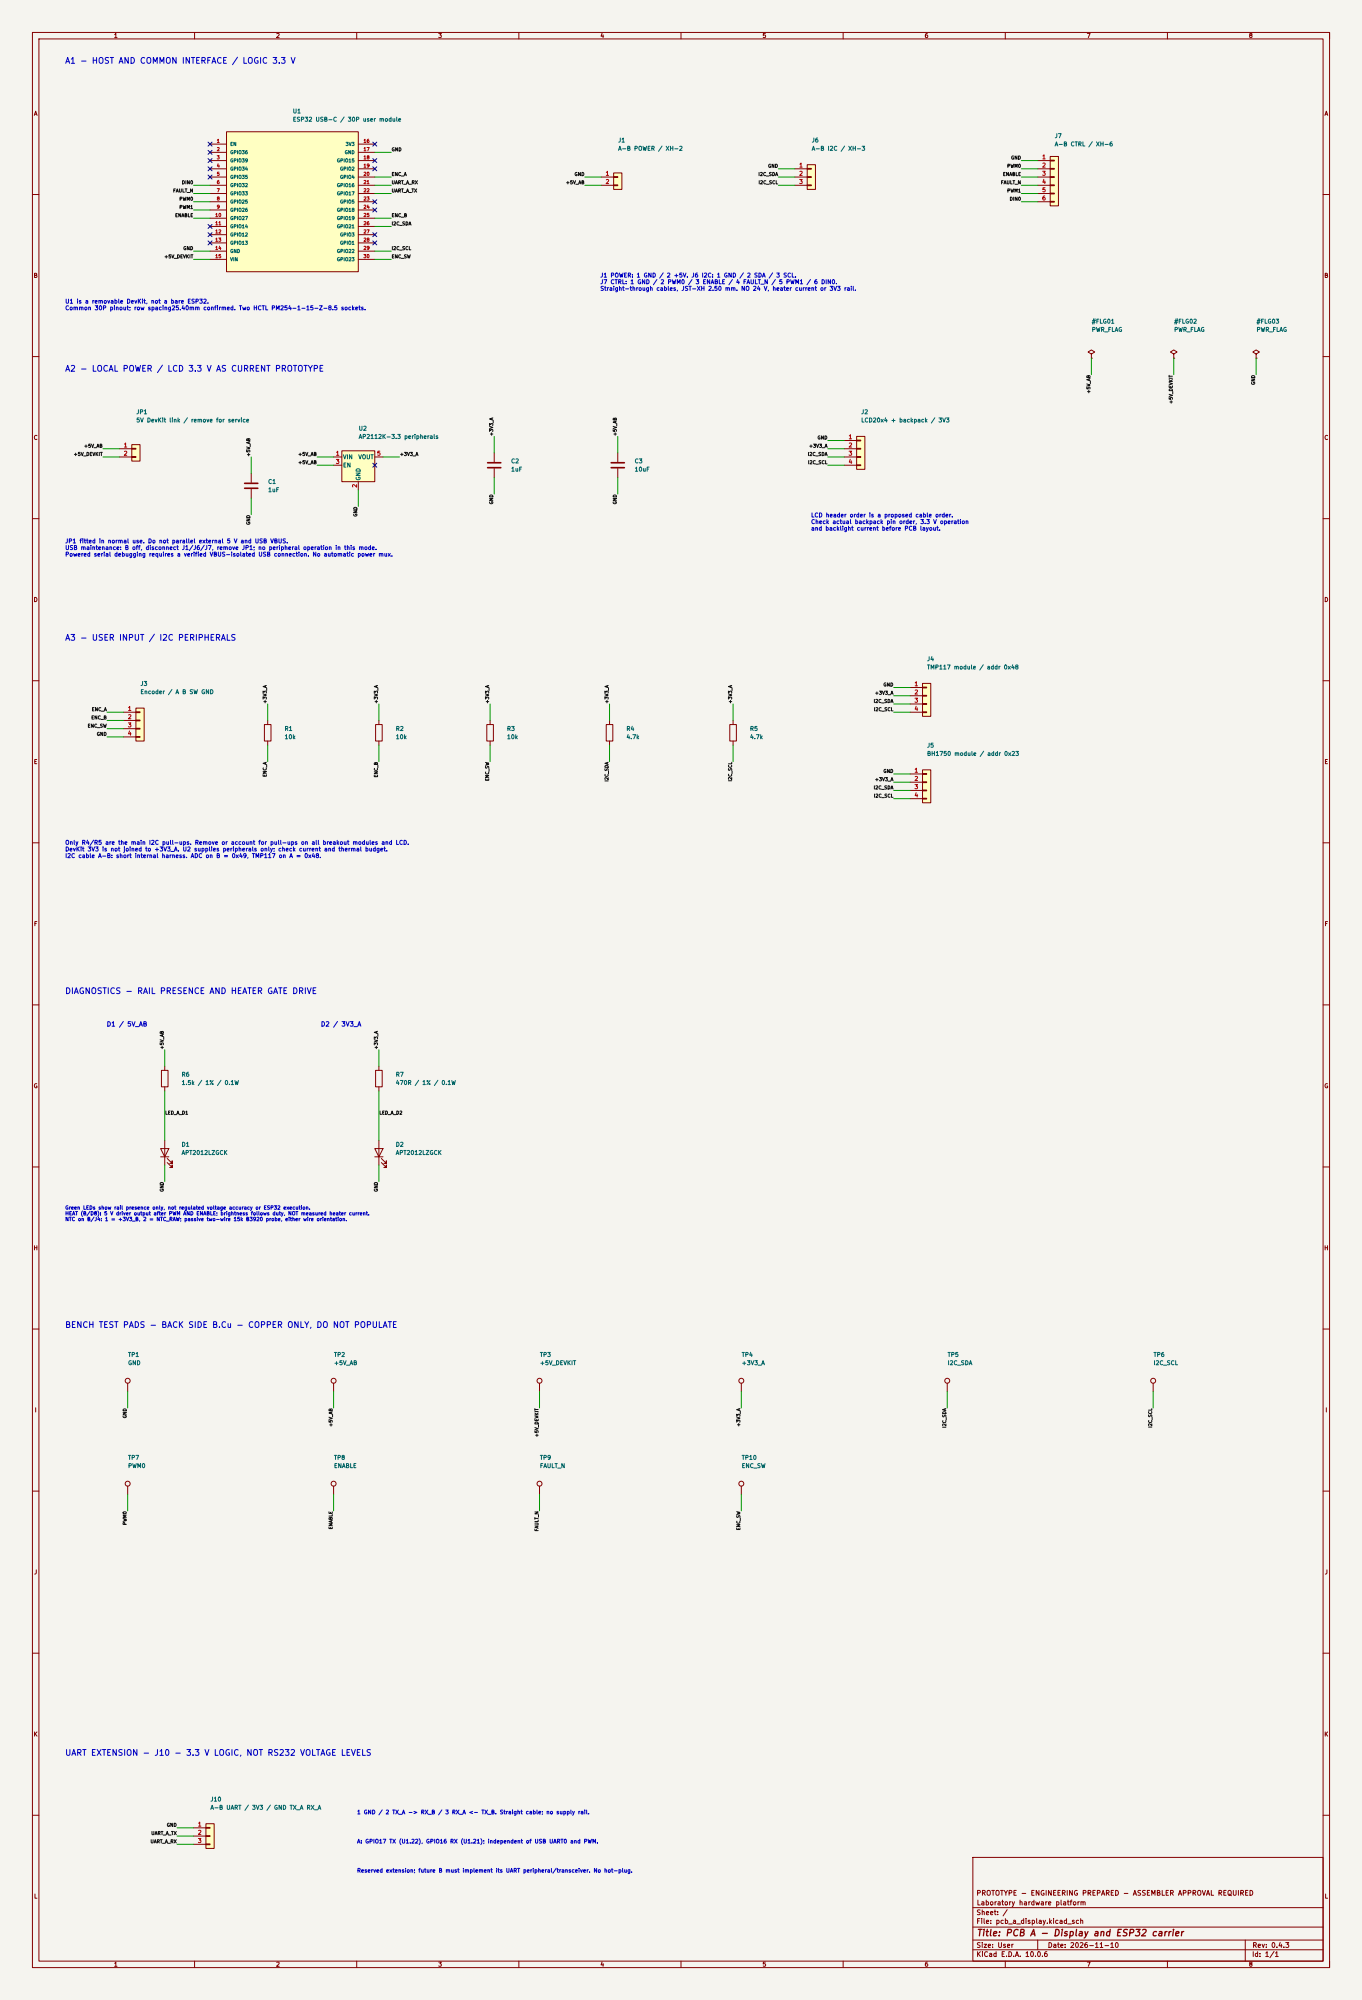
[picture p62: page 1]

A1 - HOST AND COMMON INTERFACE / LOGIC 3.3 V

A2 - LOCAL POWER / LCD 3.3 V AS CURRENT PROTOTYPE

5V DevKit link / remove for service

and backlight current before PCB layout.

DIAGNOSTICS - RAIL PRESENCE AND HEATER GATE DRIVE

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

BENCH TEST PADS - BACK SIDE B.Cu - COPPER ONLY, DO NOT POPULATE

UART EXTENSION - J10 - 3.3 V LOGIC, NOT RS232 VOLTAGE LEVELS

Reserved extension; future B must implement its UART peripheral/transceiver. No hot-plug. 1 GND / 2 TX_A -> RX_B / 3 RX_A <- TX_B. Straight cable; no supply rail. A: GPIO17 TX (U1.22), GPIO16 RX (U1.21); independent of USB UART0 and PWM.

PROTOTYPE - ENGINEERING PREPARED - ASSEMBLER APPROVAL REQUIRED
Laboratory hardware platform
Sheet: /
File: pcb_a_display.kicad_sch
Title: PCB A - Display and ESP32 carrier

Size: User | Rev: 0.4.3
KiCad E.D.A. 10.0.6 | Id: 1/1
