gcharvin/esp32_temperature_controller_platformio/hardware/power_study/kicad_simulation/disable/lm2596_5v_disable.pdf

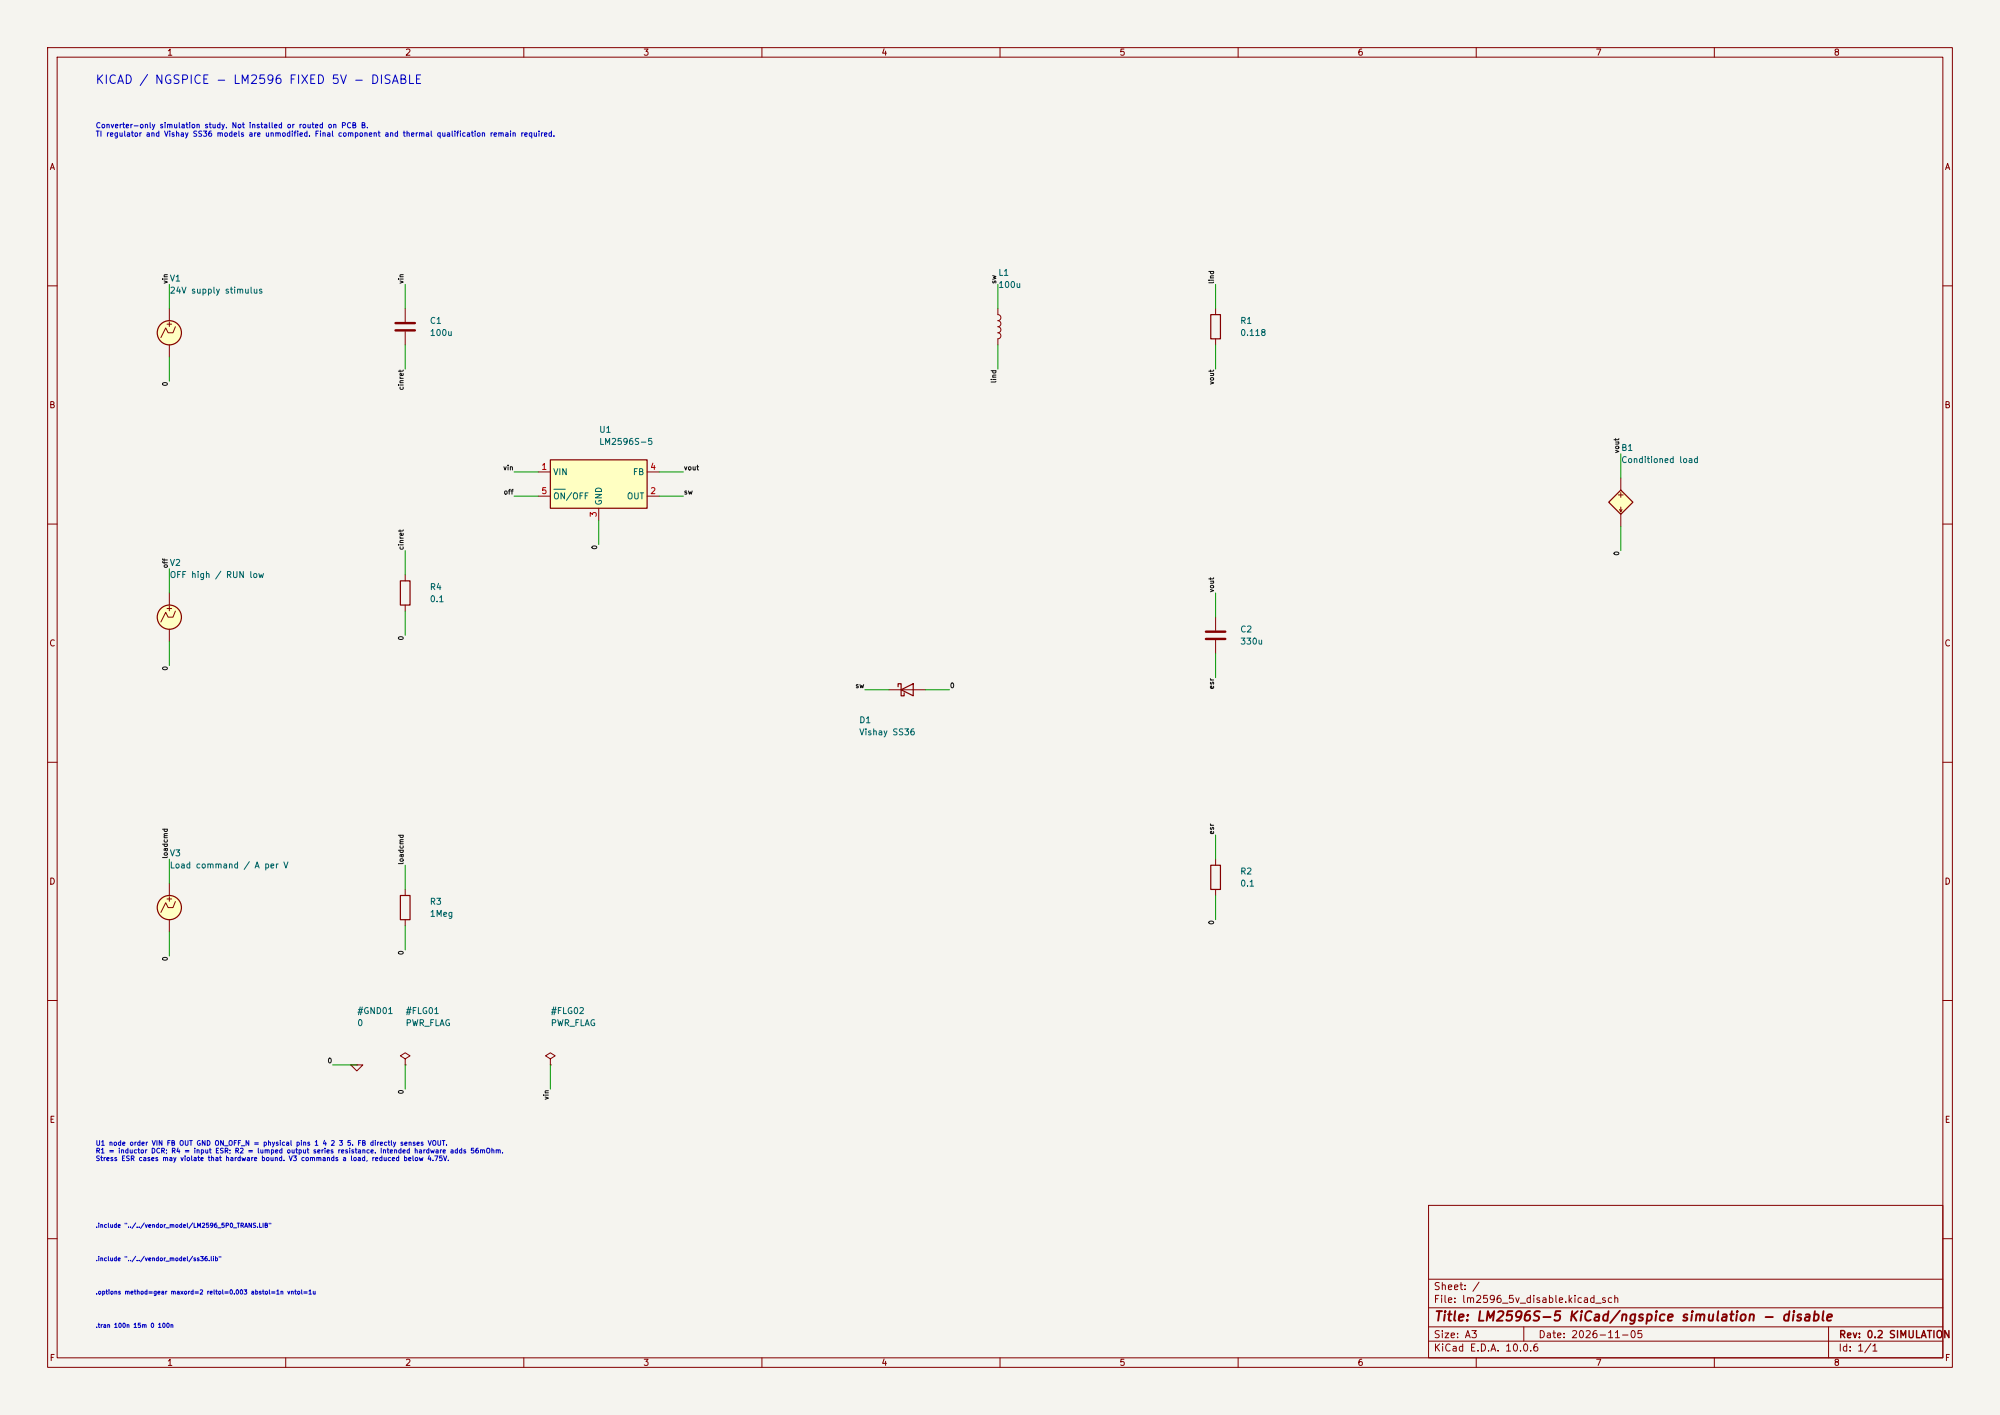
[picture p63: page 1]

KICAD / NGSPICE - LM2596 FIXED 5V - DISABLE

Converter-only simulation study. Not installed or routed on PCB B. TI regulator and Vishay SS36 models are unmodified. Final component and thermal qualification remain required.

0 0 vin loadcmd off cinret sw lind vin lind
24V supply stimulus

.options method=gear maxord=2 reltol=0.003 abstol=1n vntol=1u U1 node order VIN FB OUT GND ON_OFF_N = physical pins 1 4 2 3 5. FB directly senses VOUT. R1 = inductor DCR; R4 = input ESR; R2 = lumped output series resistance. Intended hardware adds 56mOhm. Stress ESR cases may violate that hardware bound. V3 commands a load, reduced below 4.75V.

Sheet: /
File: lm2596_5v_disable.kicad_sch
Title: LM2596S-5 KiCad/ngspice simulation - disable

F Date: 2026-11-05

KiCad E.D.A. 10.0.6 | Id: 1/1
