gcharvin/esp32_temperature_controller_platformio/hardware/review/pcb_b_placement_native.pdf

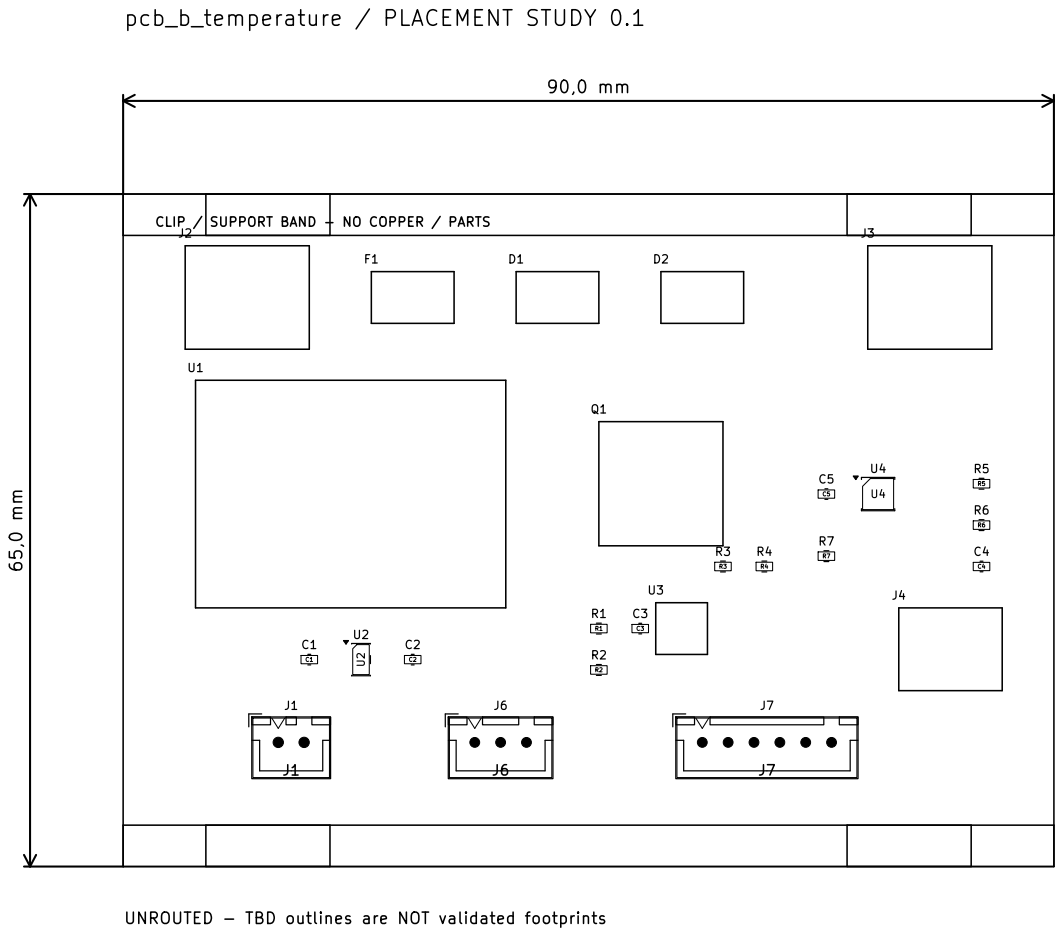
[picture p64: page 1]
