gcharvin/esp32_temperature_controller_platformio/hardware/review/routing/pcb_a_display_routed.pdf

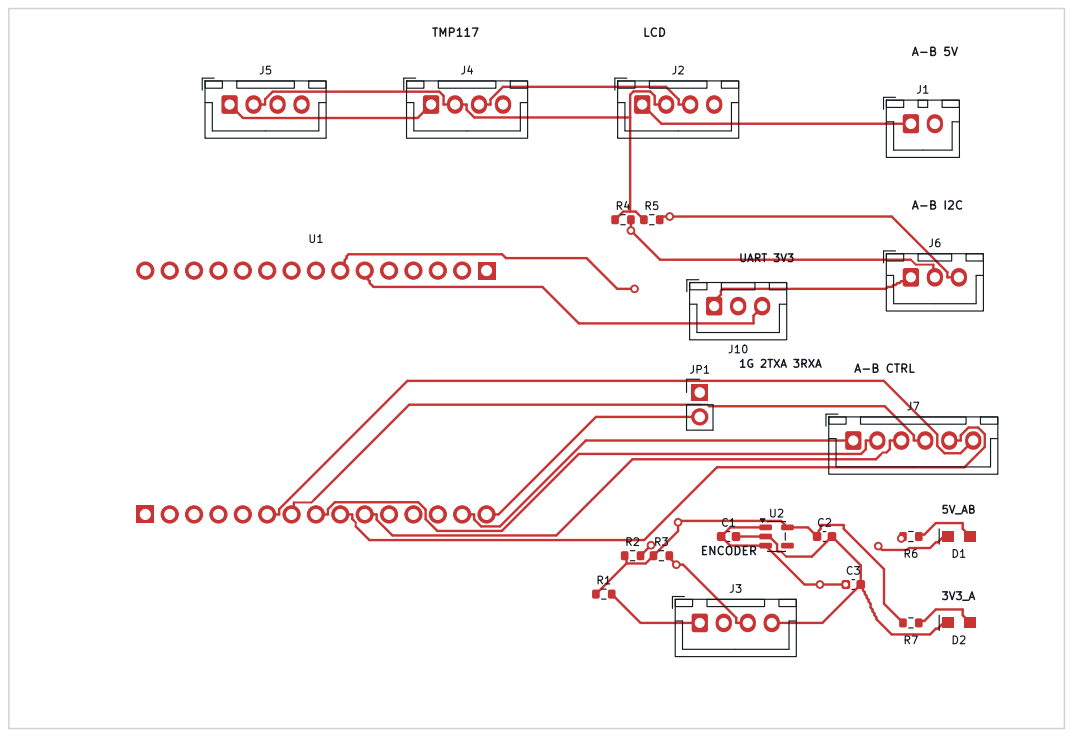
[picture p65: page 1]

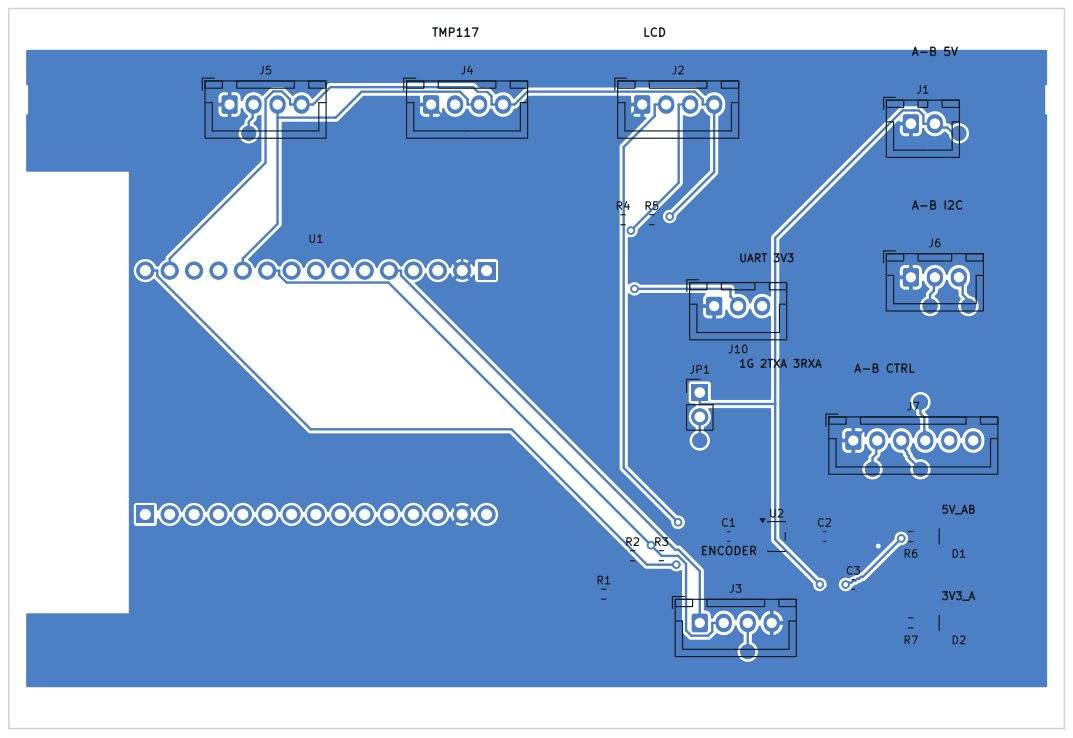
[picture p66: page 2]
