gcharvin/esp32_temperature_controller_platformio/hardware/review/routing/pcb_b_temperature_routed.pdf

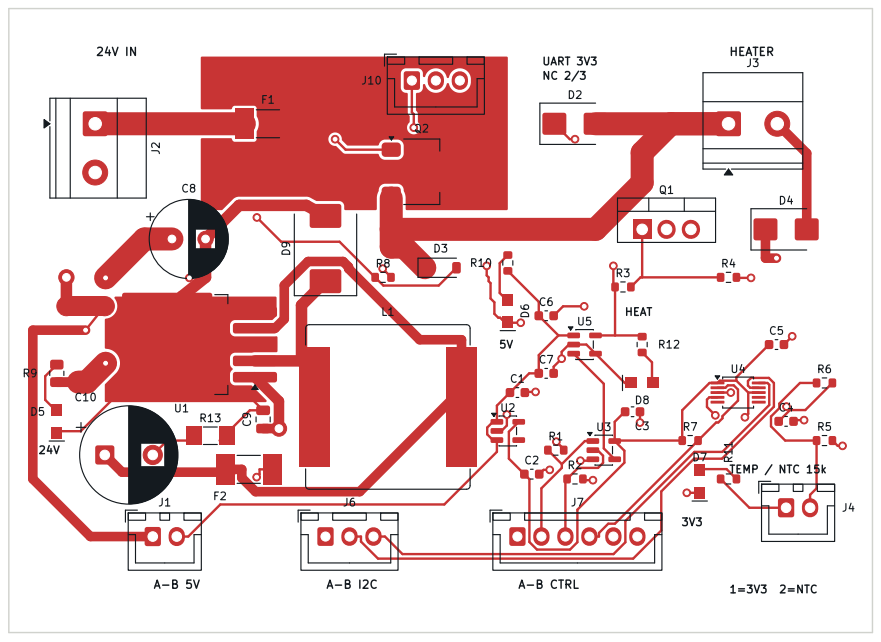
[picture p67: page 1]

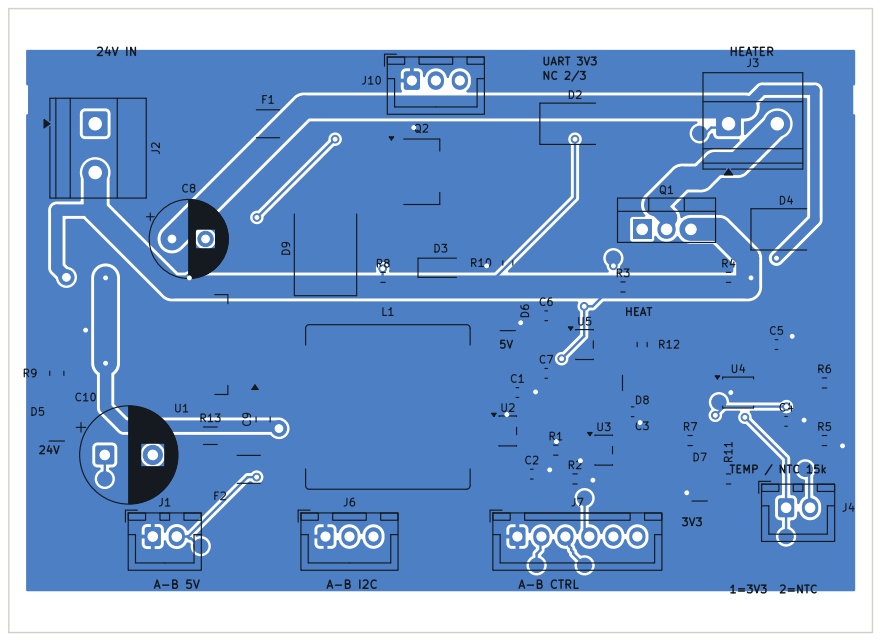
[picture p68: page 2]
