gcharvin/esp32_temperature_controller_platformio/(list of files, drawings)

Other design files:
hardware/manufacturing/lcsc_cable_rfq/pcb_pin_extract.json
hardware/review/pcb_a_placement_drc.json
hardware/review/pcb_b_placement_drc.json
hardware/review/routing/pcb_a_display_drc.json
hardware/review/routing/pcb_b_temperature_drc.json
