gcharvin/esp32_temperature_controller_platformio/hardware/pcb_b_temperature/pcb_b_temperature.kicad_pcb

## KiCad design hardware/pcb_b_temperature/pcb_b_temperature.kicad_pcb (2026-11-10)

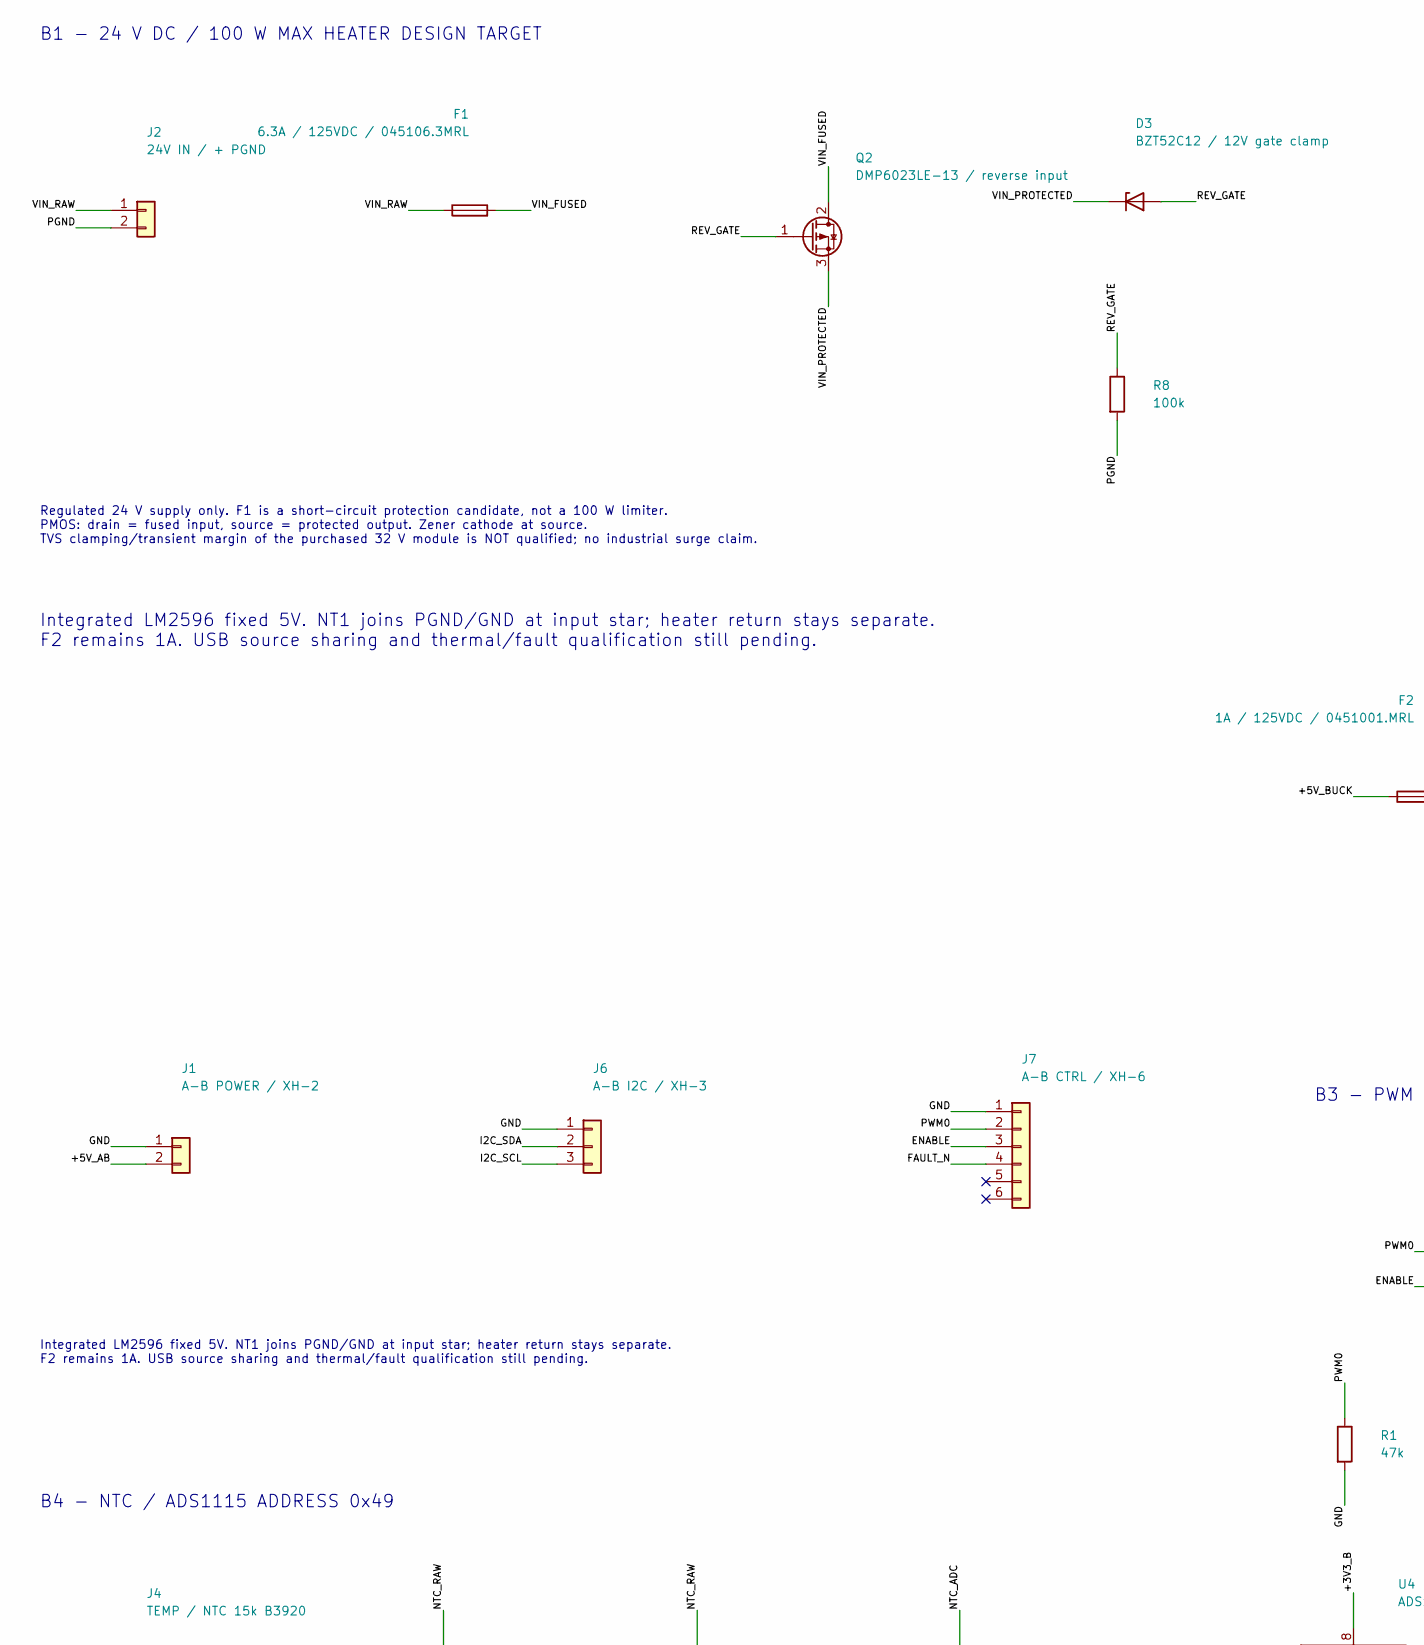
[picture p69: schematic pcb_b_temperature.kicad_sch, PCB B - Temperature / 24 V 100 W, part in row 1, column 1]

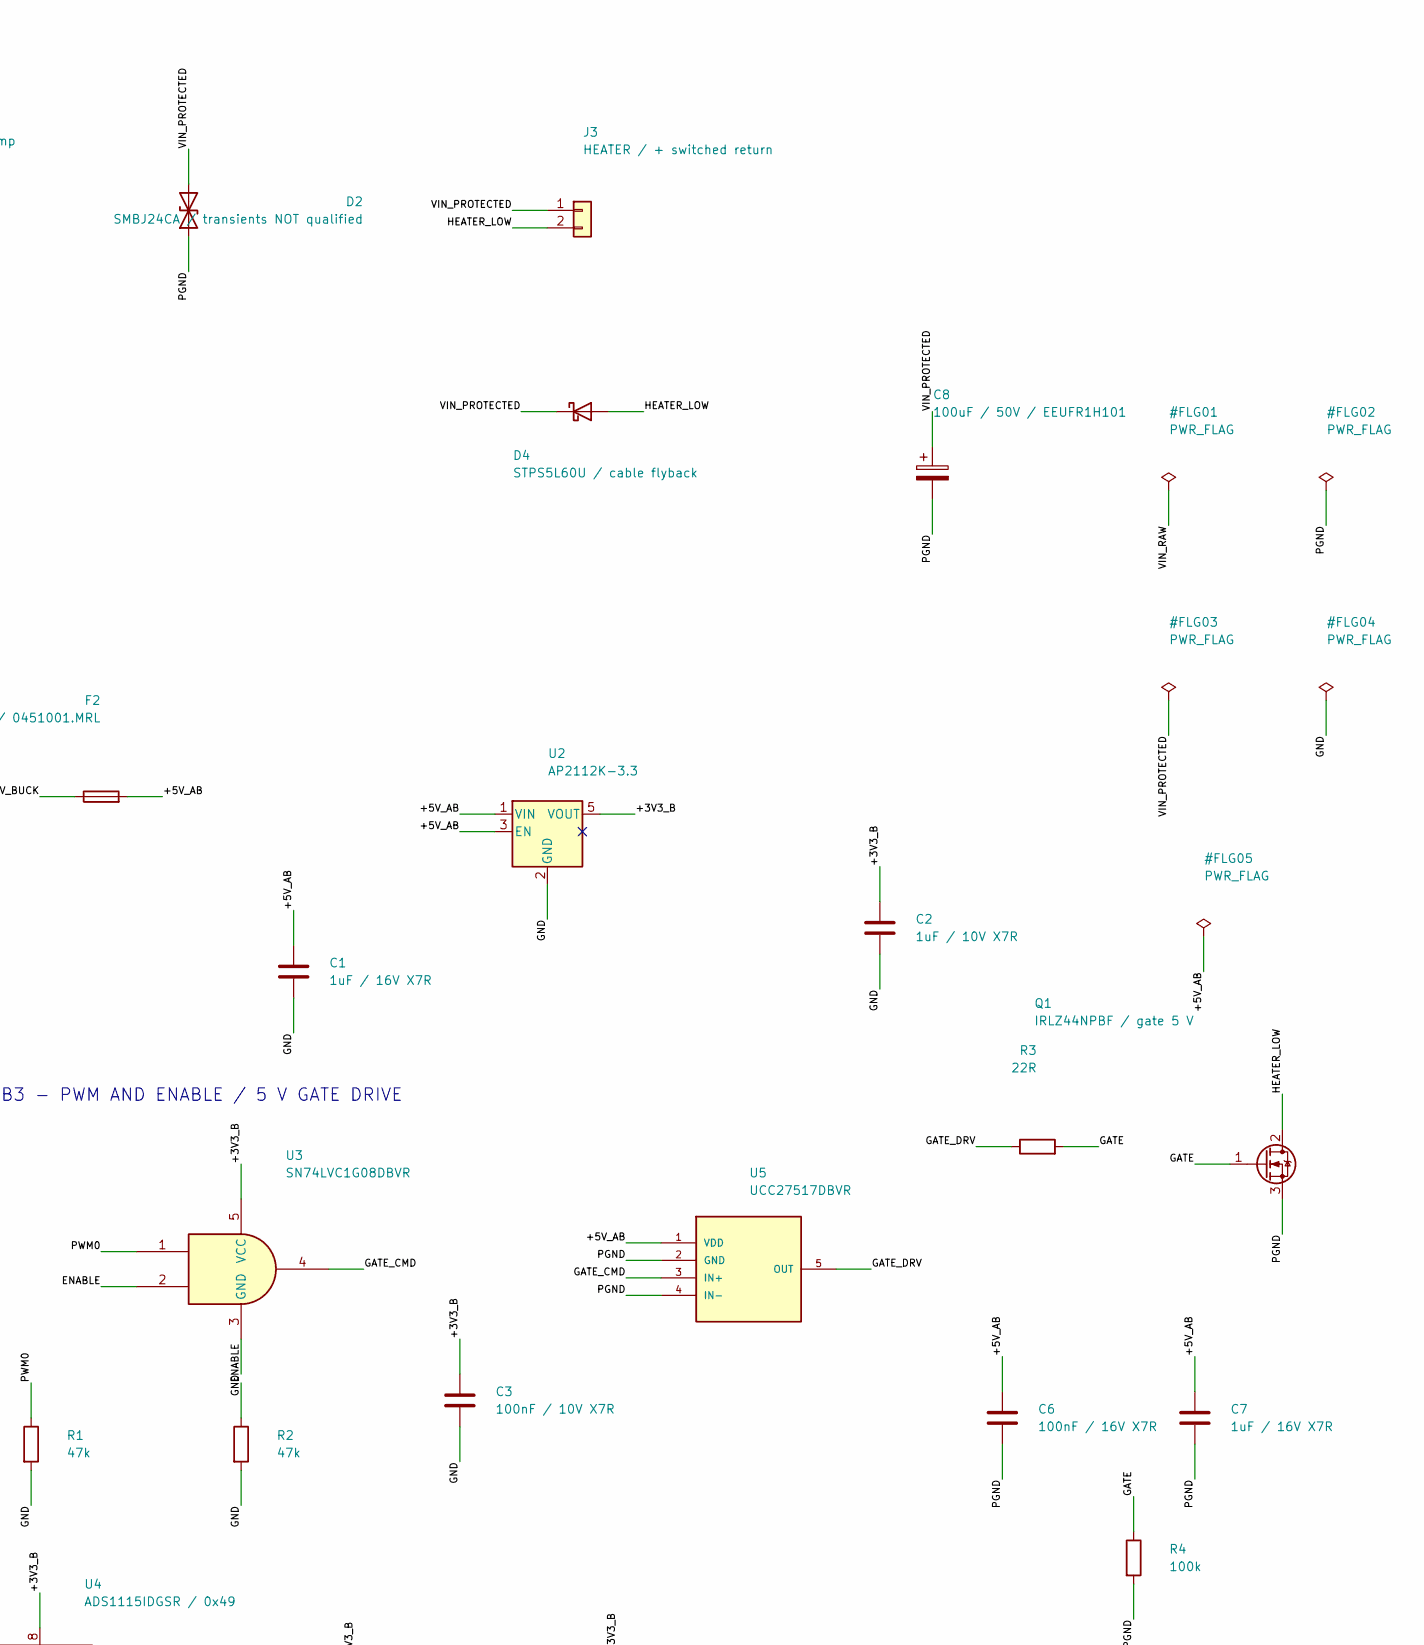
[picture p70: schematic pcb_b_temperature.kicad_sch, PCB B - Temperature / 24 V 100 W, part in row 1, column 2]

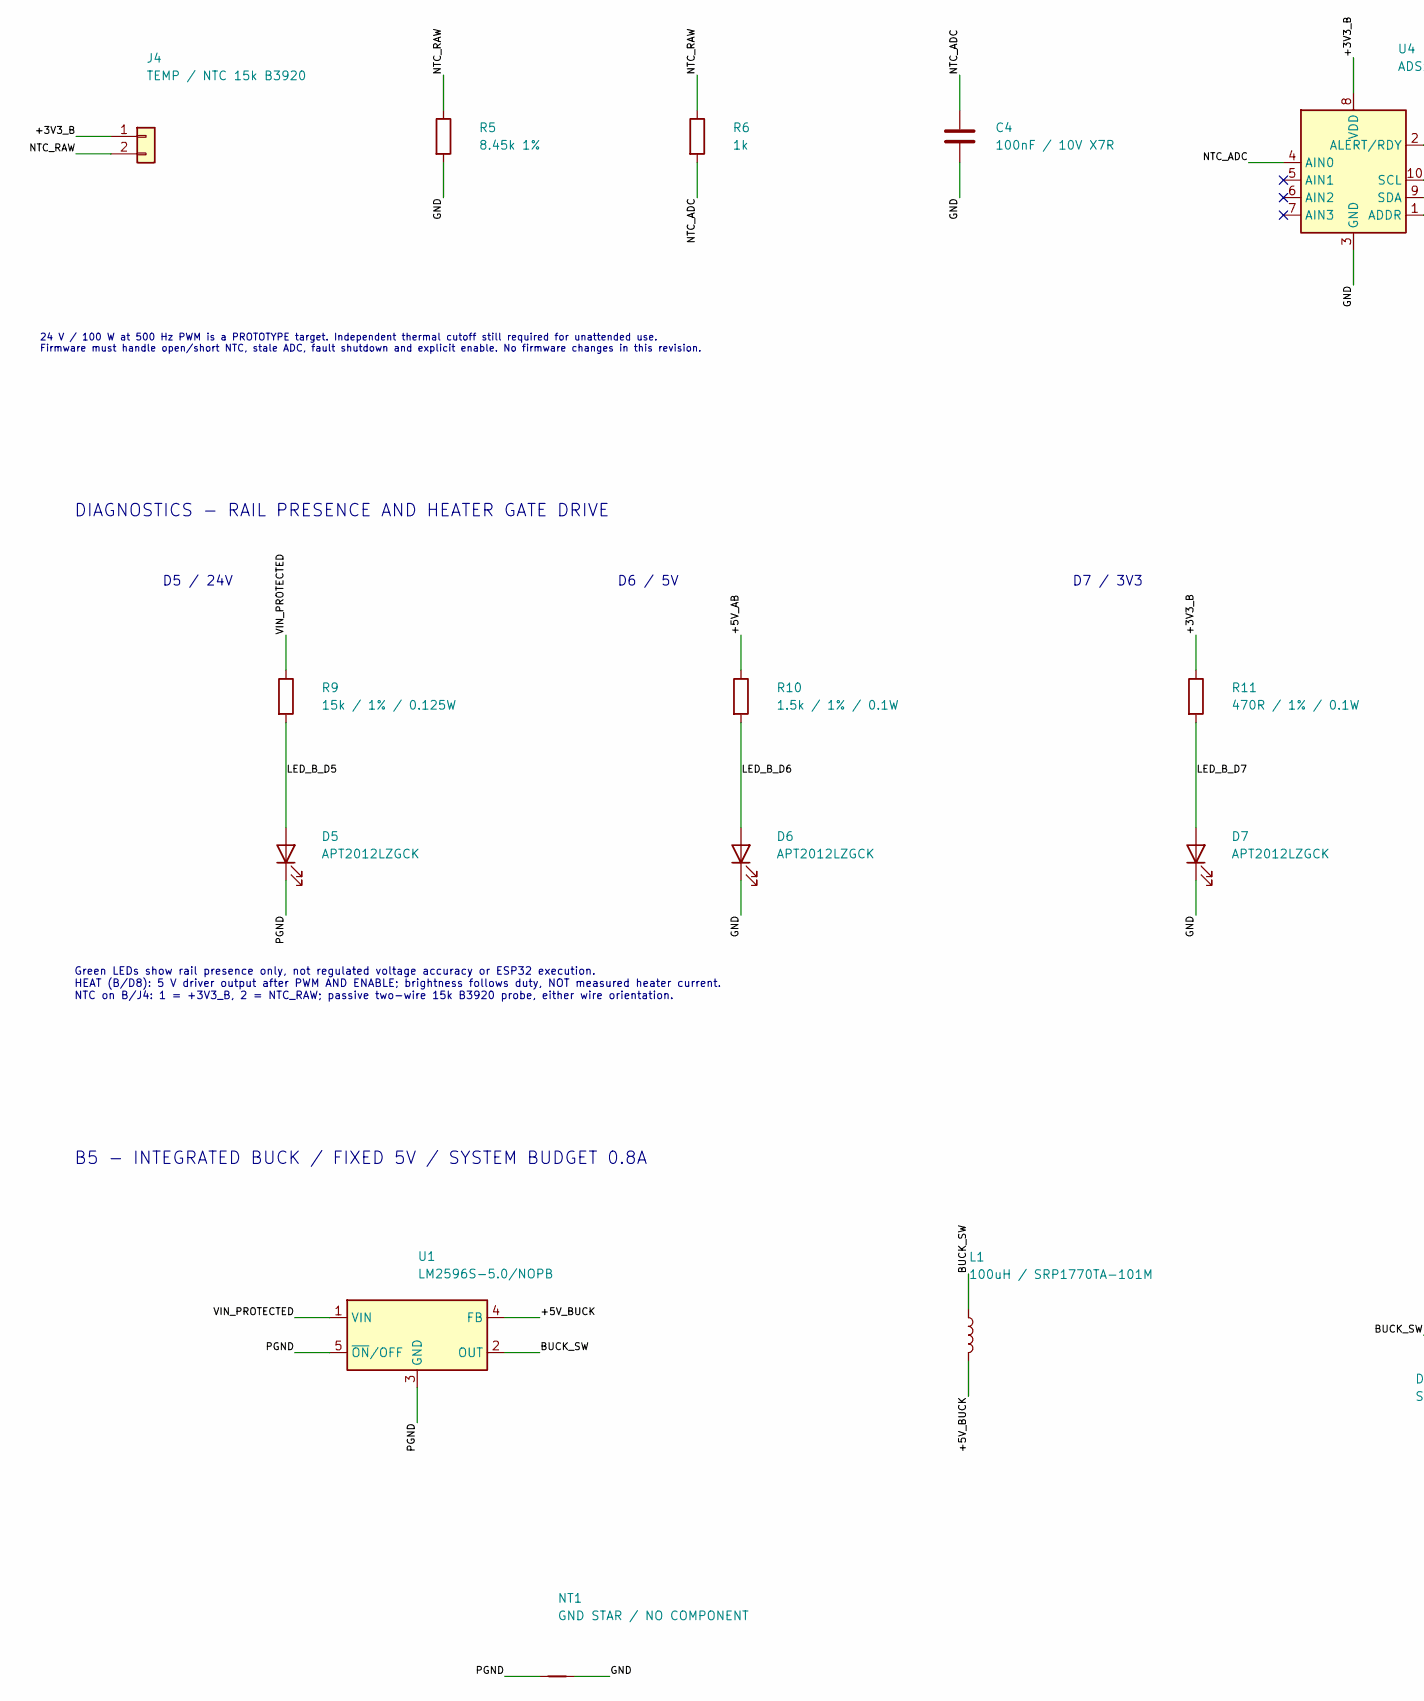
[picture p71: schematic pcb_b_temperature.kicad_sch, PCB B - Temperature / 24 V 100 W, part in row 2, column 1]

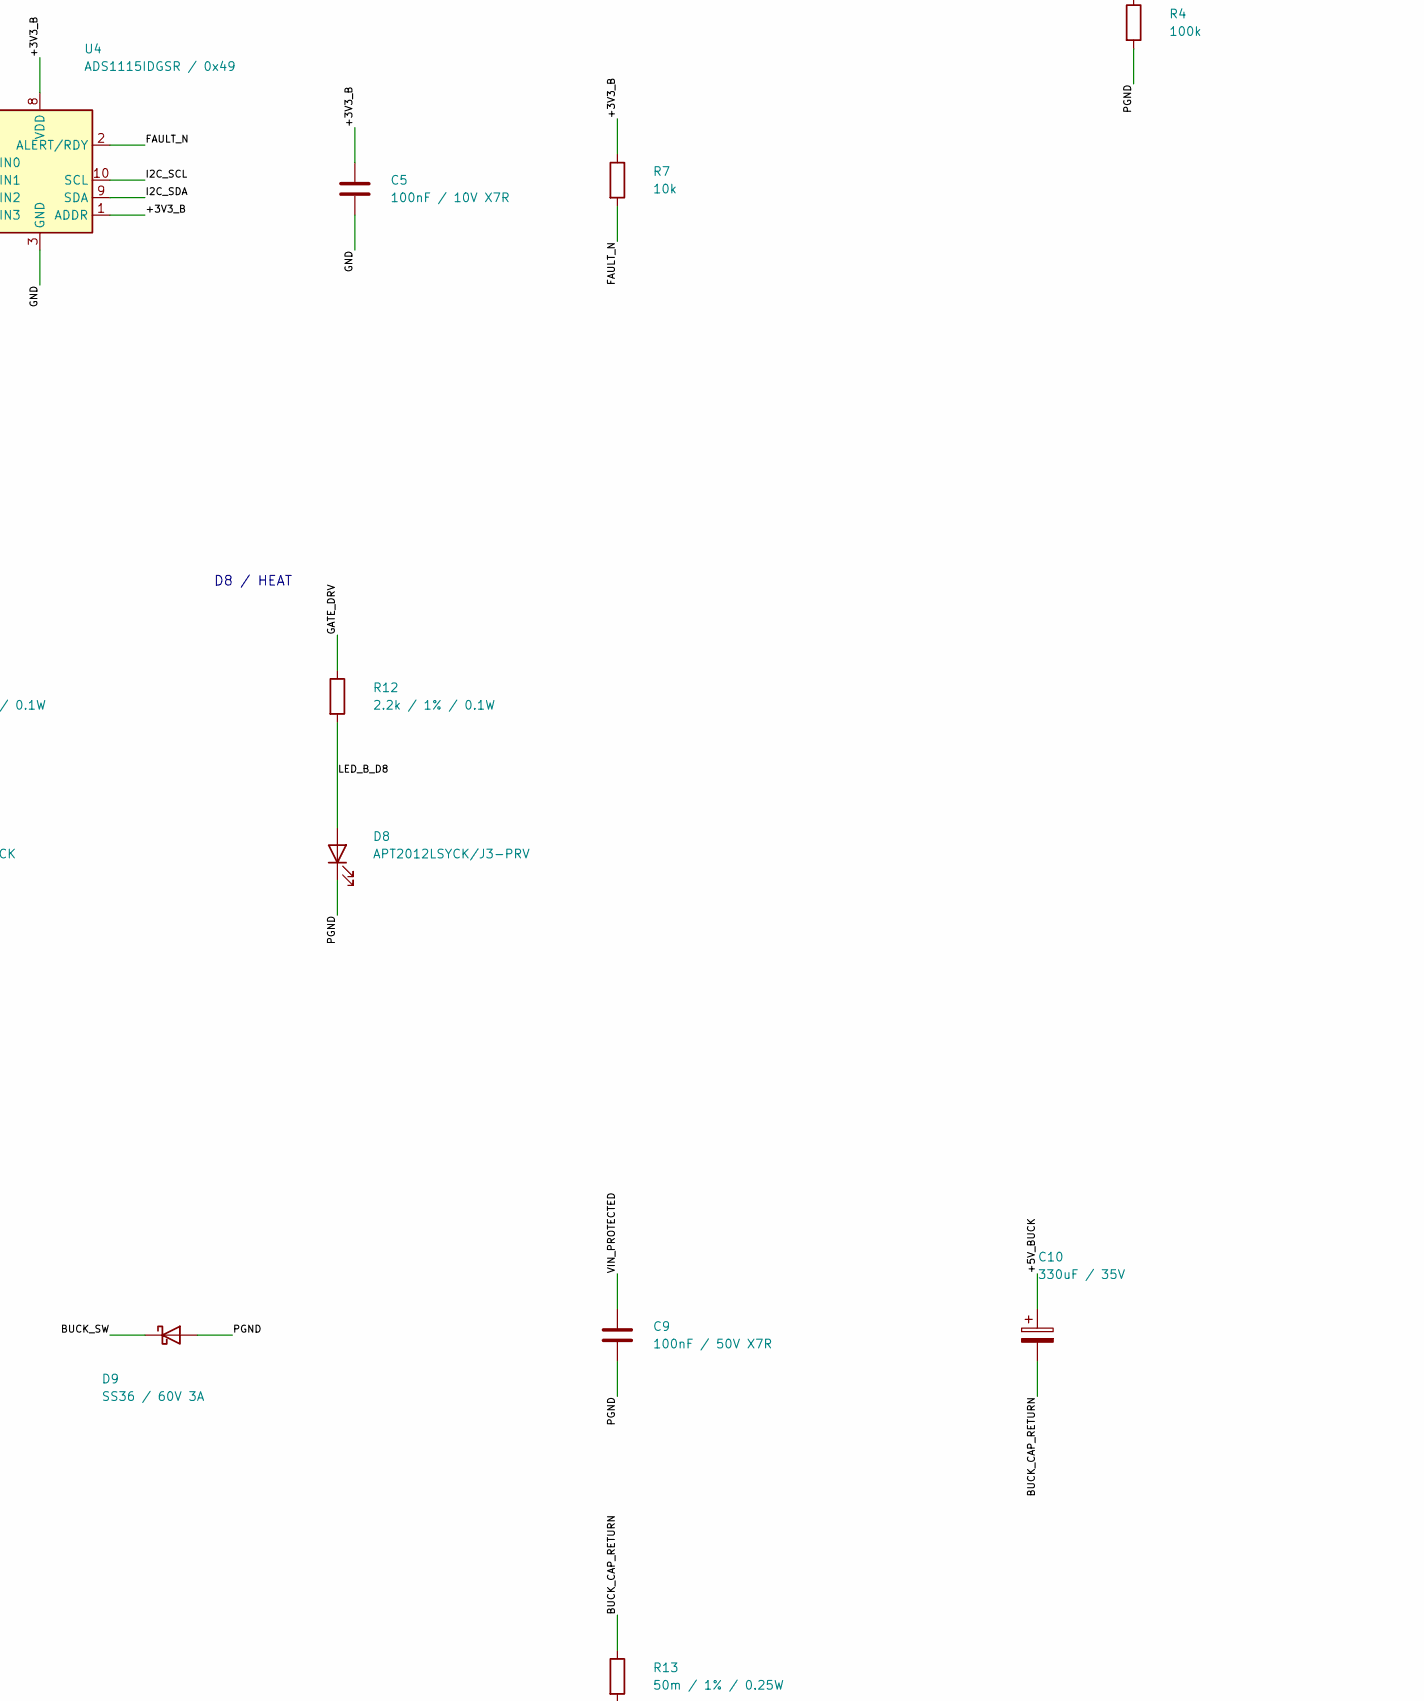
[picture p72: schematic pcb_b_temperature.kicad_sch, PCB B - Temperature / 24 V 100 W, part in row 2, column 2]

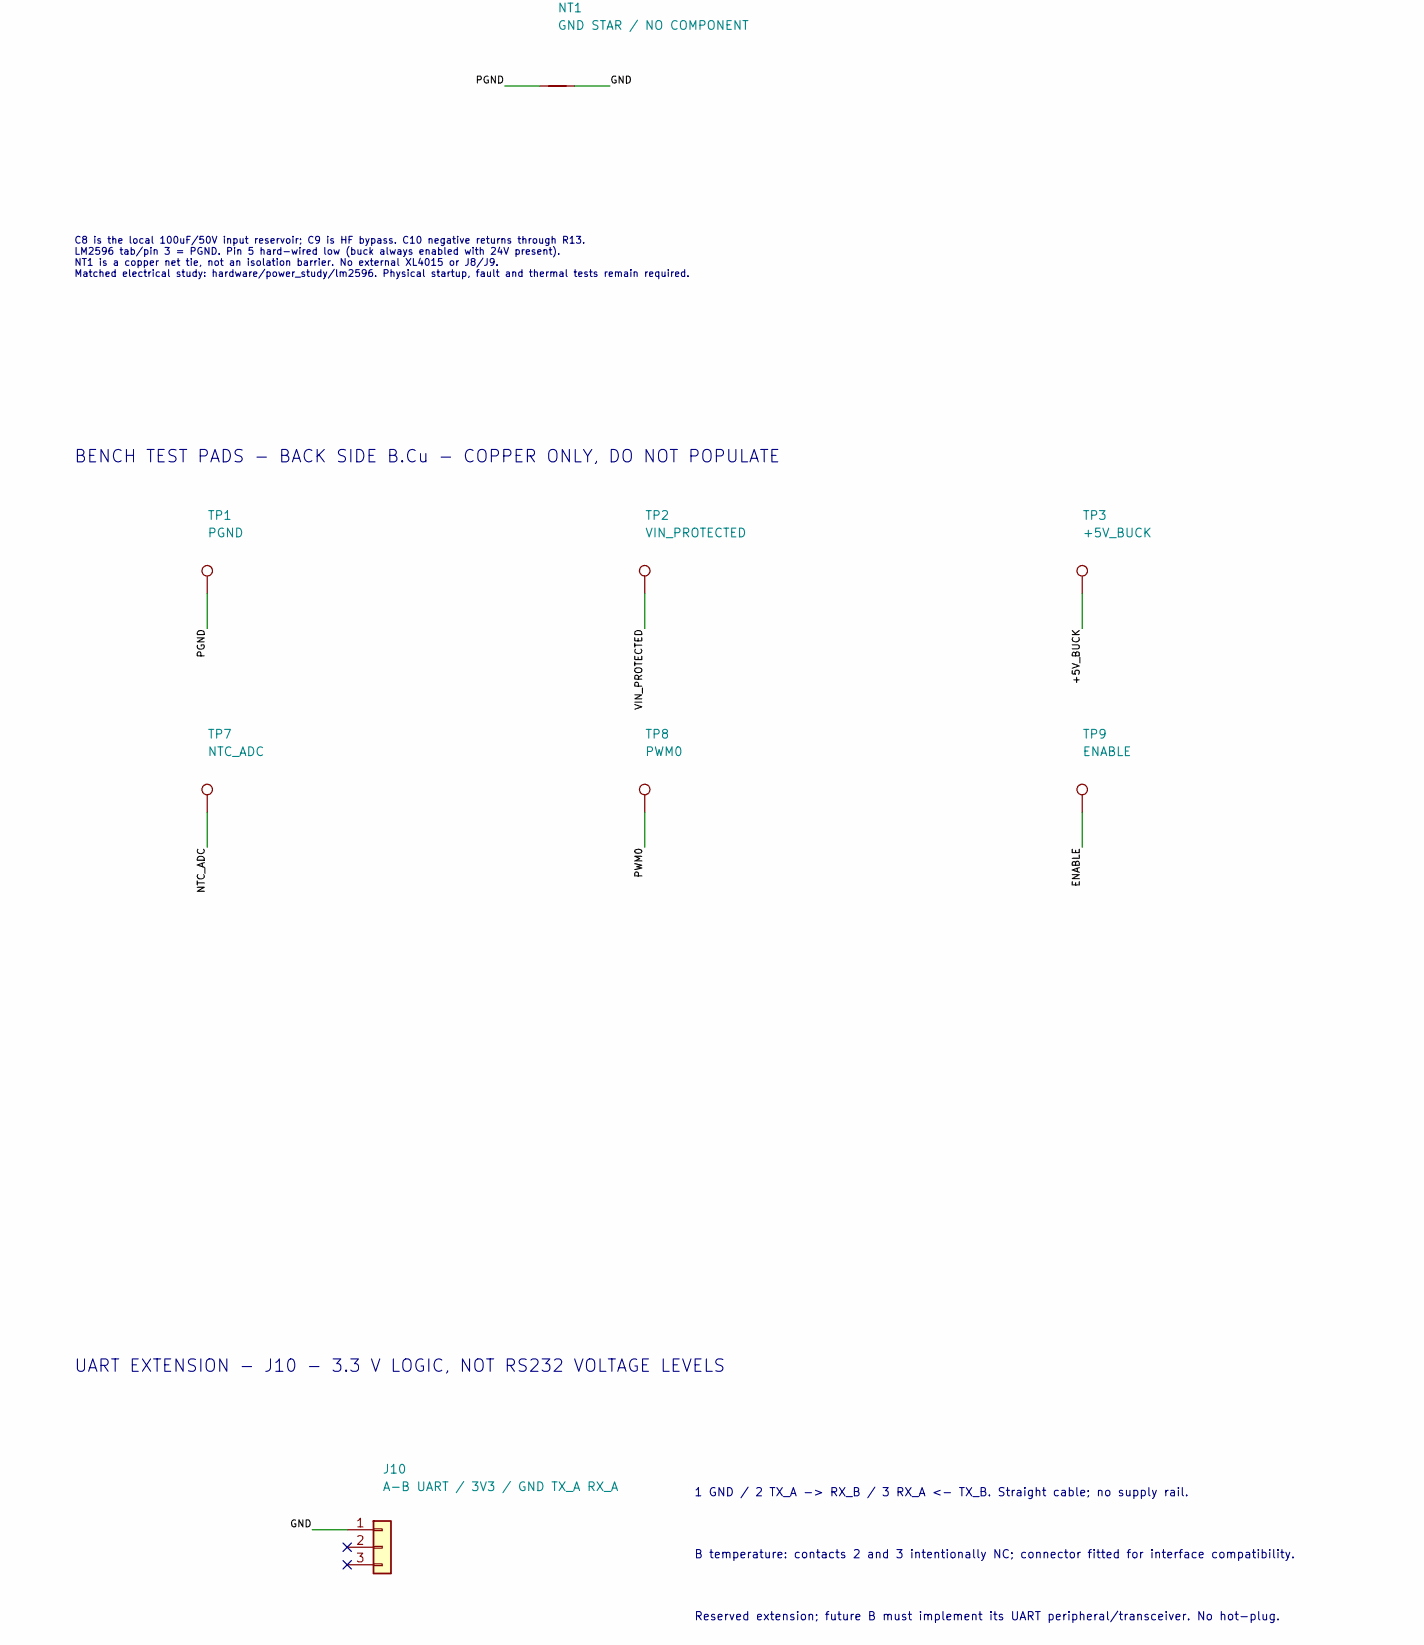
[picture p73: schematic pcb_b_temperature.kicad_sch, PCB B - Temperature / 24 V 100 W, part in row 3, column 1]

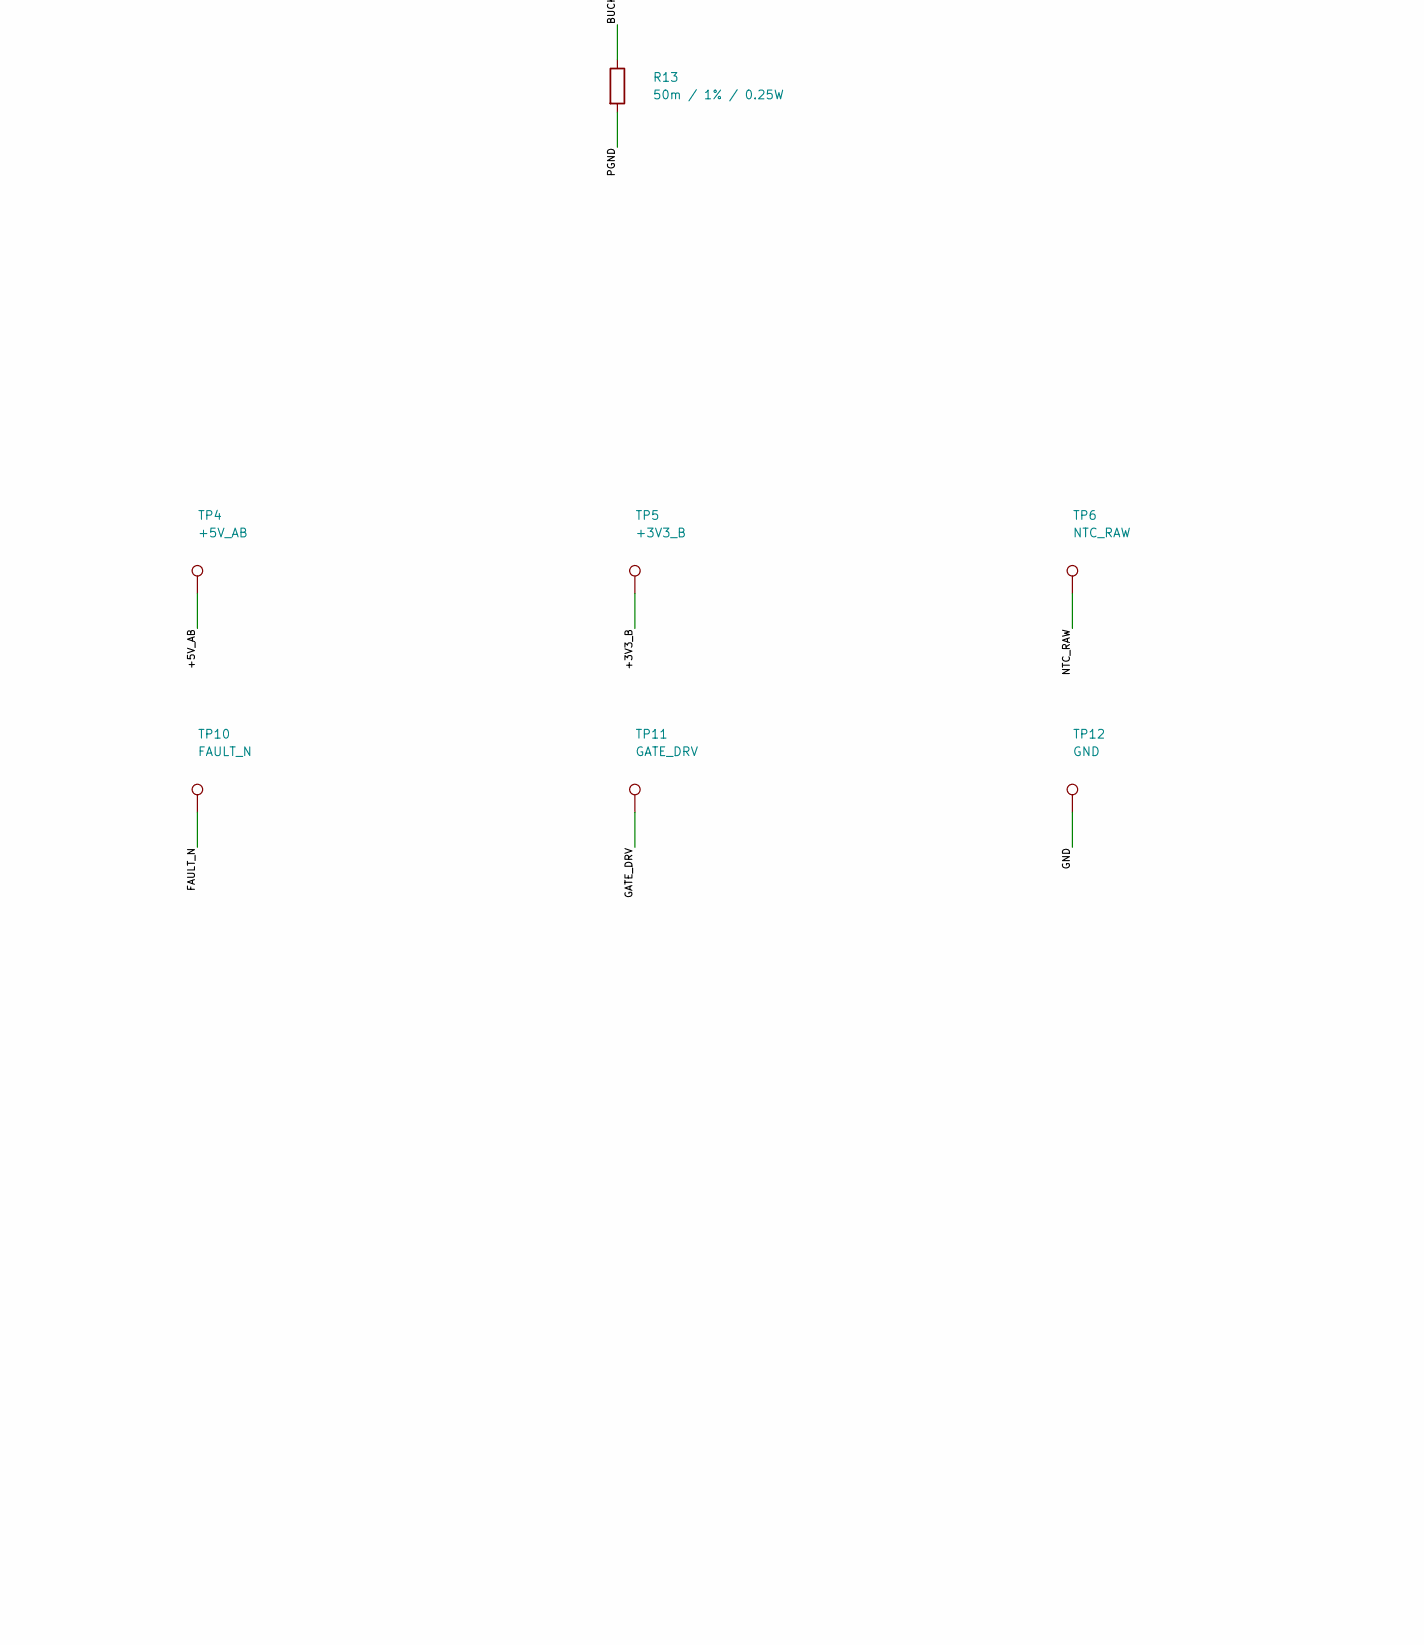
[picture p74: schematic pcb_b_temperature.kicad_sch, PCB B - Temperature / 24 V 100 W, part in row 3, column 2]

Parts:
C1, C7: 1uF / 16V X7R; C_0603_1608Metric; MPN 0603B105K160CT
C2: 1uF / 10V X7R; C_0603_1608Metric; MPN 0603B105K160CT
C3, C4, C5: 100nF / 10V X7R; C_0603_1608Metric; MPN C0603C104K4RACTU
C6: 100nF / 16V X7R; C_0603_1608Metric; MPN C0603C104K4RACTU
C8: 100uF / 50V / EEUFR1H101; CP_Radial_D8.0mm_P3.50mm; MPN EEUFR1H101
C9: 100nF / 50V X7R; C_0805_2012Metric; MPN C0805C104K5RACTU
C10: 330uF / 35V; CP_Radial_EEUFS1V331LB_P5_D10_Keepout; MPN EEUFS1V331LB
D2: SMBJ24CA / transients NOT qualified; D_SMB; MPN SMBJ24CA
D3: BZT52C12 / 12V gate clamp; D_SOD-123; MPN BZT52C12-7-F
D4: STPS5L60U / cable flyback; D_SMB; MPN STPS5L60U
D5, D6, D7: APT2012LZGCK; LED_Kingbright_APT2012_Manufacturer; MPN APT2012LZGCK
D8: APT2012LSYCK/J3-PRV; LED_Kingbright_APT2012_Manufacturer; MPN APT2012LSYCK/J3-PRV
D9: SS36 / 60V 3A; D_SMC; MPN SS36-E3/57T
F1: 6.3A / 125VDC / 045106.3MRL; Fuse_Littelfuse-NANO2-451_453; MPN 045106.3MRL
F2: 1A / 125VDC / 0451001.MRL; Fuse_Littelfuse-NANO2-451_453; MPN 0451001.MRL
J1: A-B POWER / XH-2; JST_XH_B2B-XH-A_1x02_P2.50mm_Vertical; MPN B2B-XH-A(LF)(SN)
J2: 24V IN / + PGND; TerminalBlock_Phoenix_MKDS-1,5-2-5.08_1x02_P5.08mm_Horizont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; MPN 1715721
J3: HEATER / + switched return; TerminalBlock_Phoenix_MKDS-1,5-2-5.08_1x02_P5.08mm_Horizont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; MPN 1715721
J4: TEMP / NTC 15k B3920; JST_XH_B2B-XH-A_1x02_P2.50mm_Vertical; MPN B2B-XH-A(LF)(SN)
J6: A-B I2C / XH-3; JST_XH_B3B-XH-A_1x03_P2.50mm_Vertical; MPN B3B-XH-A(LF)(SN)
J7: A-B CTRL / XH-6; JST_XH_B6B-XH-A_1x06_P2.50mm_Vertical; MPN B6B-XH-A(LF)(SN)
J10: A-B UART / 3V3 / GND TX_A RX_A; JST_XH_B3B-XH-A_1x03_P2.50mm_Vertical; MPN B3B-XH-A(LF)(SN)
L1: 100uH / SRP1770TA-101M; L_Bourns_SRP1770TA_16.9x16.9mm; MPN SRP1770TA-101M
NT1: GND STAR / NO COMPONENT; NetTie-2_SMD_Pad2.0mm
Q1: IRLZ44NPBF / gate 5 V; TO-220-3_Vertical; MPN IRLZ44NPBF
Q2: DMP6023LE-13 / reverse input; SOT-223-3_TabPin2; MPN DMP6023LE-13
R1, R2: 47k; R_0603_1608Metric; MPN RC0603FR-0747KL
R3: 22R; R_0603_1608Metric; MPN RC0603FR-0722RL
R4, R8: 100k; R_0603_1608Metric; MPN RC0603FR-07100KL
R5: 8.45k 1%; R_0603_1608Metric; MPN RC0603FR-078K45L
R6: 1k; R_0603_1608Metric; MPN RC0603FR-071KL
R7: 10k; R_0603_1608Metric; MPN RC0603FR-0710KL
R9: 15k / 1% / 0.125W; R_0805_2012Metric; MPN RC0805FR-0715KL
R10: 1.5k / 1% / 0.1W; R_0603_1608Metric; MPN RC0603FR-071K5L
R11: 470R / 1% / 0.1W; R_0603_1608Metric; MPN RC0603FR-07470RL
R12: 2.2k / 1% / 0.1W; R_0603_1608Metric; MPN RC0603FR-072K2L
R13: 50m / 1% / 0.25W; Vishay_WSL1206_6m_to_200m; MPN WSL1206R0500FEA
TP1: PGND; ProbePad_D1.5mm_NoPaste
TP2: VIN_PROTECTED; ProbePad_D1.5mm_NoPaste
TP3: +5V_BUCK; ProbePad_D1.5mm_NoPaste
TP4: +5V_AB; ProbePad_D1.5mm_NoPaste
TP5: +3V3_B; ProbePad_D1.5mm_NoPaste
TP6: NTC_RAW; ProbePad_D1.5mm_NoPaste
TP7: NTC_ADC; ProbePad_D1.5mm_NoPaste
TP8: PWM0; ProbePad_D1.5mm_NoPaste
TP9: ENABLE; ProbePad_D1.5mm_NoPaste
TP10: FAULT_N; ProbePad_D1.5mm_NoPaste
TP11: GATE_DRV; ProbePad_D1.5mm_NoPaste
TP12: GND; ProbePad_D1.5mm_NoPaste
U1: LM2596S-5.0/NOPB; TO-263-5_TabPin3; MPN LM2596S-5.0/NOPB
U2: AP2112K-3.3; SOT-23-5; MPN AP2112K-3.3TRG1
U3: SN74LVC1G08DBVR; SOT-23-5; MPN SN74LVC1G08DBVR
U4: ADS1115IDGSR / 0x49; TSSOP-10_3x3mm_P0.5mm; MPN ADS1115IDGSR
U5: UCC27517DBVR; SOT-23-5; MPN UCC27517DBVR

Connections:
/+3V3_B: C2.1, C3.1, C5.1, J4.1, R7.1, R11.1, TP5.1, U2.5 (VOUT), U3.5 (VCC), U4.1 (ADDR), U4.8 (VDD)
/+5V_AB: C1.1, C6.1, C7.1, F2.2, J1.2, R10.1, TP4.1, U2.1 (VIN), U2.3 (EN), U5.1 (VDD)
/+5V_BUCK: C10.1, F2.1, L1.2, TP3.1, U1.4 (FB)
/BUCK_CAP_RETURN: C10.2, R13.1
/BUCK_SW: D9.1 (K), L1.1, U1.2 (OUT)
/ENABLE: J7.3, R2.1, TP9.1, U3.2
/FAULT_N: J7.4, R7.2, TP10.1, U4.2 (ALERT/RDY)
/GATE: Q1.1 (G), R3.2, R4.1
/GATE_CMD: U3.4, U5.3 (IN+)
/GATE_DRV: R3.1, R12.1, TP11.1, U5.5 (OUT)
/GND: C1.2, C2.2, C3.2, C4.2, C5.2, D6.1 (K), D7.1 (K), J1.1, J6.1, J7.1, J10.1, NT1.2, R1.2, R2.2, R5.2, TP12.1, U2.2 (GND), U3.3 (GND), U4.3 (GND)
/HEATER_LOW: D4.2 (A), J3.2, Q1.2 (D)
/I2C_SCL: J6.3, U4.10 (SCL)
/I2C_SDA: J6.2, U4.9 (SDA)
/LED_B_D5: D5.2 (A), R9.2
/LED_B_D6: D6.2 (A), R10.2
/LED_B_D7: D7.2 (A), R11.2
/LED_B_D8: D8.2 (A), R12.2
/NTC_ADC: C4.1, R6.2, TP7.1, U4.4 (AIN0)
/NTC_RAW: J4.2, R5.1, R6.1, TP6.1
/PGND: C6.2, C7.2, C8.2, C9.2, D2.1 (A1), D5.1 (K), D8.1 (K), D9.2 (A), J2.2, NT1.1, Q1.3 (S), R4.2, R8.2, R13.2, TP1.1, U1.3 (GND), U1.5 (~ON/OFF), U5.2 (GND), U5.4 (IN-)
/PWM0: J7.2, R1.1, TP8.1, U3.1
/REV_GATE: D3.2 (A), Q2.1 (G), R8.1
/VIN_FUSED: F1.2, Q2.2 (D)
/VIN_PROTECTED: C8.1, C9.1, D2.2 (A2), D3.1 (K), D4.1 (K), J3.1, Q2.3 (S), R9.1, TP2.1, U1.1 (VIN)
/VIN_RAW: F1.1, J2.1

Notes on the sheet:
B1 - 24 V DC / 100 W MAX HEATER DESIGN TARGET
Regulated 24 V supply only. F1 is a short-circuit protection candidate, not a 100 W limiter. PMOS: drain = fused input, source = protected output. Zener cathode at source. TVS clamping/transient margin of the purchased 32 V module is NOT qualified; no industrial surge claim.
Integrated LM2596 fixed 5V. NT1 joins PGND/GND at input star; heater return stays separate. F2 remains 1A. USB source sharing and thermal/fault qualification still pending.
B3 - PWM AND ENABLE / 5 V GATE DRIVE
B4 - NTC / ADS1115 ADDRESS 0x49
24 V / 100 W at 500 Hz PWM is a PROTOTYPE target. Independent thermal cutoff still required for unattended use. Firmware must handle open/short NTC, stale ADC, fault shutdown and explicit enable. No firmware changes in this revision.
DIAGNOSTICS - RAIL PRESENCE AND HEATER GATE DRIVE
D5 / 24V
D6 / 5V
D7 / 3V3
D8 / HEAT
Green LEDs show rail presence only, not regulated voltage accuracy or ESP32 execution. HEAT (B/D8): 5 V driver output after PWM AND ENABLE; brightness follows duty, NOT measured heater current. NTC on B/J4: 1 = +3V3_B, 2 = NTC_RAW; passive two-wire 15k B3920 probe, either wire orientation.
B5 - INTEGRATED BUCK / FIXED 5V / SYSTEM BUDGET 0.8A
C8 is the local 100uF/50V input reservoir; C9 is HF bypass. C10 negative returns through R13. LM2596 tab/pin 3 = PGND. Pin 5 hard-wired low (buck always enabled with 24V present). NT1 is a copper net tie, not an isolation barrier. No external XL4015 or J8/J9. Matched electrical study: hardware/powe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
BENCH TEST PADS - BACK SIDE B.Cu - COPPER ONLY, DO NOT POPULATE
UART EXTENSION - J10 - 3.3 V LOGIC, NOT RS232 VOLTAGE LEVELS
1 GND / 2 TX_A -> RX_B / 3 RX_A <- TX_B. Straight cable; no supply rail.
B temperature: contacts 2 and 3 intentionally NC; connector fitted for interface compatibility.
Reserved extension; future B must implement its UART peripheral/transceiver. No hot-plug.

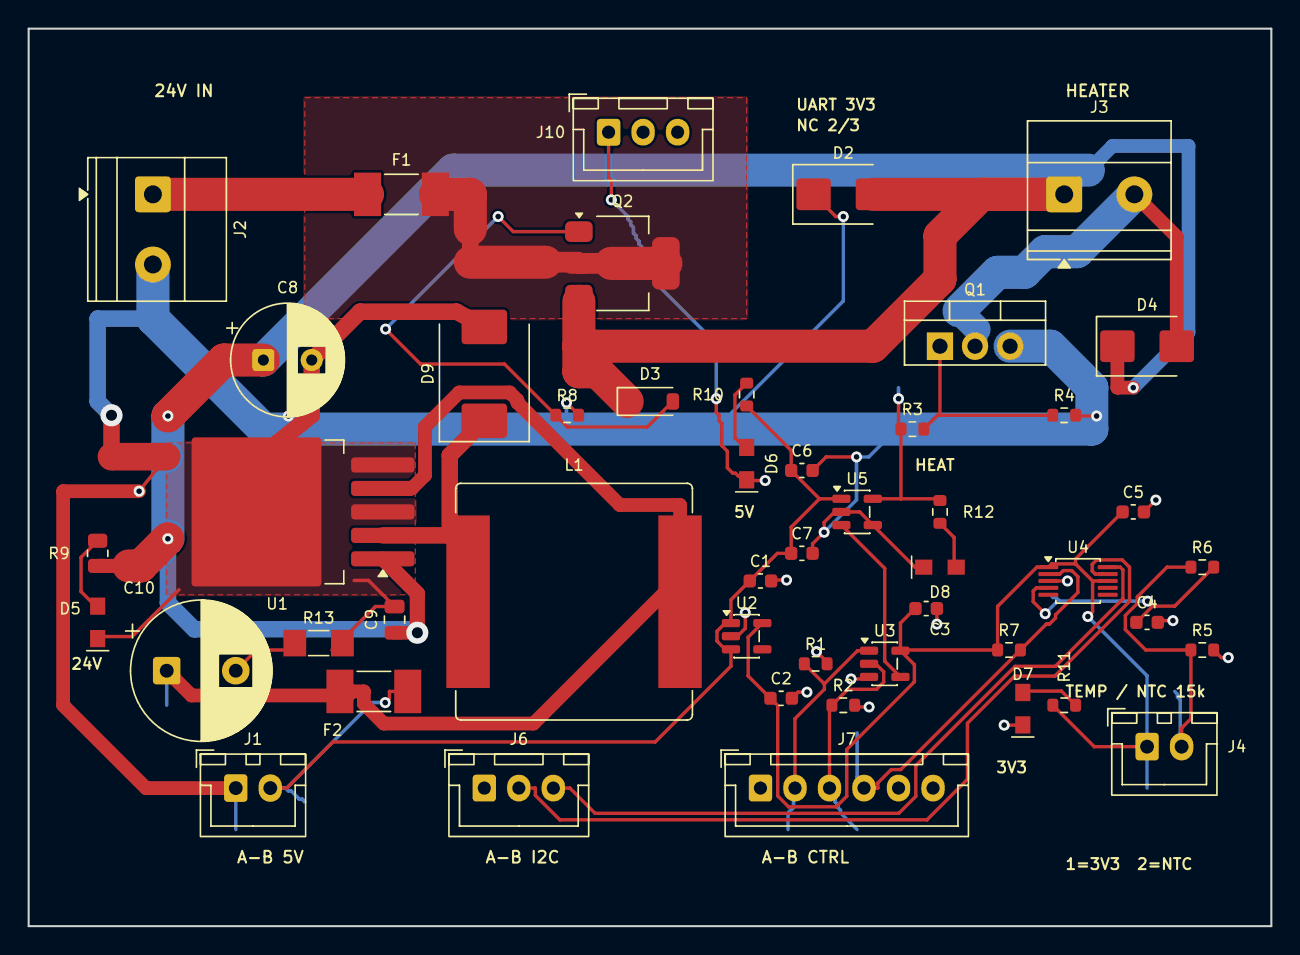
[picture p75: board pcb_b_temperature.kicad_pcb from above]

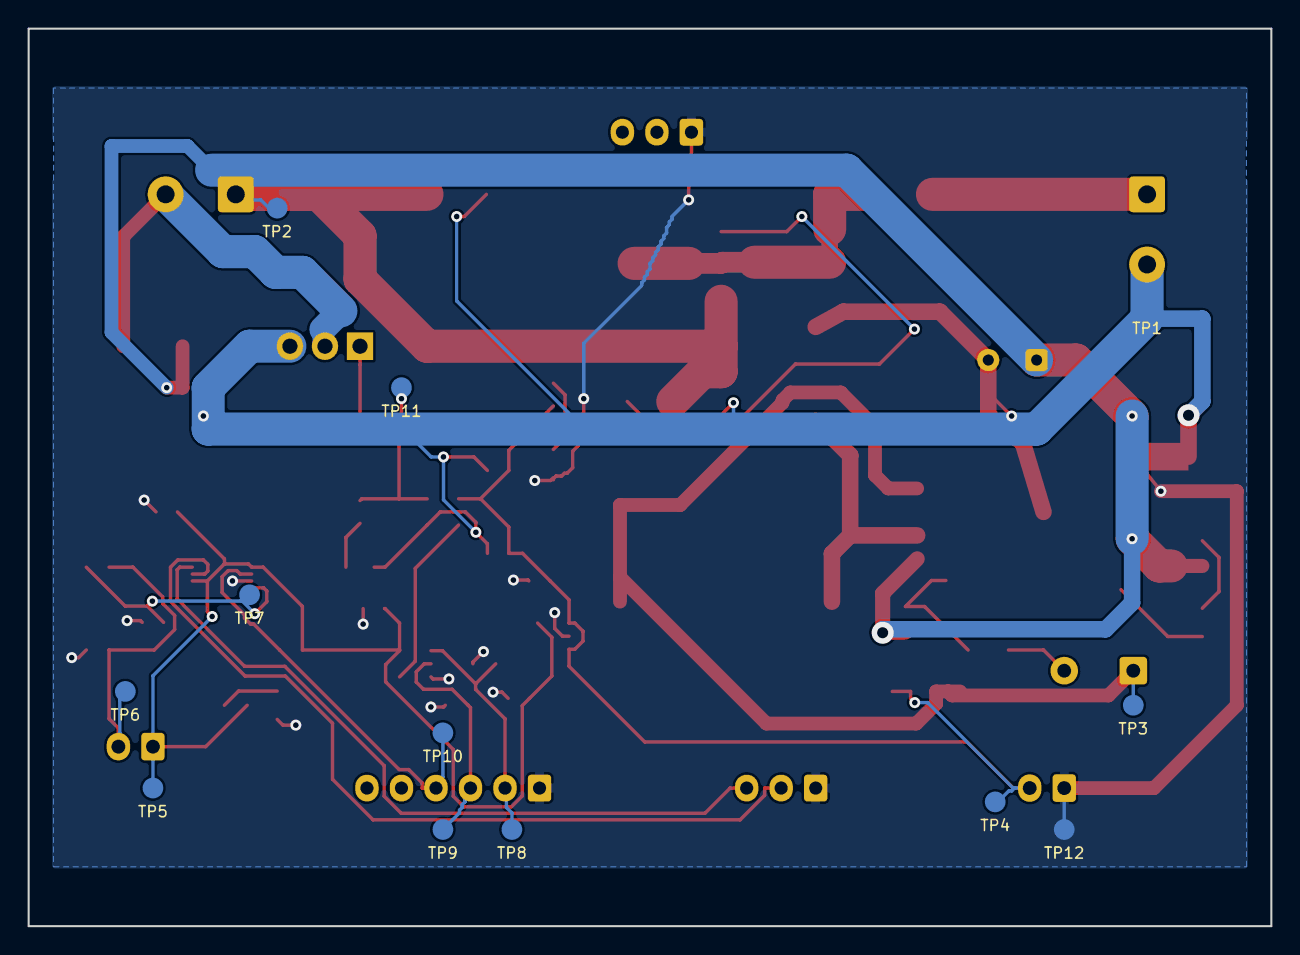
[picture p76: board pcb_b_temperature.kicad_pcb from below]

Board: 2 copper layers, 90.0 x 65.0 mm, 61 parts (12 on the bottom side), 26 nets.
