gcharvin/esp32_temperature_controller_platformio/hardware/pcb_a_display/pcb_a_display.kicad_pcb

## KiCad design hardware/pcb_a_display/pcb_a_display.kicad_pcb (2026-11-10)

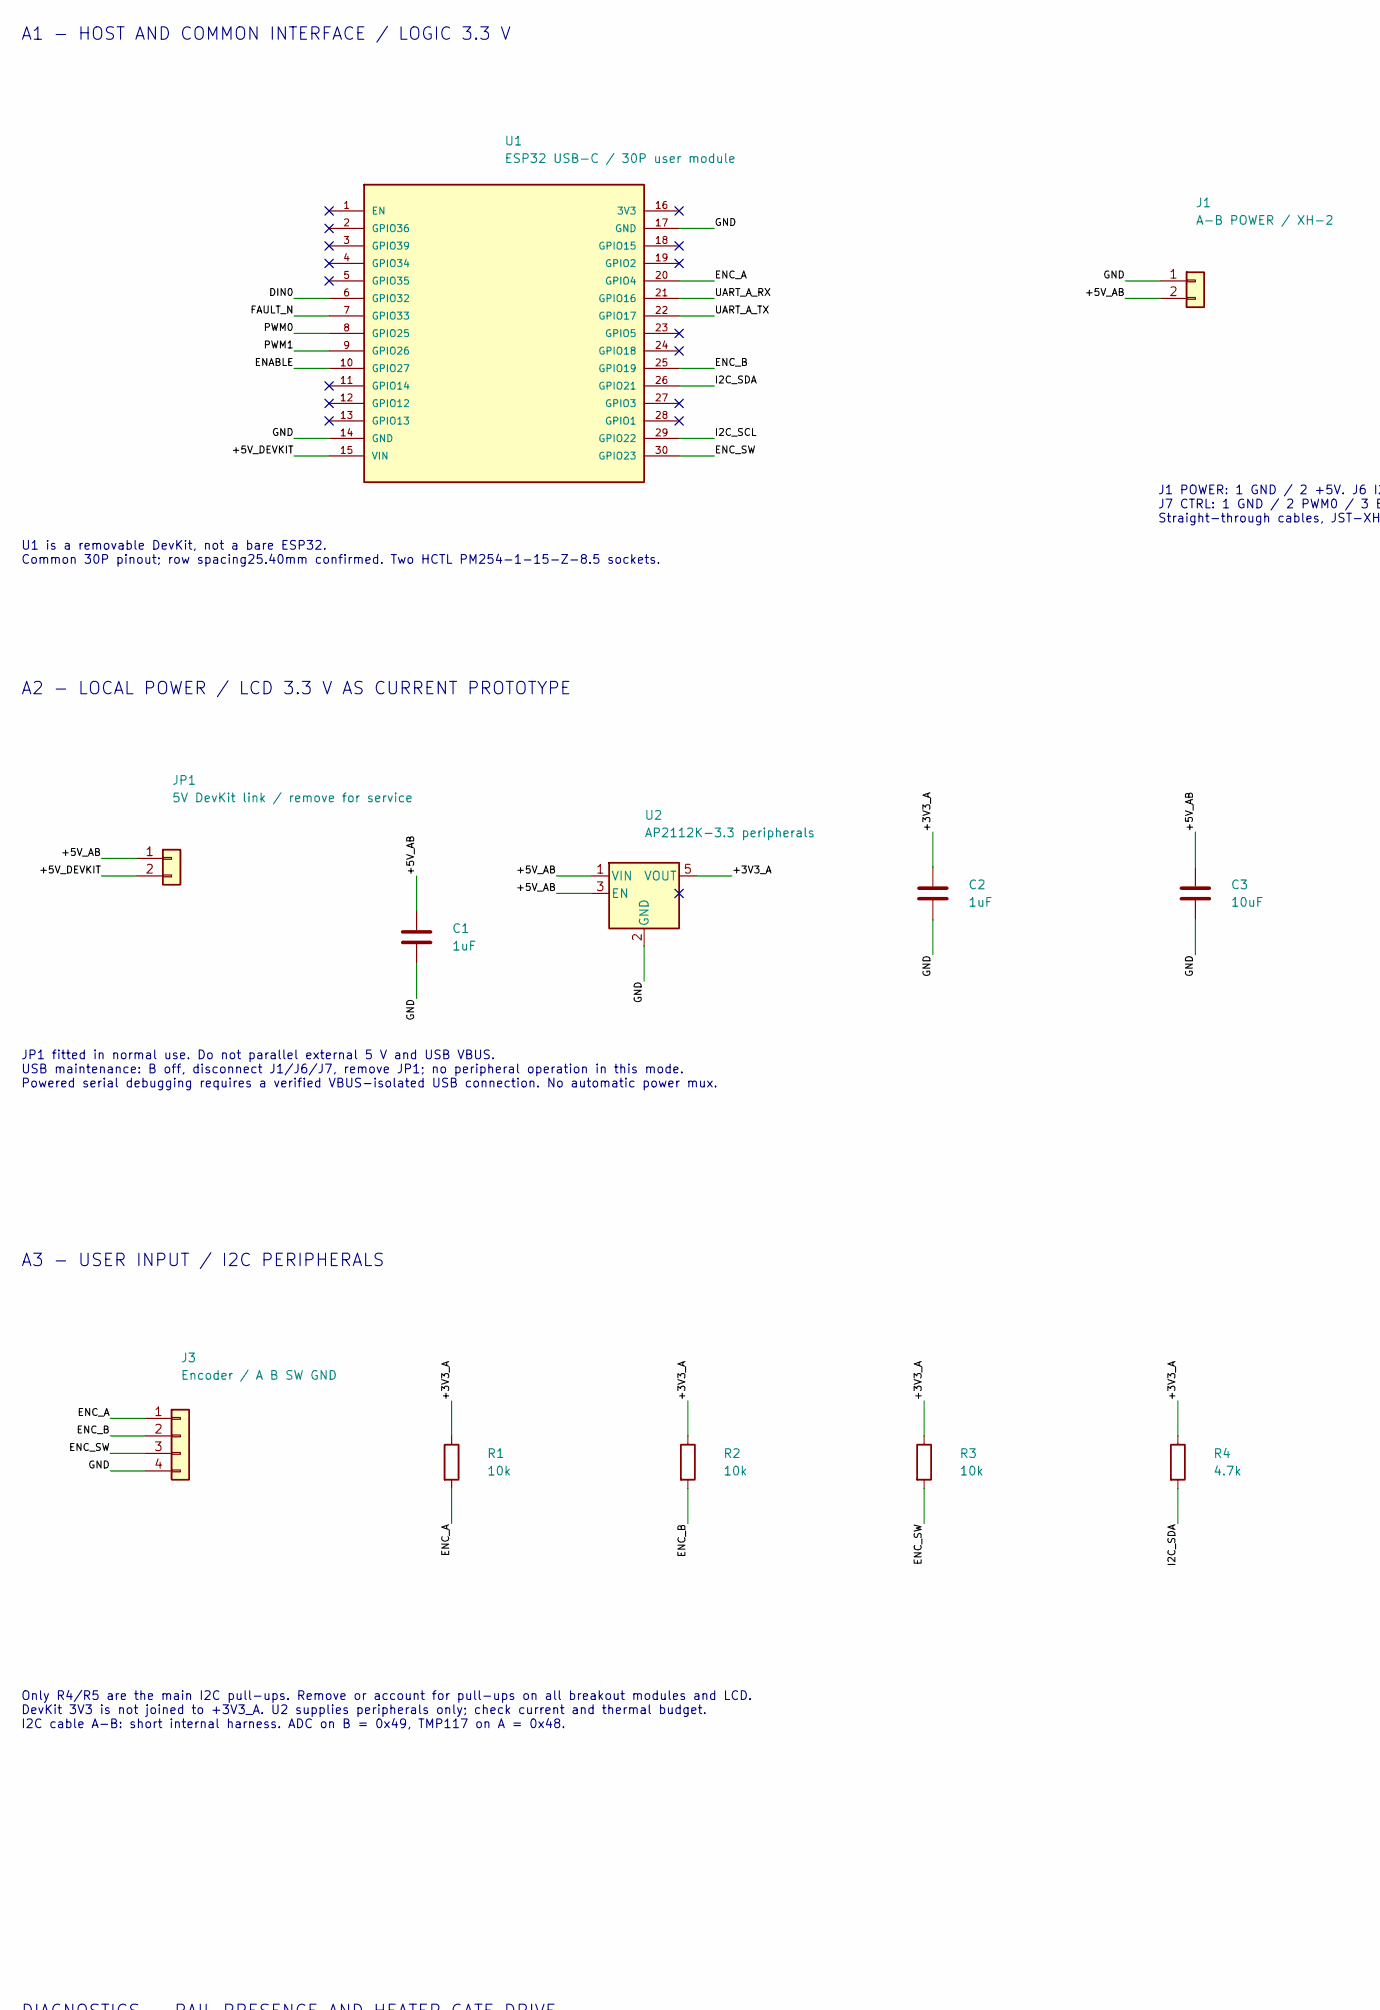
[picture p77: schematic pcb_a_display.kicad_sch, PCB A - Display and ESP32 carrier, part in row 1, column 1]

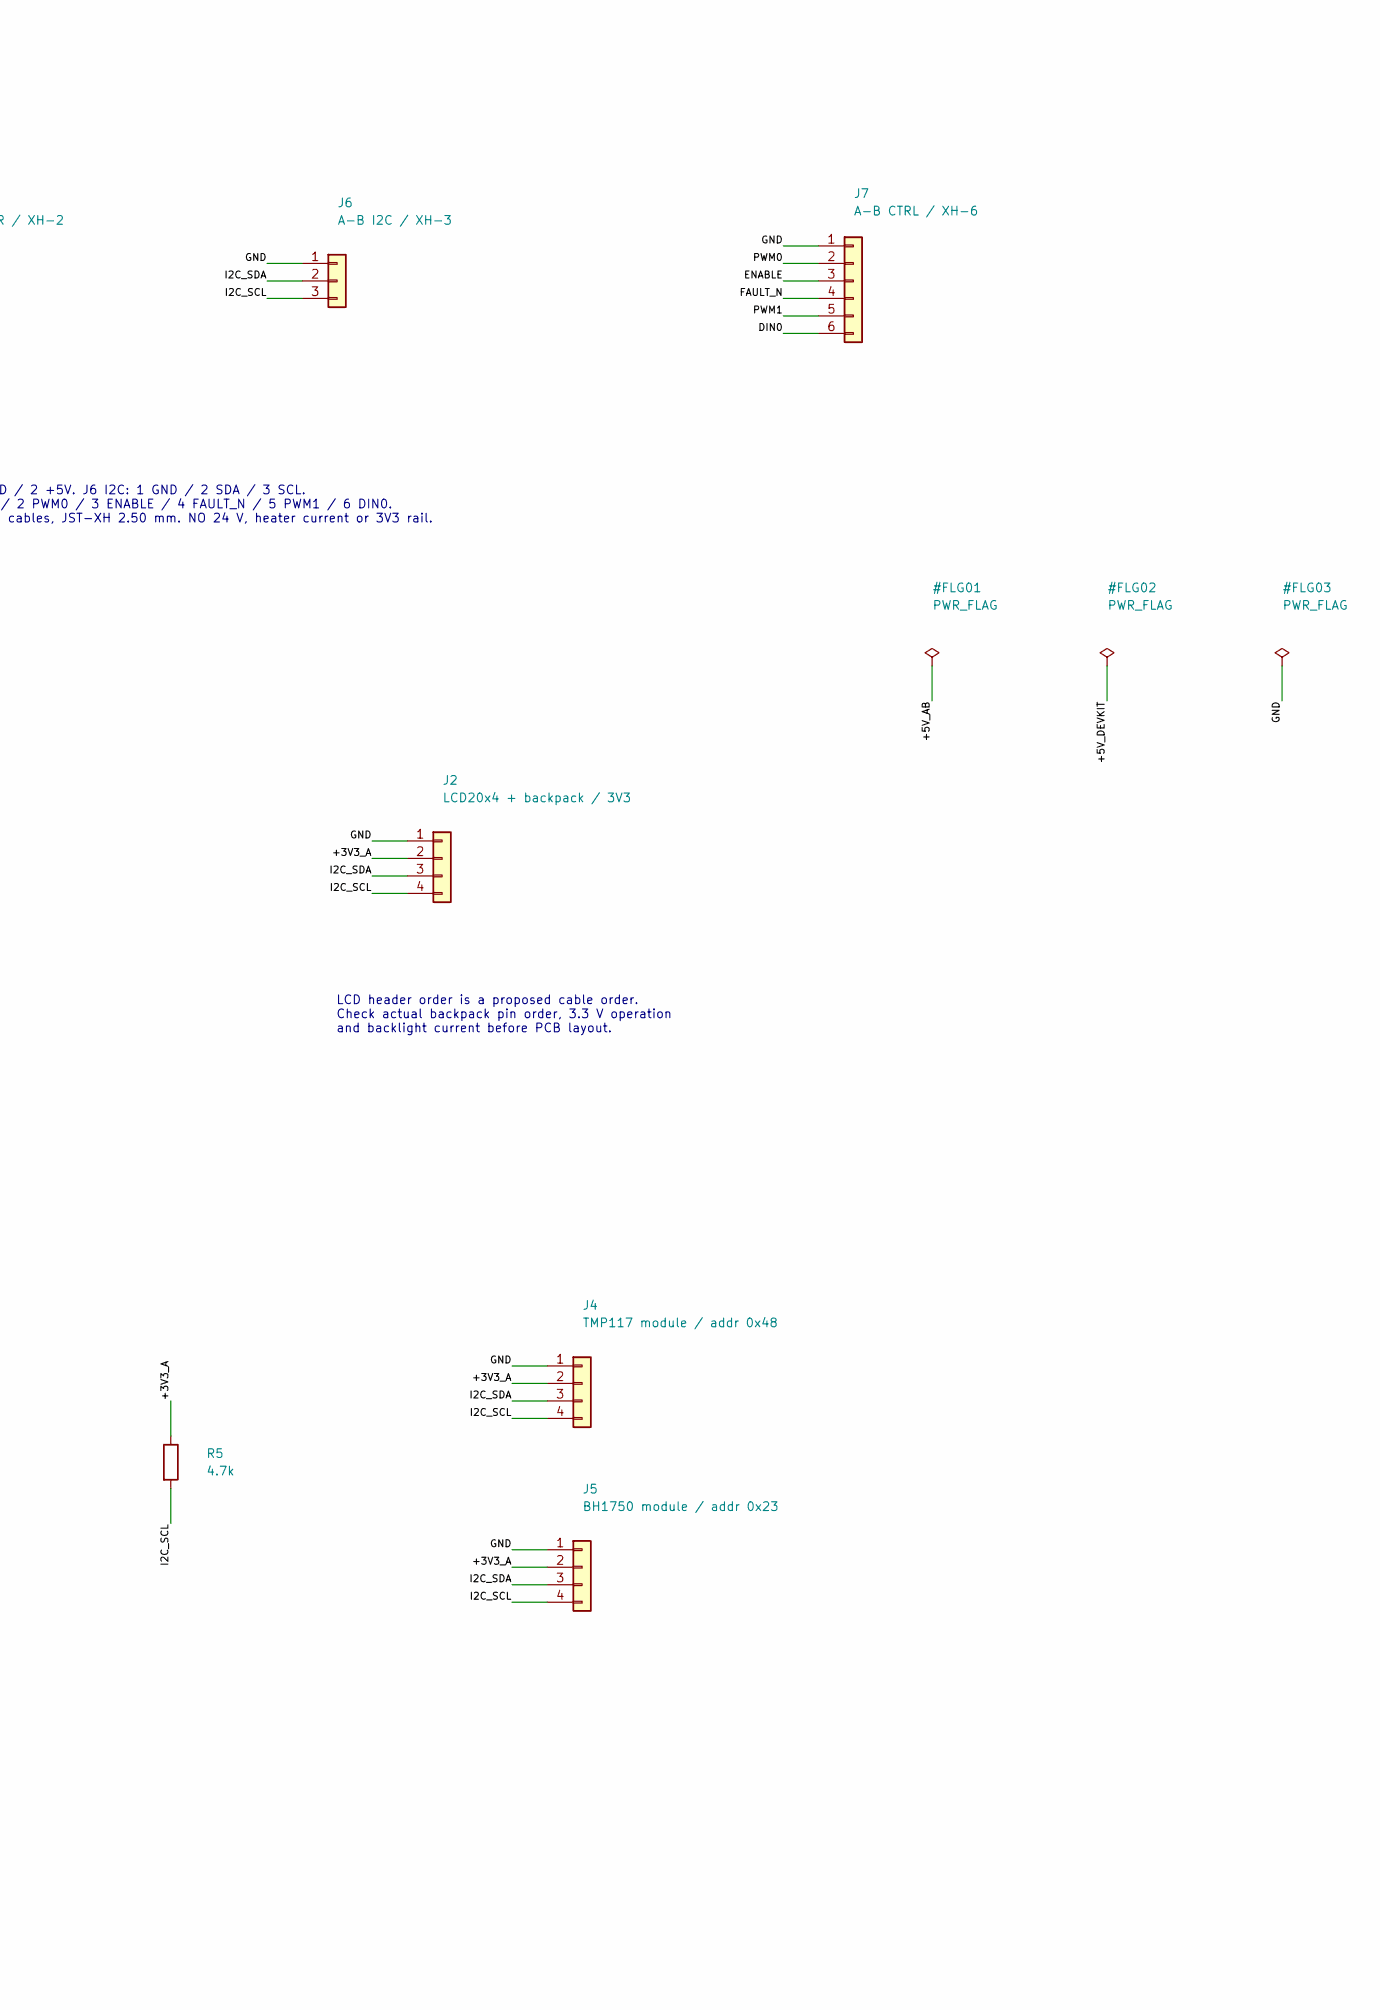
[picture p78: schematic pcb_a_display.kicad_sch, PCB A - Display and ESP32 carrier, part in row 1, column 2]

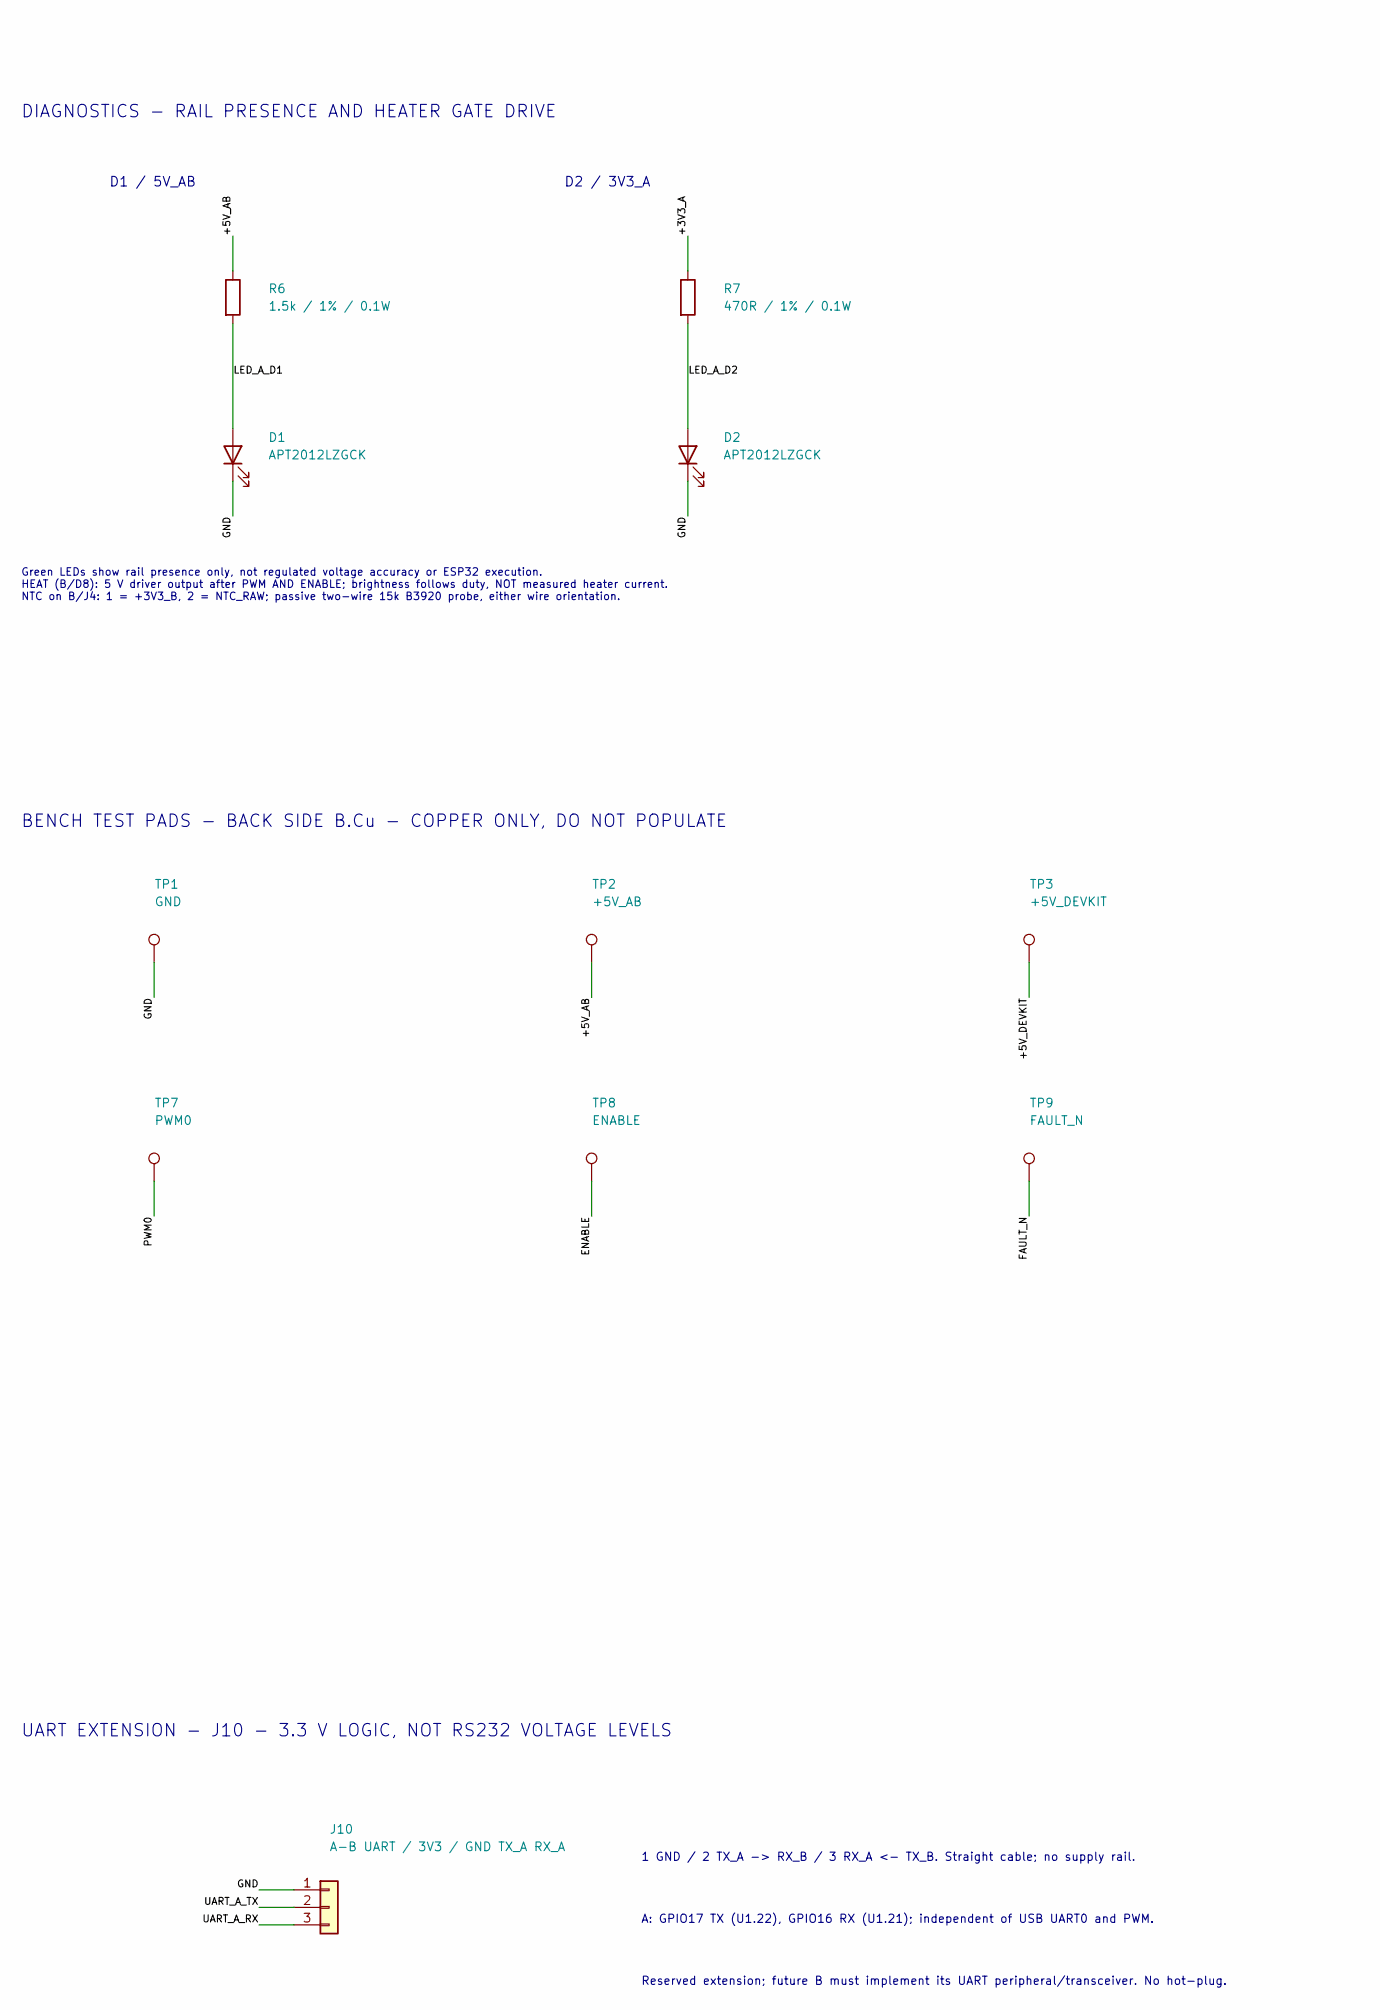
[picture p79: schematic pcb_a_display.kicad_sch, PCB A - Display and ESP32 carrier, part in row 2, column 1]

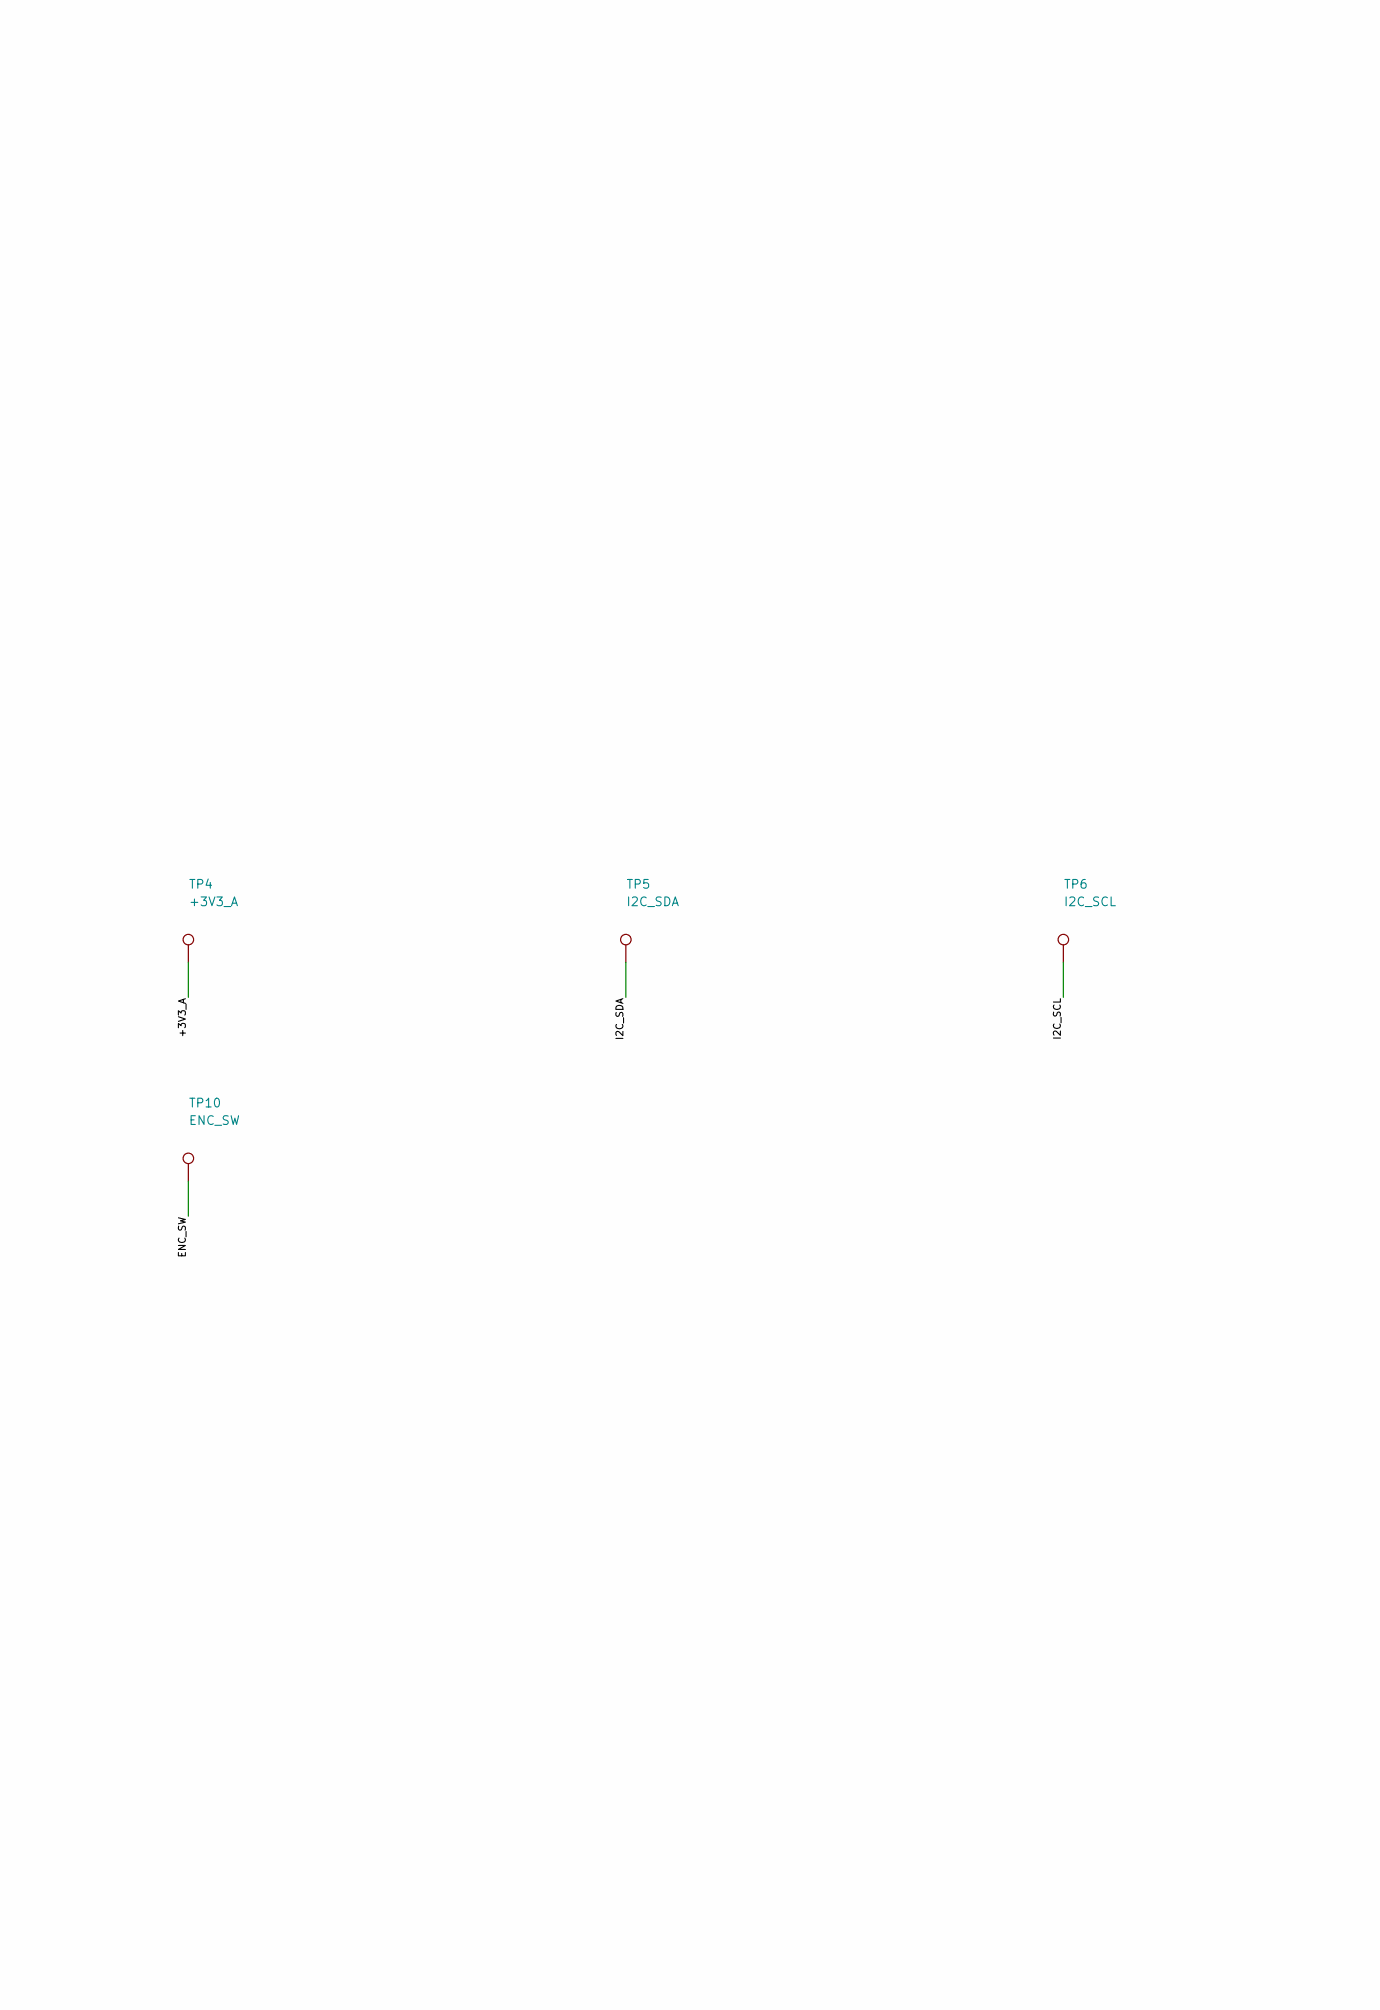
[picture p80: schematic pcb_a_display.kicad_sch, PCB A - Display and ESP32 carrier, part in row 2, column 2]

Parts:
C1, C2: 1uF; C_0603_1608Metric; MPN 0603B105K160CT
C3: 10uF; C_0603_1608Metric; MPN CL10A106KP8NNNC
D1, D2: APT2012LZGCK; LED_Kingbright_APT2012_Manufacturer; MPN APT2012LZGCK
J1: A-B POWER / XH-2; JST_XH_B2B-XH-A_1x02_P2.50mm_Vertical; MPN B2B-XH-A(LF)(SN)
J2: LCD20x4 + backpack / 3V3; JST_XH_B4B-XH-A_1x04_P2.50mm_Vertical; MPN B4B-XH-A(LF)(SN)
J3: Encoder / A B SW GND; JST_XH_B4B-XH-A_1x04_P2.50mm_Vertical; MPN B4B-XH-A(LF)(SN)
J4: TMP117 module / addr 0x48; JST_XH_B4B-XH-A_1x04_P2.50mm_Vertical; MPN B4B-XH-A(LF)(SN)
J5: BH1750 module / addr 0x23; JST_XH_B4B-XH-A_1x04_P2.50mm_Vertical; MPN B4B-XH-A(LF)(SN)
J6: A-B I2C / XH-3; JST_XH_B3B-XH-A_1x03_P2.50mm_Vertical; MPN B3B-XH-A(LF)(SN)
J7: A-B CTRL / XH-6; JST_XH_B6B-XH-A_1x06_P2.50mm_Vertical; MPN B6B-XH-A(LF)(SN)
J10: A-B UART / 3V3 / GND TX_A RX_A; JST_XH_B3B-XH-A_1x03_P2.50mm_Vertical; MPN B3B-XH-A(LF)(SN)
JP1: 5V DevKit link / remove for service; PinHeader_1x02_P2.54mm_Vertical; MPN M20-9990246
R1, R2, R3: 10k; R_0603_1608Metric; MPN RC0603FR-0710KL
R4, R5: 4.7k; R_0603_1608Metric; MPN RC0603FR-074K7L
R6: 1.5k / 1% / 0.1W; R_0603_1608Metric; MPN RC0603FR-071K5L
R7: 470R / 1% / 0.1W; R_0603_1608Metric; MPN RC0603FR-07470RL
TP1: GND; ProbePad_D1.5mm_NoPaste
TP2: +5V_AB; ProbePad_D1.5mm_NoPaste
TP3: +5V_DEVKIT; ProbePad_D1.5mm_NoPaste
TP4: +3V3_A; ProbePad_D1.5mm_NoPaste
TP5: I2C_SDA; ProbePad_D1.5mm_NoPaste
TP6: I2C_SCL; ProbePad_D1.5mm_NoPaste
TP7: PWM0; ProbePad_D1.5mm_NoPaste
TP8: ENABLE; ProbePad_D1.5mm_NoPaste
TP9: FAULT_N; ProbePad_D1.5mm_NoPaste
TP10: ENC_SW; ProbePad_D1.5mm_NoPaste
U1: ESP32 USB-C / 30P user module; ESP32_30P_HCTL_PM254_Rows25.40mm
U2: AP2112K-3.3 peripherals; SOT-23-5; MPN AP2112K-3.3TRG1

Connections:
/+3V3_A: C2.1, J2.2, J4.2, J5.2, R1.1, R2.1, R3.1, R4.1, R5.1, R7.1, TP4.1, U2.5 (VOUT)
/+5V_AB: C1.1, C3.1, J1.2, JP1.1, R6.1, TP2.1, U2.1 (VIN), U2.3 (EN)
/+5V_DEVKIT: JP1.2, TP3.1, U1.15 (VIN)
/DIN0: J7.6, U1.6 (GPIO32)
/ENABLE: J7.3, TP8.1, U1.10 (GPIO27)
/ENC_A: J3.1, R1.2, U1.20 (GPIO4)
/ENC_B: J3.2, R2.2, U1.25 (GPIO19)
/ENC_SW: J3.3, R3.2, TP10.1, U1.30 (GPIO23)
/FAULT_N: J7.4, TP9.1, U1.7 (GPIO33)
/GND: C1.2, C2.2, C3.2, D1.1 (K), D2.1 (K), J1.1, J2.1, J3.4, J4.1, J5.1, J6.1, J7.1, J10.1, TP1.1, U1.14 (GND), U1.17 (GND), U2.2 (GND)
/I2C_SCL: J2.4, J4.4, J5.4, J6.3, R5.2, TP6.1, U1.29 (GPIO22)
/I2C_SDA: J2.3, J4.3, J5.3, J6.2, R4.2, TP5.1, U1.26 (GPIO21)
/LED_A_D1: D1.2 (A), R6.2
/LED_A_D2: D2.2 (A), R7.2
/PWM0: J7.2, TP7.1, U1.8 (GPIO25)
/PWM1: J7.5, U1.9 (GPIO26)
/UART_A_RX: J10.3, U1.21 (GPIO16)
/UART_A_TX: J10.2, U1.22 (GPIO17)

Notes on the sheet:
A1 - HOST AND COMMON INTERFACE / LOGIC 3.3 V
J1 POWER: 1 GND / 2 +5V. J6 I2C: 1 GND / 2 SDA / 3 SCL. J7 CTRL: 1 GND / 2 PWM0 / 3 ENABLE / 4 FAULT_N / 5 PWM1 / 6 DIN0. Straight-through cables, JST-XH 2.50 mm. NO 24 V, heater current or 3V3 rail.
U1 is a removable DevKit, not a bare ESP32. Common 30P pinout; row spacing25.40mm confirmed. Two HCTL PM254-1-15-Z-8.5 sockets.
A2 - LOCAL POWER / LCD 3.3 V AS CURRENT PROTOTYPE
JP1 fitted in normal use. Do not parallel external 5 V and USB VBUS. USB maintenance: B off, disconnect J1/J6/J7, remove JP1; no peripheral operation in this mode. Powered serial debugging requires a verified VBUS-isolated USB connection. No automatic power mux.
LCD header order is a proposed cable order. Check actual backpack pin order, 3.3 V operation and backlight current before PCB layout.
A3 - USER INPUT / I2C PERIPHERALS
Only R4/R5 are the main I2C pull-ups. Remove or account for pull-ups on all breakout modules and LCD. DevKit 3V3 is not joined to +3V3_A. U2 supplies peripherals only; check current and thermal budget. I2C cable A-B: short internal harness. ADC on B = 0x49, TMP117 on A = 0x48.
DIAGNOSTICS - RAIL PRESENCE AND HEATER GATE DRIVE
D1 / 5V_AB
D2 / 3V3_A
Green LEDs show rail presence only, not regulated voltage accuracy or ESP32 execution. HEAT (B/D8): 5 V driver output after PWM AND ENABLE; brightness follows duty, NOT measured heater current. NTC on B/J4: 1 = +3V3_B, 2 = NTC_RAW; passive two-wire 15k B3920 probe, either wire orientation.
BENCH TEST PADS - BACK SIDE B.Cu - COPPER ONLY, DO NOT POPULATE
UART EXTENSION - J10 - 3.3 V LOGIC, NOT RS232 VOLTAGE LEVELS
1 GND / 2 TX_A -> RX_B / 3 RX_A <- TX_B. Straight cable; no supply rail.
A: GPIO17 TX (U1.22), GPIO16 RX (U1.21); independent of USB UART0 and PWM.
Reserved extension; future B must implement its UART peripheral/transceiver. No hot-plug.

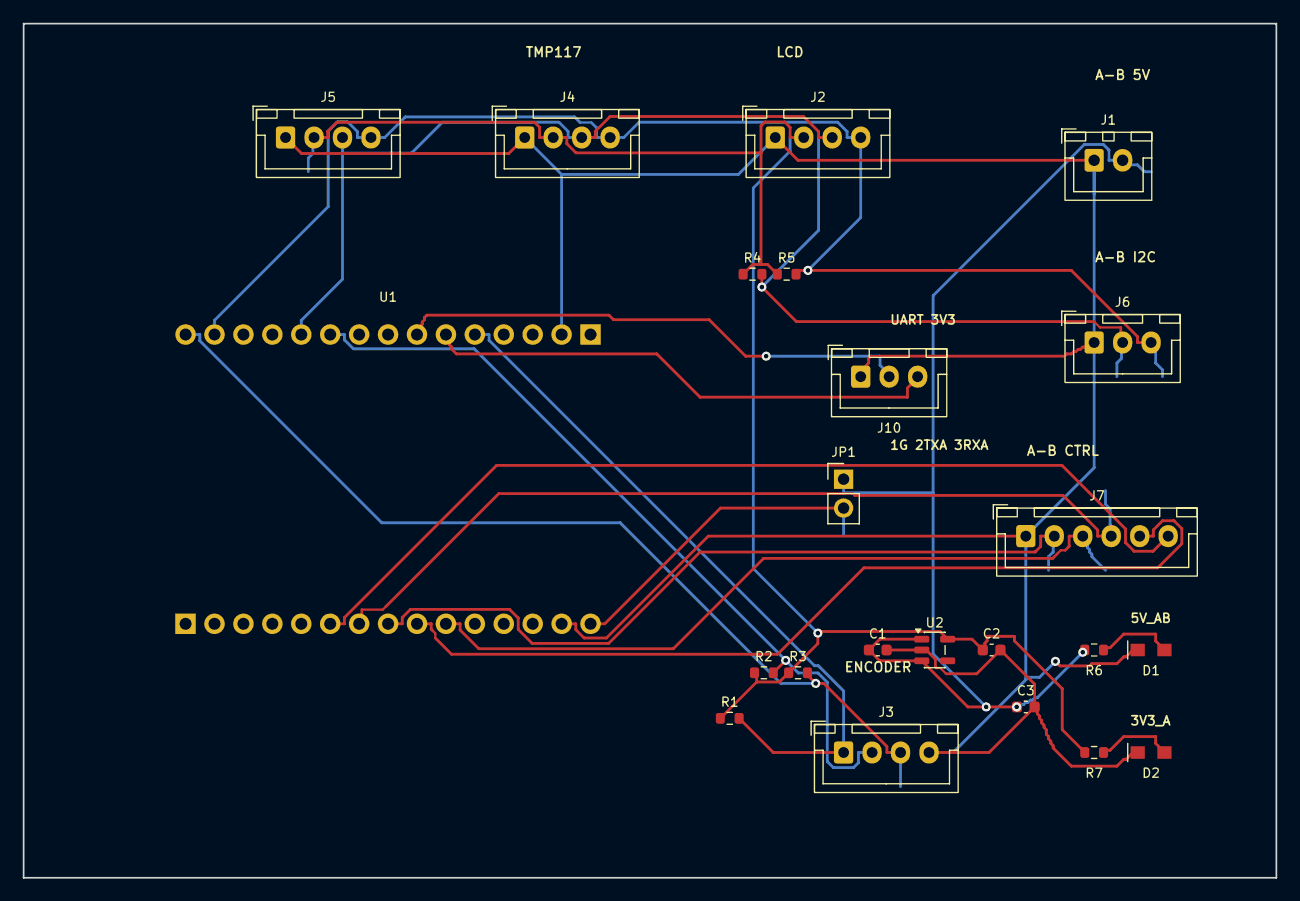
[picture p81: board pcb_a_display.kicad_pcb from above]

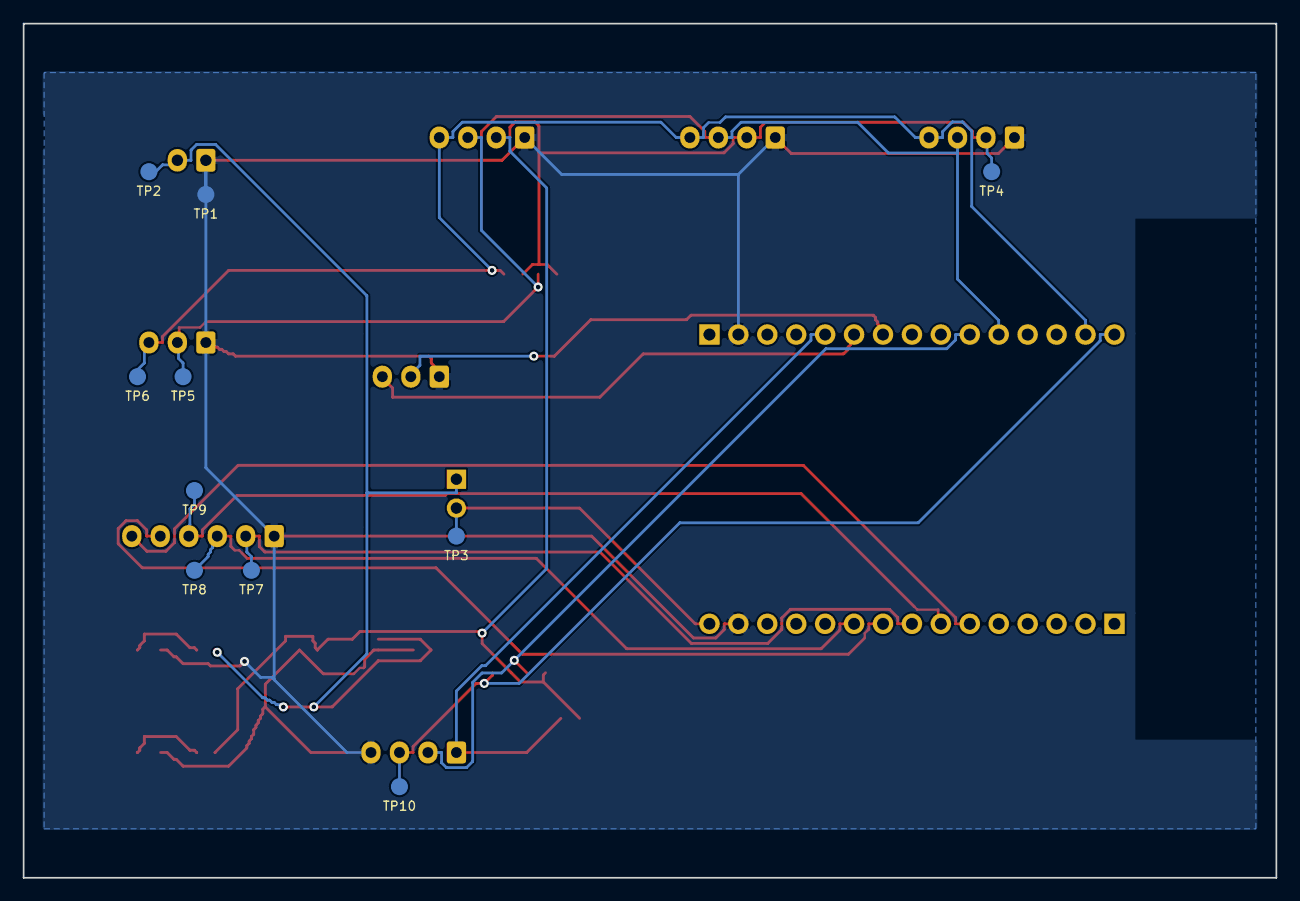
[picture p82: board pcb_a_display.kicad_pcb from below]

Board: 2 copper layers, 110.0 x 75.0 mm, 33 parts (10 on the bottom side), 18 nets.
