gcharvin/esp32_temperature_controller_platformio/hardware/power_study/buck_5v/buck_5v.kicad_sch

## KiCad design hardware/power_study/buck_5v/buck_5v.kicad_sch (2026-11-05)

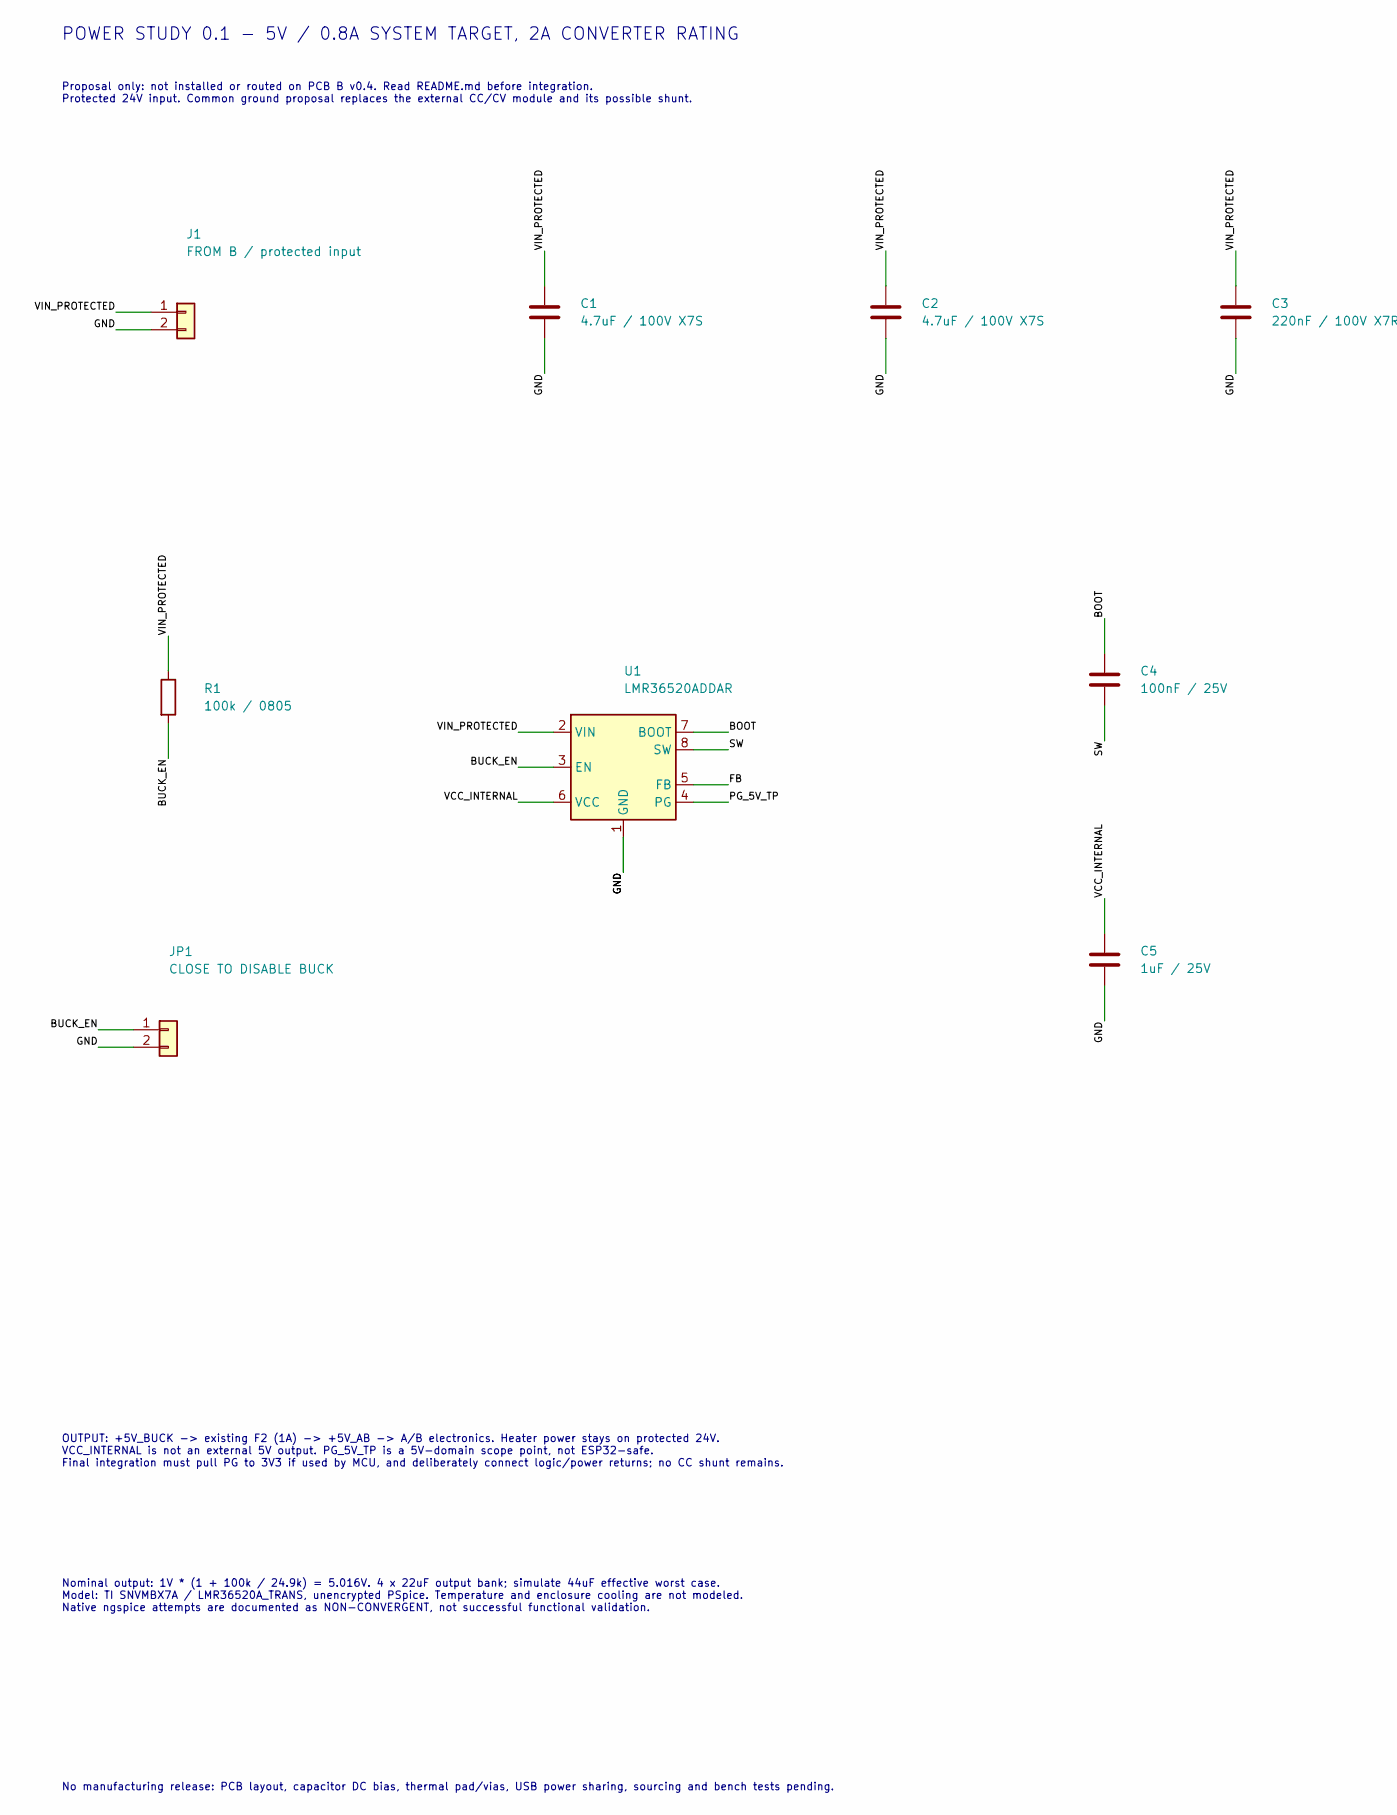
[picture p83: schematic buck_5v.kicad_sch, part in row 1, column 1]

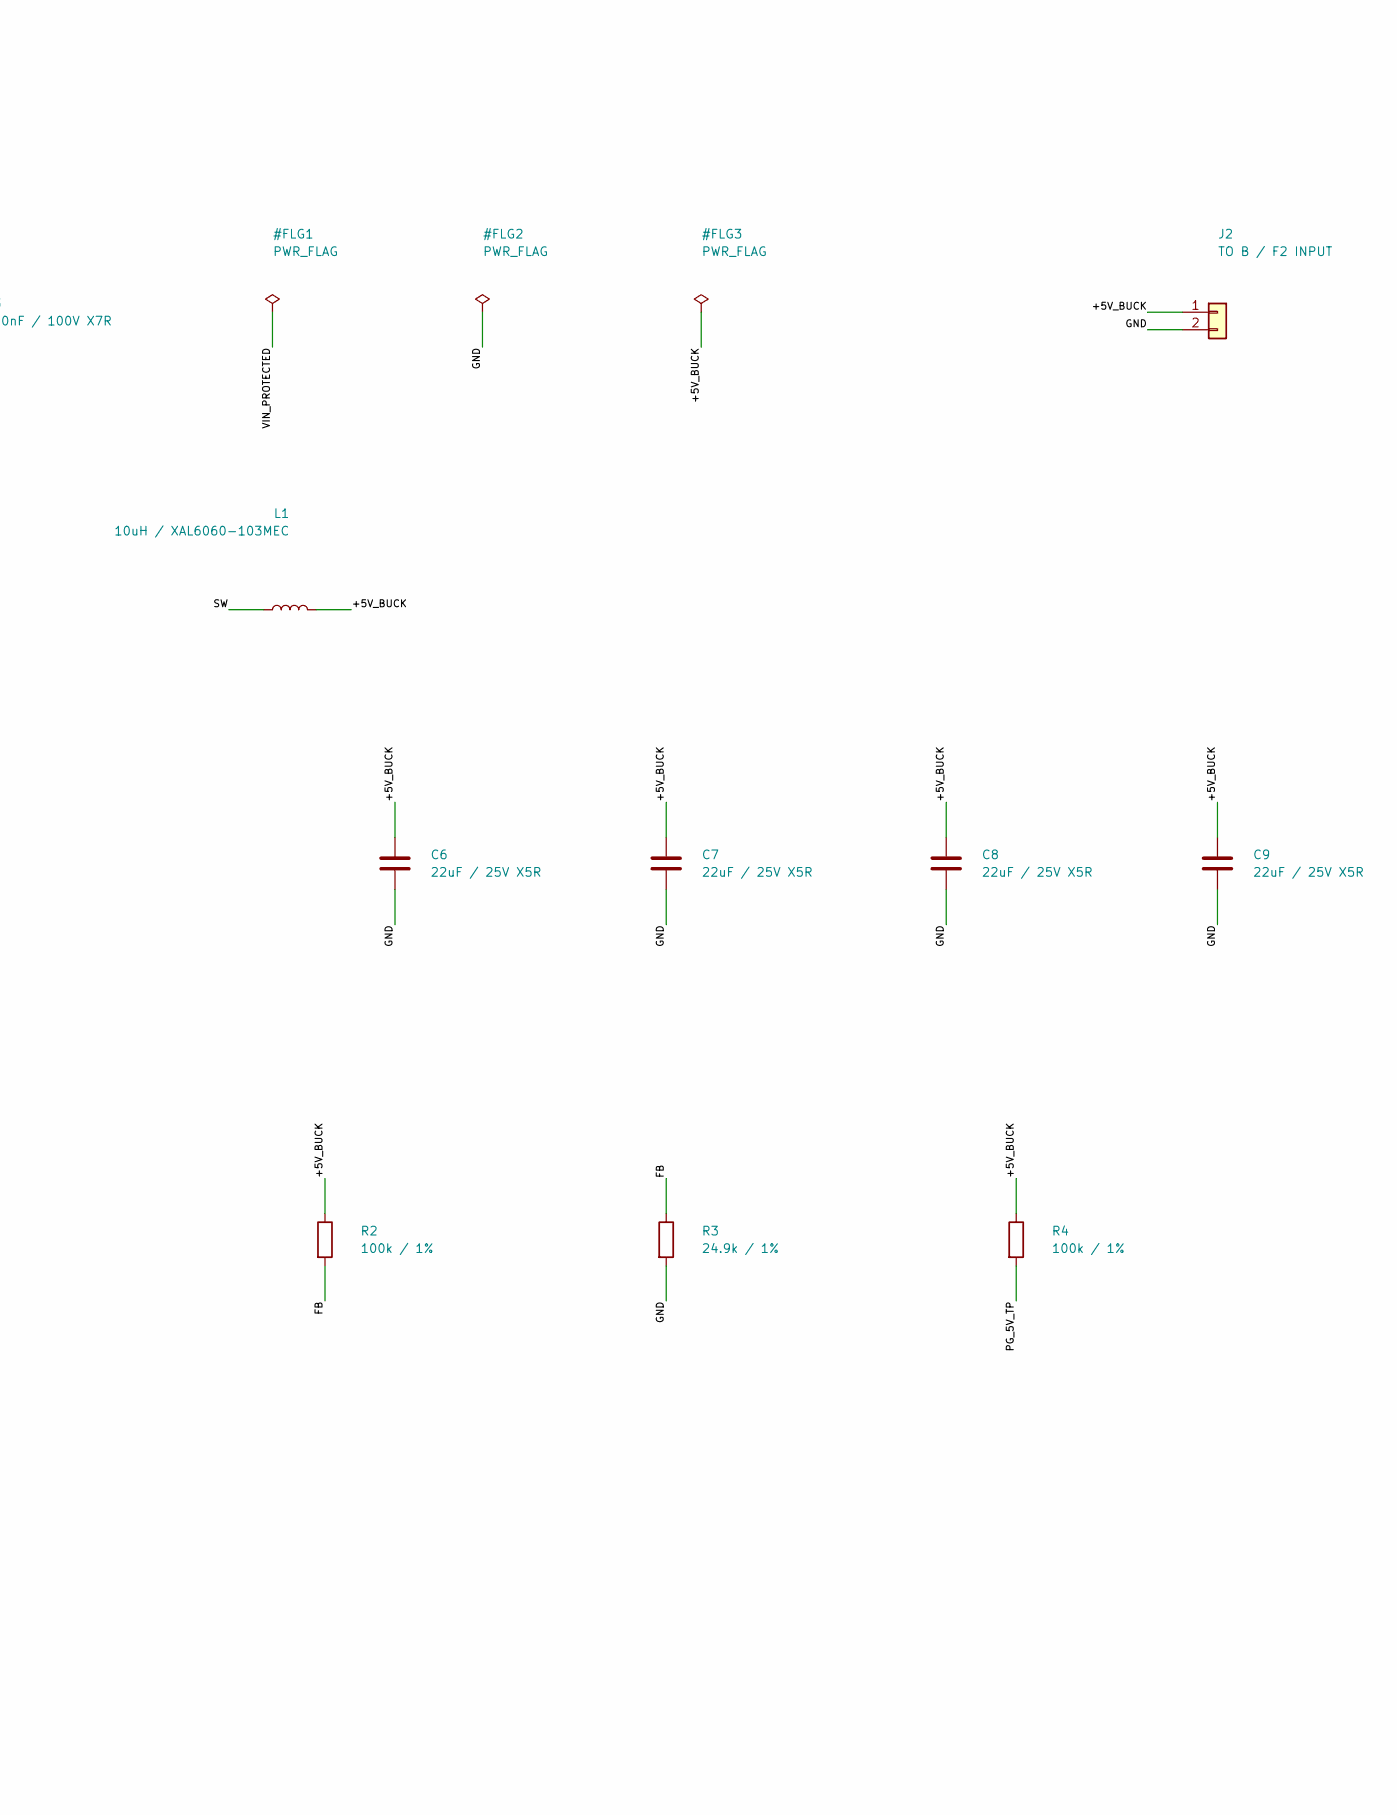
[picture p84: schematic buck_5v.kicad_sch, part in row 1, column 2]

Parts:
C1, C2: 4.7uF / 100V X7S; C_1210_3225Metric
C3: 220nF / 100V X7R; C_0805_2012Metric
C4: 100nF / 25V; C_0603_1608Metric
C5: 1uF / 25V; C_0603_1608Metric
C6, C7, C8, C9: 22uF / 25V X5R; C_1210_3225Metric
J1: FROM B / protected input
J2: TO B / F2 INPUT
JP1: CLOSE TO DISABLE BUCK; PinHeader_1x02_P2.54mm_Vertical
L1: 10uH / XAL6060-103MEC; L_Coilcraft_XAL6060-XXX
R1: 100k / 0805; R_0805_2012Metric
R2, R4: 100k / 1%; R_0603_1608Metric
R3: 24.9k / 1%; R_0603_1608Metric
U1: LMR36520ADDAR; Texas_HSOP-8-1EP_3.9x4.9mm_P1.27mm_ThermalVias

Connections:
+5V_BUCK: C6.1, C7.1, C8.1, C9.1, J2.1, L1.2, R2.1, R4.1
BOOT: C4.1, U1.7 (BOOT)
BUCK_EN: JP1.1, R1.2, U1.3 (EN)
FB: R2.2, R3.1, U1.5 (FB)
GND: C1.2, C2.2, C3.2, C5.2, C6.2, C7.2, C8.2, C9.2, J1.2, J2.2, JP1.2, R3.2, U1.1 (GND), U1.9 (GND)
PG_5V_TP: R4.2, U1.4 (PG)
SW: C4.2, L1.1, U1.8 (SW)
VCC_INTERNAL: C5.1, U1.6 (VCC)
VIN_PROTECTED: C1.1, C2.1, C3.1, J1.1, R1.1, U1.2 (VIN)

Notes on the sheet:
POWER STUDY 0.1 - 5V / 0.8A SYSTEM TARGET, 2A CONVERTER RATING
Proposal only: not installed or routed on PCB B v0.4. Read README.md before integration. Protected 24V input. Common ground proposal replaces the external CC/CV module and its possible shunt.
OUTPUT: +5V_BUCK -> existing F2 (1A) -> +5V_AB -> A/B electronics. Heater power stays on protected 24V. VCC_INTERNAL is not an external 5V output. PG_5V_TP is a 5V-domain scope point, not ESP32-safe. Final integration must pull PG to 3V3 if used by MCU, and deliberately connect logic/power returns;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
Nominal output: 1V * (1 + 100k / 24.9k) = 5.016V. 4 x 22uF output bank; simulate 44uF effective worst case. Model: TI SNVMBX7A / LMR36520A_TRANS, unencrypted PSpice. Temperature and enclosure cooling are not modeled. Native ngspice attempts are documented as NON-CONVERGENT, not successful functiona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
No manufacturing release: PCB layout, capacitor DC bias, thermal pad/vias, USB power sharing, sourcing and bench tests pending.
