gcharvin/esp32_temperature_controller_platformio/hardware/power_study/kicad_simulation/disable/lm2596_5v_disable.kicad_sch

## KiCad design hardware/power_study/kicad_simulation/disable/lm2596_5v_disable.kicad_sch (2026-11-05)

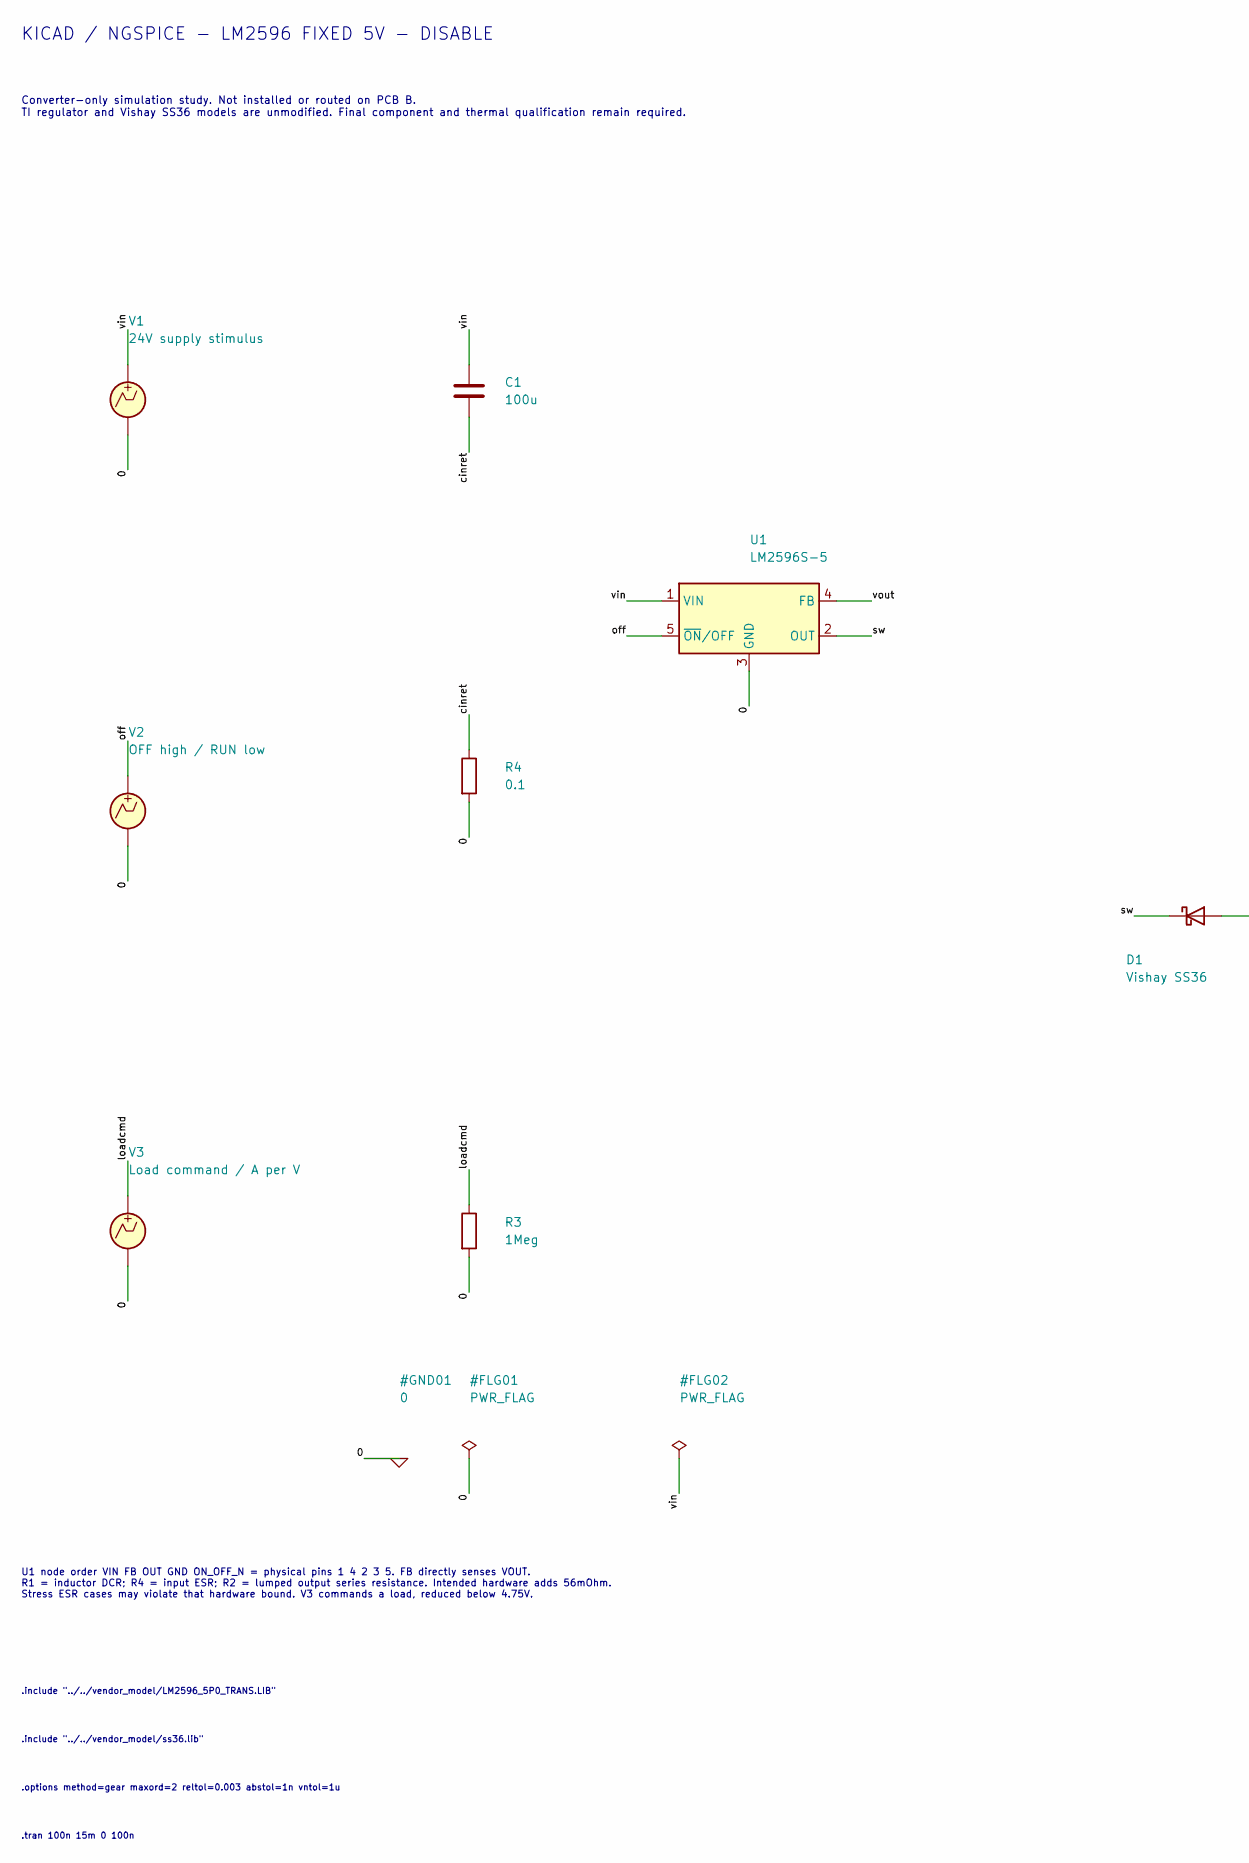
[picture p85: schematic lm2596_5v_disable.kicad_sch, part in row 1, column 1]

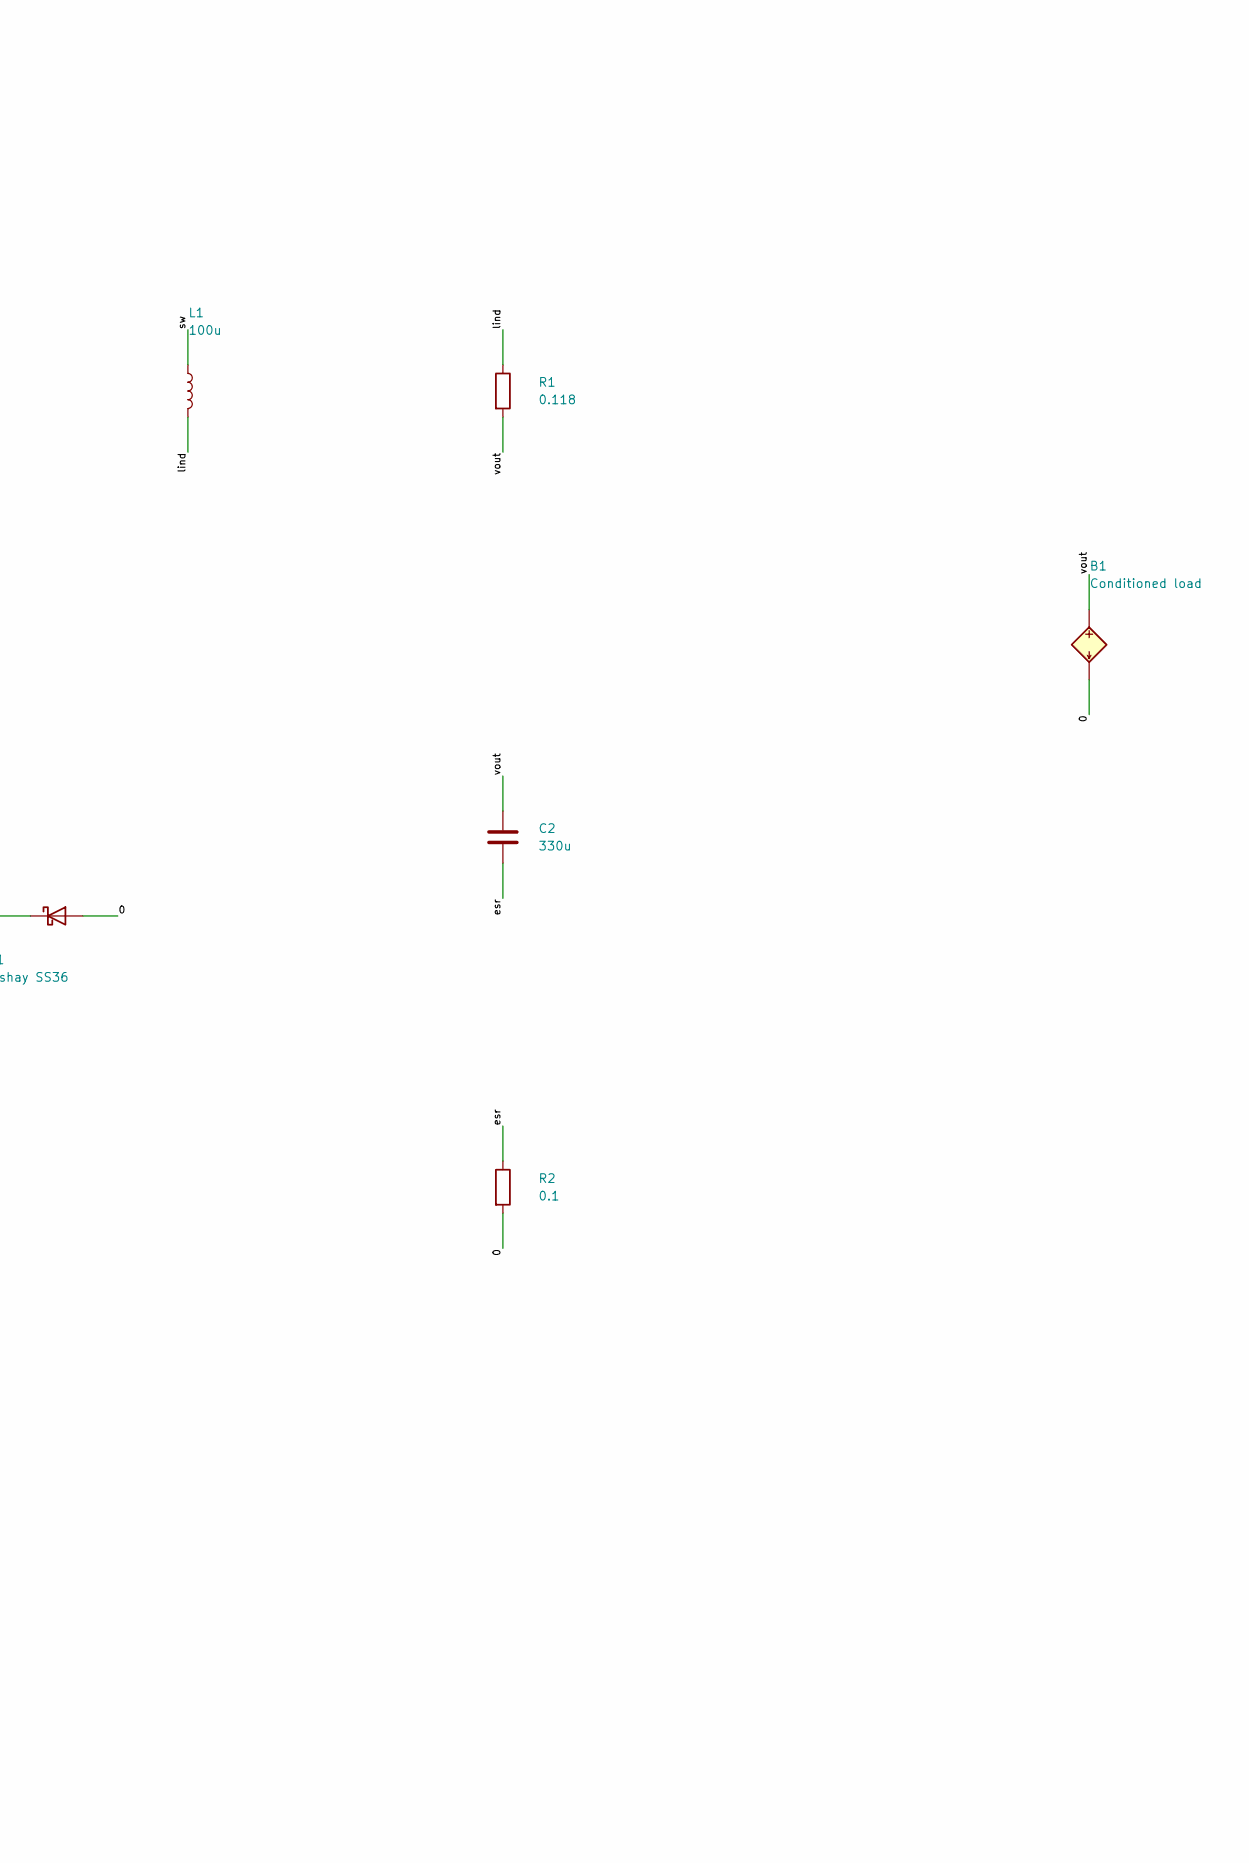
[picture p86: schematic lm2596_5v_disable.kicad_sch, part in row 1, column 2]

Parts:
B1: Conditioned load
C1: 100u
C2: 330u
D1: Vishay SS36
L1: 100u
R1: 0.118
R2, R4: 0.1
R3: 1Meg
U1: LM2596S-5
V1: 24V supply stimulus
V2: OFF high / RUN low
V3: Load command / A per V

Connections:
0: B1.2 (N-), D1.2 (A), R2.2, R3.2, R4.2, U1.3 (GND), V1.2, V2.2, V3.2
cinret: C1.2, R4.1
esr: C2.2, R2.1
lind: L1.2, R1.1
loadcmd: R3.1, V3.1
off: U1.5 (~ON/OFF), V2.1
sw: D1.1 (K), L1.1, U1.2 (OUT)
vin: C1.1, U1.1 (VIN), V1.1
vout: B1.1 (N+), C2.1, R1.2, U1.4 (FB)

Notes on the sheet:
KICAD / NGSPICE - LM2596 FIXED 5V - DISABLE
Converter-only simulation study. Not installed or routed on PCB B. TI regulator and Vishay SS36 models are unmodified. Final component and thermal qualification remain required.
U1 node order VIN FB OUT GND ON_OFF_N = physical pins 1 4 2 3 5. FB directly senses VOUT. R1 = inductor DCR; R4 = input ESR; R2 = lumped output series resistance. Intended hardware adds 56mOhm. Stress ESR cases may violate that hardware bound. V3 commands a load, reduced below 4.75V.
.include "../../vendor_model/LM2596_5P0_TRANS.LIB"
.include "../../vendor_model/ss36.lib"
.options method=gear maxord=2 reltol=0.003 abstol=1n vntol=1u
.tran 100n 15m 0 100n
