gcharvin/esp32_temperature_controller_platformio/(commit log)

2026-01-08 integrated LCD I2C component
2026-02-11 with part list
    [PartList_PCB_A_B.xlsx, PartList_PCB_A_B_v2.xlsx]
2026-02-12 refactor pour séparation UI / métier
    [PartList_PCB_A_B_v2.xlsx]
2026-02-12 fixed room sensor
2026-11-05 Add PCB A/B KiCad drafts and removable-front enclosure v0.4
2026-11-05 Route PCB A/B for diymore DevKit and 24 V temperature control
    Finalize physical footprints and route both boards, with a wired off-board XL4015 and 70 um copper on B. Add native KiCad files, review exports and checks: ERC/DRC/parity pass with no unconnected items. DevKit spacing and thermal behavior remain prototype assumptions.
2026-11-05 Update enclosure v0.5 for separate XL4015 and diymore DevKit
    Add an independent rear-extractable buck carrier and widen the case to 155 mm. Preserve the removable LCD/A front and lateral USB. Include five connected print parts, STEP/STL exports, Fusion bundle, sources and documentation; 22 assembly/service checks pass without modeled collisions.
2026-11-05 Add diagnostic LEDs and temperature connector labels to PCB A/B
    Add two power indicators on A and three power indicators plus an enabled gate-drive indicator on B. Update native schematics, BOMs, placement, copper routing, review PDFs and the v0.4 bundle. Preserve existing tracks and vias; ERC/DRC/parity pass with no unconnected items.
2026-11-05 Add enclosure v0.6 side vents and integrated buck study
    Add 20 lateral ventilation openings while preserving guides, clips and USB access. Include STEP/STL exports, sources, documentation and bundles. Add a standalone LMR36520 buck proposal with KiCad schematic, analytical checks and five vendor-model PSpice benches. Geometry checks and study ERC pass; ngspice convergence and functional validation remain pending.
2026-11-05 Enable KiCad ngspice simulation for the 5 V buck
    Add native simulator projects, checksum-pinned model preparation, complete transient validation and review plots. Preserve unsuccessful LMR36520 compatibility experiments separately from the working LM2596 study.
2026-11-05 Integrate the LM2596 buck into PCB B v0.5
    Replace the external buck connections with a routed fixed 5 V supply and explicit ground star while preserving the board outline and external connectors. Include electrical review reports and the PCB-bound startup simulation; physical qualification remains pending.
2026-11-05 Adapt enclosure v0.7 to the integrated buck
    Remove the separate XL4015 carrier and bay while retaining the removable front, PCB rails and clips, side USB access and passive vents. Export four printable pieces and the Fusion-compatible STEP assembly, with seventeen assembly and service checks.
2026-11-05 Document hardware revisions and physical qualification tests
    Explain the KiCad simulation workflow, integrated buck selection and remaining hardware measurements before fabrication approval. Record electronics readiness separately from simulation and layout checks.
2026-11-05 Define the shared 5 V interface for future 12 V and 5 V modules
    Keep A independent of the upstream supply, document USB source-sharing constraints and qualify only an exploratory 12 V buck startup. Do not extend the current temperature board's input or heater-power ratings.
2026-11-05 Prepare a source-bound PCB fabrication and assembly review package
    Export draft Gerber and drill files, candidate procurement BOMs and matching SMT placement files after fresh ERC/DRC and native pad/net parity checks. Quote THT assembly and both DevKit sockets separately, track system parts and retain explicit pre-order and post-prototype gates. No fabrication release or order.
2026-11-05 Confirm the measured 25.4 mm DevKit row spacing
    Record the user's physical measurement, close only the row-spacing check and verify that the existing routed footprint matches. Refresh the procurement review and archive without changing PCB or enclosure geometry; other mechanical and USB checks remain open.
2026-11-05 Match supplier catalogue parts and define the assembly process
    Verify 36 exact manufacturer/MPN identities and populate matching supplier IDs without asserting live stock. Add a Standard-profile requirement for the 245 C LM2596, removable rail proposal, limited geometric DFM audit, local RFQ draft and USB service test procedure. Refresh the source-bound review bundle; retain sourcing and factory approval gates.
2026-11-05 Record non-destructive checks on the connected ESP32 boards
    Record the successful 4 MiB COM4 flash backup comparison and the COM8 boot observations and unsuccessful loader connections. Preserve both firmwares, keep flash images and raw logs private, and distinguish serial checks from unperformed VBUS isolation measurements.
2026-11-05 Record COM8 retry with confirmed BOOT held
    Retry identification at57600 baud after the user confirmed BOOT held. Record interrupted/corrupt serial data without attributing a hardware cause; no firmware was written.
2026-11-05 Record successful serial check after board and cable change
2026-11-05 Define the common host interface for the three USB-C DevKits
    Record the user's common-pinout confirmation and preserve the shared 2x15 sockets at25.4mm. Separate electrical mating from per-variant mechanical and VIN/VBUS qualification. Refresh the RFQ snapshot and record the third board's unsuccessful read-only loader attempts without changing firmware or native routing.
2026-11-05 Record USB-only ROM diagnostic on the third ESP32 board
2026-11-05 fix(hardware): match R13 lands to Vishay and revalidate enclosure
2026-11-05 feat(manufacturing): add assembly drawings and verified RFQ package
2026-11-05 feat(hardware): freeze prototype parts and finalize socket and LED footprints
2026-11-05 feat(manufacturing): complete source-bound prototype fabrication handoff
2026-11-06 docs(hardware): document Freenove backlight PWM and central power
2026-11-06 feat(enclosure): add removable BH1750 cassette and translucent window
2026-11-06 chore(fabrication): refresh source-bound handoff for enclosure v0.9
2026-11-06 docs(hardware): summarize requested business cards and valve control
2026-11-06 docs(hardware): confirm separate relay and MOSFET valve cards
2026-11-06 chore(fabrication): package JLCPCB DFM request for five assembled board pairs
2026-11-06 feat(hardware): add labelled rear probe pads to A and B
2026-11-06 feat(firmware): add inhibited bench diagnostics for prototype boards
2026-11-09 feat(enclosure): add compact probe jack and v0.10 fitting coupon
2026-11-09 docs(procurement): consolidate Amazon and GoTronic purchases and specify jacketed probe cables
2026-11-09 feat(procurement): add LCSC Cable RFQ for ten of each harness
2026-11-10 feat(hardware): add dedicated UART to A and B and refresh fabrication packages
2026-11-11 docs: add step-by-step PCB reception test protocol
